Cailynoo7/CalcKey/product/gallery/8fa5844386364da2.jpg

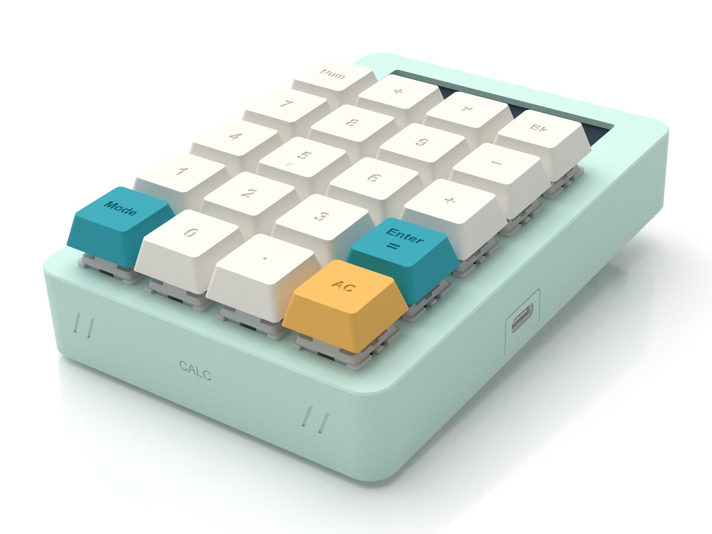
product/gallery/8fa5844386364da2.jpg
