Cailynoo7/CalcKey/product/gallery/calckey-mint-cover.png

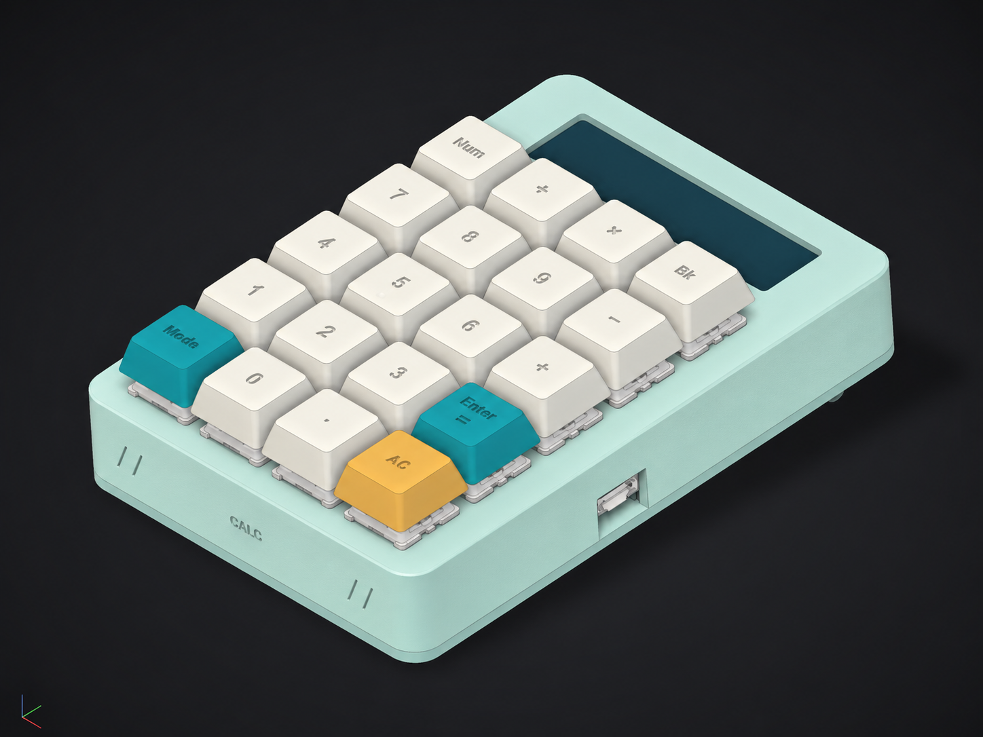
product/gallery/calckey-mint-cover.png
