Cailynoo7/CalcKey/product/README.md

# CalcKey 双模式数字键盘 / 计算器

## 产品目标

参考用户提供的EDA-Keypad，制作小型桌面设备：接电脑时作为扩展数字键盘；接USB充电器时独立计算。用户要求取消干电池并减薄机身。设备采用外接电源，不依赖电脑上的计算器程序；拔掉USB后关机。

## 平台方向

采用用户指定的Waveshare RP2350-Plus-16MB无排针版，SKU 29761，原生USB Type-C。此板不在平台索引中，用户已授权使用库外板，厂商原理图、引脚图和系列STEP为依据。保留GDM0103和73×96×1.6mm双层矩阵PCB，GPIO关系不变；不新增USB转接小板。

## 功能和交互

- 接电脑后以标准USB HID数字键盘工作，默认目标为Windows 11、macOS、Linux；实际兼容性需实机测试。
- 接5V USB充电器、未枚举USB主机时，进入本机计算器模式。Mode键允许接电脑时仍在本机计算；计算器模式不向电脑发键。
- 支持十进制加减乘除、小数、负数结果、退格、全部清除、除零和溢出提示。按桌面计算器式逐步运算，不实现表达式优先级或科学计算。
- 屏幕改用8位段码LCD显示输入和结果；负号占一位，小数点使用独立段，超出范围报溢出。模式切换短暂显示PC/CALC、错误显示Err，不能常驻完整运算符；最终显示十进制四舍五入，0.1+0.2显示0.3。
- 供电检测与USB主机连接检测分开；不能把USB有电等同于电脑连接。切换模式前释放HID按键，主机挂起时不反复切换模式。

## 已披露的默认值

20个佳达隆GATERON KS-9三脚机械红轴，订货识别型号KS-9H10B045NN-X14，官方CAD标识KS-9H10B045NN-X14-FB，4列5行，首版允许焊接，不含热插拔、RGB、旋钮、蓝牙或上位机。键帽由用户确定改为3D打印，采用自制等高1U平顶帽体与一体MX十字插座，不沿用外购DSA件。布局如下：

| NumLock | ÷ | × | Backspace |
| --- | --- | --- | --- |
| 7 | 8 | 9 | − |
| 4 | 5 | 6 | + |
| 1 | 2 | 3 | Enter / = |
| Mode | 0 | . | AC |

NumLock在本机计算时保留，AC在电脑键盘模式只本地清除，不发送意外快捷键。

屏幕选Good Display GDM0103，HT1621B驱动，8位段码TN LCD；明确订购3.3V版本及6点钟视角。整板78×26×10mm最大，可视60.5×13.5mm，图形57.15×10.70mm。初版不接背光，环境光下使用半透正显。P1 /CS、P2 /WR、P3 DATA分别接GP11、GP1、GP0；P5 VDD接3V3，P4 VSS接GND。

## 外接供电与形态

用户确定使用USB充电器，取消干电池、电池盒、电池仓、仓盖及电池开关，不配电池，不使用主控板载充电支路。机身外露口采用USB Type-C母座，同时用于USB 2.0 HID数据和5V供电，正反插可用；电脑与充电器择一接入。改用Waveshare RP2350-Plus-16MB板载Type-C接口，不使用转接小板。默认保留USB-A输出5V/1A适配器，改配USB-A至USB-C数据线；可复用已有适配器。主控通过两只独立绝缘压桥固定，不沿用原版Pico安装孔；原厂板载电池座保持不接。

用户要求收紧按键周边边框，屏幕靠近按键，并改为独立底部盖板。默认塑料主体外廓89×130×21mm；顶面与侧壁一体主壳、独立底盖为PLA/FDM件；两只翻折角柱脚、两根销轴及两只盲帽为PETG/FDM件，外壳机构与两只主控压桥共十个打印件；另有20个单独打印键帽。底盖以4颗M3圆头螺钉从下方固定。Waveshare主控横置按键下方，Type-C位于右侧；开口按原厂插座正面设置9.44×3.66mm圆角长孔，每侧留0.25mm间隙，内侧为金属壳避空，底盖通过绝缘压桥固定主控。GDM0103由底盖四处PCB边缘托架和0.15mm绝缘胶片支撑固定，不依赖未完整标注的安装孔；PCB底z7.4mm，不装直立排针。21mm为未倾斜时的塑料主体局部高度。用户要求简单科技感、后高前低，以及收起略垫高、翻起更高的两个角柱后脚。默认收起约2.41°、展开约4°，翻转行程110°；展开时后脚相对世界竖直向后约24°，受压力矩压向实体限位，两档脚底均按水平桌面切平。后脚宽10mm、主体长8.5mm、厚3.6mm，左右支点距中线各29.5mm（中心间距59mm），两只前脚采用直径12×2mm硅胶垫。打印销轴贯穿底盖轴耳和后脚，盲帽只胶接轴端；按用户希望缩短盲帽，默认端帽Ø5×2.4mm，与另一端Ø5×1.5mm挡头接近，销轴入帽1mm、帽底保留1.2mm。卸载后不是锁定铰链。主壳外缘0.4mm细倒角，前侧浅刻CALC与四条短斜线。按自制键帽的暂定安装位置计算，桌面至最高点收起约39.50mm、展开约42.10mm。用户要求显示屏加宽至接近原来的两倍并采用市售8位LCD。窗口现为64×16mm（宽度为原32mm两倍），保护片67.6×19.6×1mm，底侧槽68×20mm；屏幕中心仍为(0,49)，与首排打印键帽边缘距7.30mm。外廓89×130×21mm不变。用户跳过打印试配；实际卡扣保持、键帽插拔与LCD承托带未实测，不能把此选择记作验收通过。

默认打印键帽尺寸18.2×18.2×7mm，顶宽14.4mm、侧壁1.2mm、顶厚1.6mm；中心插座外径5.6mm，十字孔总长4.10mm、臂宽1.40mm、盲孔深3.3mm，入口内缩1.4mm，不扩口以保留端壁。采用PETG，默认0.2mm喷嘴、0.1mm层高；用户选择跳过打印试配，直接完成20只正式键帽与整机设计。5键采用直径2mm、深0.35mm的浅圆凹定位点，保持顶面朝下打印；Enter与=上下双标识。字形统一Arial Bold并按实际轮廓居中，数字/运算符默认字号4.8mm、文字键3.3mm、凹刻0.35mm，顶面边缘至少保留1mm。字号为字体参数，不等于实际字形高度。上述孔隙是自制件试配起点，不是佳达隆制造公差；插座下段削平至4.9mm宽，入口局部最薄壁约0.40mm，需精细打印并检查裂纹。按官方模型支承底面至轴顶10.2mm定位，键帽底距面板5.5mm，止挡距帽底4.7mm，名义座高由已用模型确定，打印收缩、松紧与强度未实测。

## 参考资料

- [用户提供的EDA-Keypad](https://wiki.lceda.cn/zh-hans/course-projects/mcu32/32-rp2350-eda-keypad/eda-keypad-introduce.html)：2026-11-04阅读，原项目基于ColorEasyPico2 RP2350，接主机为HID、接电源为计算器。
- [Waveshare RP2350-Plus官方资料](https://www.waveshare.net/wiki/RP2350-Plus)：原生Type-C、主控引脚、原理图及系列STEP；16MB无排针版SKU 29761。原厂参考与保形修复版本均保留来源记录。
- [GATERON KS-9官方页面](https://www.gateron.com/products/gateron-ks-9-switch-set)及[官方3D](https://www.gateron.com/pages/3d)：三脚红轴参数与STEP；用户已核对并确认所选KS-9与-FB标识模型对应一致。FB字面含义未据此推断。

## 验收目标

1. 接电脑后在文本编辑器/表格中可输入0–9、小数点、运算符、回车和退格，NumLock与主机交互正确。
2. 只接5V USB充电器，不接电脑，能完成12+34=46、7−10=−3、1.5×2=3、8÷4=2、0.1+0.2=0.3；除零报错，AC恢复。
3. 连接电脑后可切换本机计算，计算期间主机不收到本机计算按键。
4. 长按、切换模式、重复拔插后无按键卡住，切换时屏幕短暂显示当前模式；移除唯一USB电源后关机。
5. 主壳与底盖容纳实际主控、屏幕和线束，按键全行程不蹭壳、显示完整可见、USB可插拔；交付检查过的STEP。两只角柱后脚在两档位置应与前脚垫稳定落桌，翻转顺畅、压向限位，销轴和盲帽固定及按键抗倾覆以试制验收为准。

## 实现边界

部件清单、接线、约束和外壳需一致反映USB外接供电。固件负责USB HID、矩阵扫描去抖、计算、屏幕和模式状态机。验收描述是产品目标；固件实现与编译测试记录见独立固件说明，实际整机和电气性能仍须实物验收。

## 接线与制作资料

使用当前矩阵PCB四页A3焊装图、逐项操作手册和59项空白断电记录；20键测点、J1～J10及LCD正反面端子均按PCB版资料定位。矩阵10根引线（5行、4列、3V3）与LCD五线共15根，各默认150mm，共2.25m，建议采购3m。四个10kΩ/0805电阻及20个1N4148-TAP装在PCB底面，不再手工并行列总线。矩阵无GND端子，J10只接3V3 OUT。矩阵GPIO沿用既定接线，主控使用v0.3.0固件；LCD P1 /CS接GP11、P2 /WR接GP1、P3 DATA接GP0、P4 VSS接GND、P5 VDD接3V3。P6–P9无外部连接，分别绝缘。先分段焊接及断电测量，实物记录保持待测，未授权前不通电或烧录。旧SSD1315固件v0.1.0不适用于当前LCD。

选型依据：[厂家GDM0103页面](https://www.qiyun-display.cn/Products_1/55.html)、[厂家署名手册镜像](https://www.radiomag.com.de/datasheets/gdm0103_specification.pdf)第3/7/8页、[市售模组页面](https://www.logifind.com/products/gdm0103-ht1621-driver-8-bit-wide-temperature-lcd-module-segment-code-lcd-module-lcm-lcd-display-module)。厂家网页9.8mm与手册10mm上限不一致，CAD按10mm设计。官方附件403，未据此虚构内容。

## 制作交付边界

按用户要求跳过打印验证，正式包提供30个机构/压桥/键帽打印件的派生网格、含矩阵板与20轴的整机STEP、矩阵PCB发布的Gerber和钻孔文件、31项部件清单、制板及手工焊装采购资料、PCB焊装图与断电操作手册，以及适配RP2350-Plus-16MB的LCD固件v0.3.0。试配片和三种试配帽保留在项目中作为可选历史资料，不列入正式采购或交付前置条件。制作资料准备不启动打印、不连接设备、不烧录；实机功能和结构性能留待实际制作后验收。
