Cailynoo7/CalcKey/design/enclosure/README.md

# CalcKey：Type-C数字键盘与八位计算器

## 产品与造型
用户指定Waveshare RP2350-Plus-16MB无排针版，SKU 29761，替代原版Pico 2；不额外增加USB转接小板。主控不在平台索引中，使用用户授权的库外器件及原厂RP2350-Plus系列STEP。板载电池口保持悬空，不配电池，不使用其充电功能。电脑USB枚举后为HID数字键盘，只接5V USB电源时为本机计算器。
造型保持89×130×21mm紧凑顶侧一体主壳、独立底盖、两档翻折角柱脚；主壳、底盖和主控压桥为浅薄荷绿sRGB #C4E4DA，键帽配色保持。前侧CALC浅刻、上缘0.4mm倒角和各键布局均保持。屏幕为GDM0103/HT1621B，3.3V、6点钟视角，初版不接背光；64×16mm窗口、67.6×19.6×1mm保护片、底槽68×20mm，胶框厚0.15mm。

## 主控与USB-C接口
主控板框51×21mm，PCB中心局部(17.3,-10)，原厂STEP PCB顶面局部z6，USB向右。原厂模型PCB表现厚0.41148mm，未给实物板厚公差，不把此数当作收货公差；实物板厚、焊点和压桥座高要复核。原厂4MB/16MB系列共用STEP，芯片外形与接口按此源验证，不声称16MB实物元件高度已测。
主控没有原Pico的四个安装孔。底盖四处边缘座与两只独立PLA绝缘压桥固定板边，4颗ISO4762 M2×6沉孔座螺钉，螺钉不穿板、不压芯片。压桥中心局部x=12.9/24.9，y=-10；桥宽6、上板厚3、桥下表面z8.2，脚间螺钉轴距32mm。四个下座面z5.43852，四个上夹持面z6.15，每面各贴6×1.4×0.15mm绝缘胶片，共8片。夹持面避开裸铜和焊点，桥不压BOOT/RESET；现有模型名pico2仅为稳定对象ID，显示名已更换。
真正外露USB孔按原厂STEP Type_C1正面金属口轮廓建模：8.94×3.16mm、四角R1.28，竖向直线段0.6mm；不是把整个组件含焊脚的包络当成口部。portcut PortSpec圆角轮廓每侧外扩0.25mm，形成9.44×3.66mm、R1.53的圆角长孔，局部中心(44.5,-9.9900469477,7.669521495)，较上版上移约0.5mm。正面外唇轴向深0.7mm，内部另用portcut切10.18×4.76mm避空容纳后部较大的金属壳；周围立台仍为2.4mm厚。插座前缘内缩0.3881mm，未加外侧大凹口。实际USB-C公头胶壳与插到底状态仍待断电试插，默认胶壳包络不大于12.35×6.5mm、外侧直线段留25mm。
圆角长孔位于底盖一体接口立台，立台宽14.5、高11.2、厚2.4，根部与底盖融合，不是独立小盖板。主壳留下每边0.25mm维护接缝；外侧立台边界不是USB孔。内部为PCB前缘留薄槽及向下退出通道，局部余壁1.45mm，其余常规侧壁2.4mm。开口形状和通道由库轮廓与原厂STEP核定，不用大方孔替代Type-C。
电气依据：https://www.waveshare.net/w/upload/c/ca/RP2350-Plus-details-inter.jpg 及 https://files.waveshare.com/wiki/RP2350-Plus/RP2350_Plus.pdf 。原生USB数据对已内接，CC1/CC2各5.1kΩ下拉；不焊测试点，不启用PD高压请求。

## 矩阵、键帽与LCD
矩阵发布17123bc08553010640eaa377912e790923ec95a26949b1e102fa73c7f9b2c727保持，不改变Gerber、板形或GPIO。73×96×1.6mm双层FR-4，由20个焊接KS-9轴连接固定，板背20只1N4148-TAP和4只10kΩ/0805。J1～J5接GP2～GP6，J6～J9接GP7～GP10，J10接3V3/物理36；矩阵没有GND端子。
LCD P1 /CS→GP11/15、P2 /WR→GP1/2、P3 DATA→GP0/1、P4 VSS→GND/38、P5 VDD→3V3/36，P6～P9各自绝缘不接。LCD仍在底盖边缘座上以0.15mm绝缘胶片粘接，PCB底z7.4、座面z7.25，中心(0,49)，四处承托x±38.2、y41/57；背面元件和座面无铜区须实物核对，无精确LCD三维模型。
20只PETG键帽维持18.2×18.2×7mm、壁1.2、顶1.6、字槽0.35mm，Arial Bold统一布局，5键D2×0.35mm浅定位凹点，Enter/=上下双行。插座外径5.6、下段两侧削至4.9，十字孔4.10×1.40mm、深3.3、口内缩1.4，局部最薄壁0.40mm。官方KS-9为融合模型，内部独立运动并未精确建模；实际卡扣和键帽配合须实物检查。用户已确认X14与CAD-FB对应一致。

## 制作和装配
正式打印件30件：PLA主壳、底盖、两只主控压桥；PETG两只翻脚、两根销轴、两只端帽和20只键帽。Pico历史件不再装机，Waveshare主控、矩阵及轴体、LCD、螺钉和亚克力片不打印。
壳体默认0.4mm喷嘴、0.15mm层高、4壁、20%填充；压桥建议100%填充，沉孔向上，板边压脚向下，局部支撑只托桥底非接触区，清理后贴绝缘胶片。底盖外侧朝下、座面和接口立台朝上，轴耳/限位局部支撑；Type-C胶囊顶弧可桥接或用可移除局部支撑，不在狭小插口内留下难以清理的支撑。主壳键面朝下、底部开口朝上，内伸线束桥需局部支撑，避开卡扣、螺纹孔及穿带口。键帽0.2mm喷嘴、0.1mm层高、顶面朝下，帽腔向上、孔内不放支撑。整机倾斜姿态不是打印朝向。
合盖4颗ISO7380-1 M3×8；主控压桥4颗M2×6，8处接头来自printed-screw-joint-v1，沉孔头低于桥面0.2mm。打印自成形孔只轻拧，实际扭矩和寿命未测。先粘绝缘垫、低位直焊主控15线，再安装压桥，焊后线皮和焊点不得被夹。LCD/保护片沿用边缘座及薄胶方案，先做断电逐线检查再合盖。
后脚中心距59mm、宽10、长8.5、厚3.6，轴孔2.8、销轴2.4×17.8，挡头D5×1.5、盲帽D5×2.4、盲孔D2.6×1.2，轴端入帽1mm。双组份环氧仅用于轴端与帽内孔，不粘轴耳/转动面；胶材须按厂家说明固化。两档倾角约2.411°/4°，110°实体限位，展开略后倾；卸载不自锁。前垫D12×2，两档脚底仍贴世界Z=0，支脚与键帽几何未改；承载和反复翻折无实测。

## 理线与维护
每根总长150mm，10根矩阵线+5根LCD线共2.25m，采购建议3m；26AWG线皮外径≤1.3mm。矩阵跨壳每根至少65mm未粘死自由段，默认弯曲内半径≥5mm。五个原有穿带桥均保留：主壳2、底盖3，孔10.6×2、桥顶1.6，沿用10mm宽总厚≤0.1mm聚酰亚胺胶带，裁5条10×65、搭接≥15mm，只夹线皮。
新增压桥占用了旧宽扇出预算。跨板的3V3/GND三根电源引线使用桥间5×23×1.5mm预算，局部中心(18.9,-9.5,10.05)，不是让15线一起挤入该通道。信号沿板前缘分散出线，预算45×1.5×1.5mm、中心(17,-21.7,7.1)，不是全束等截面导管。右侧矩阵余线预算缩为20×16.8×3mm、中心(26,-39,4.55)；左矩阵与LCD余线保持。所有预算是刚体空区，不认证柔性线形变、胶带保持力或线束全程。
维护先拔USB、卸4颗M3，手托底盖沿局部负Z下放30mm，主控、压桥、M2螺钉、接口立台、LCD和翻脚随底盖移动。保留定位唇2mm高、0.3mm侧隙，不需要横向硬撬USB。不能靠线束吊底盖；完全分离仍需断开相应焊线。实物夹持与开盖顺畅度待验。

## 当前数字验证与边界
revision 18faaed5c6a9c41229a5fc888c20458ccf315f3c0712424836f5007b8f745c59。已发布模型除矩阵原KS-9定位筋外，无新增未声明穿插。matrix_pcb/top共有体积约3.187321mm³，网格深0.1374mm，compliant预算0.16mm，沿用既有记录；不以此宣称卡扣保持力已测。
底盖组件直接下放30mm，网格弦差0.02mm、步长0.5mm，62个姿态，无穿插；起始主壳接触为正常闭合。20键分两批沿局部负Z下压4mm，步长0.25mm、17姿态、网格0.02mm，无新增刚体干涉，距主壳最小1.5mm。主控到矩阵组件最近3.8989mm；压桥A/B到矩阵0.61/0.62mm，控制板螺钉到矩阵0.82mm。板与夹持面0.15mm间隔留给胶片。右余线区距底盖最近0.4334mm；电源跨板区距桥0.5、距主控0.8mm；前侧分散出线区距底盖与桥均0.35mm。均为0.02mm网格测量，不等于实测公差。
固件v0.3.0以waveshare_rp2350_plus_16mb编译，保留双模式及8字符计算，GPIO无改动；桌面测试和板级交叉编译结果见固件记录。未打印、未上电、未烧录；实物板厚、夹持松紧、胶片强度、USB-C公头正反插/胶壳就位、LCD承托与视角、电气性能仍待验。
当前主控参考已替换为保形修复STEP：仅对USB壳体故障实体在装配坐标中做拓扑修复并转换为等价NURBS，保留原厂层级与配色；其余121实体保持原样。原厂原始STEP仍保存，不覆盖。修复前后双向差集体积均0，整板包络坐标差0，高精度体积差约0.00000428mm³；两次参考模型重读及整机565实体的内存重读均有效。常规体积积分因曲面参数化改变而可能有微小读数差，不以此当作材料增减。除主控参考表面表示外，各打印件、Type-C开口9.44×3.66mm及全部装配位置保持不变。最终STEP交付以本轮完整校验结果为准。当前Type-C制作包采用30个打印件；主壳、底盖及两只压桥由本版已校验STEP转换，另26件经几何和安装位置核对后复用，具体版本和文件哈希以当前模型清单及完整制作包清单为准。原矩阵PCB制造发布不变，原打印键帽及翻脚网格形状保持，但版本绑定须在后续制作包同步时重做。

## 来源与接口
接口controller_fit、display_fit、key_fit、power_fit、keycap_stem_fit保持。历史参考标识pico2_vendor现在指向Waveshare系列STEP，避免改变接口引用；主控选型为用户明确指定的库外模块。
- 原厂产品：https://www.waveshare.net/shop/RP2350-Plus-16MB.htm ，16MB无排针、SKU29761；不承诺库存和成交价。
- 原厂资料：https://www.waveshare.net/wiki/RP2350-Plus ，原理图及原厂共享系列STEP https://files.waveshare.com/wiki/RP2350-Plus/RP2350_Plus_STEP.zip ，STEP SHA256 650977cc5a1bbeaab4eabdefd3f547642a1c34a5a8e5cbf49ac6f8b575c979f4。
- LCD：https://www.radiomag.com.de/datasheets/gdm0103_specification.pdf ，第3/7页机械、第8页接线，真实整板STEP仍未取得。
- KS-9：https://www.gateron.com/pages/3d ，厂家融合STEP及既有用户型号确认。
- 原矩阵PCB发布和丝印、采购数据沿用设计matrix及其当前制造记录。

## 可插拔连接器评估边界
矩阵10线可考虑线中对插接头，候选JST SM 10P与低矮板端插座的比较见产品评估。仅做临时包络探测，未加入模型、未改PCB、正式BOM和接线保持直焊。左侧24×35×9mm临时预算通过刚体净空检查，但不等于连接器、线弯和解锁操作已验证。

## 主控参考修复的来源
原厂STEP SHA256 650977cc5a1bbeaab4eabdefd3f547642a1c34a5a8e5cbf49ac6f8b575c979f4保留为上游证据；当前派生STEP SHA256 a6dc199a3a4e298685d6ed8e8ca74fd55980cce419e5dcee973fb04c4cd22006。派生过程只处理输入参考文件，没有在外部重放外壳CAD；实际导入、装配与交付仍由当前CAD构建记录。修复不代表实物板厚或夹持已验收。此前无效面和超时诊断作为历史记录保留。
