Cailynoo7/CalcKey/design/matrix/README.md

# CalcKey 20键矩阵PCB

主控采用Pico引脚兼容的RP2350-Plus-16MB，保留GDM0103，增加4列5行的被动矩阵PCB。本板不承载主控或LCD，不另设USB、稳压器或电池。沿用GP2～GP6行、GP7～GP10列，3V3为四个10k上拉供电；LCD五线仍直接焊至主控。PCB已完成布线与发布，Gerber、钻孔及三维机械交付均已生成。全部器件手工焊装；JLC贴片CSV为空。

默认73×96×1.6mm、双层FR4、1oz铜，顶面朝按键，底面为维修侧。板中心对应外壳局部(0,-14)，顶面z16、底面z14.4；20轴由原打印面板夹持，PCB通过20轴的焊脚连接固定，不新增壳体螺柱。轴体为已确认KS-9H10B045NN-X14，焊接式，不使用热插拔座。

器件默认：20个原型号1N4148-TAP轴向二极管在板背卧装；四个10k±1%、1/8W上拉改用0805W8F1002T5E（0805，可手焊）。J1～J10为PCB背面直接焊线的焊盘，分别为ROW0～ROW4、COL0～COL3、3V3，共10根26AWG柔性引线，沿底面平铺。LCD另用5根引线。无需GND连接到本被动矩阵板，也不铺无电气用途的地铜。

每键电路为COL→SW→二极管A→K→ROW；二极管黑环朝K，库封装pad1为K、pad2为A。矩阵PCB上的丝印与断电极性检查须以最终发布资料为准。旧版手焊行列指南及完整包保存的是此前手焊整机，不用于代替本板Gerber。

机械依据：沿用19.05mm键距和原20轴中心。KS-9原厂STEP测得安装面到板上方定位根部5mm，PCB上表面与该高度对应。原厂STEP中两电触点相对中心柱约(-5.06,+2.54)、(-2.5376,-3.8)mm，KiCad三脚Plate型封装转90°后为(-5.08,+2.54)、(-2.54,-3.81)mm，孔径1.5；中心柱孔径4mm。已对原厂CAD进行截面测量，最终仍需检查实际发布模型、钻孔及与外壳的间隙，不能仅据通用MX名称判定兼容。

## 来源

- GATERON官方KS-9 STEP：KS-9H10B045NN-X14-FB；https://gateron.com/u_file/2306/26/file/KS-9SwitchKS-9H10B045NN-X14-FB.rar ，SHA256 29f4d60beb57a869d233939c629de23319458d225f0be6644fd86258533e3c9d。供应商目录无精确KS-9行，轴体按已确认型号外购，不接受检索的模糊近似件。
- KiCad官方标准库：Button_Switch_Keyboard/SW_Cherry_MX_1.00u_Plate，Diode_THT/D_DO-35_SOD27_P7.62mm_Horizontal，Resistor_SMD/R_0805_2012Metric，Connector_Wire/SolderWirePad_1x01_SMD_2x4mm。直接引用标准封装，不另画替代焊盘。
- Vishay 1N4148-TAP，LCSC C917479：https://item.szlcsc.com/992944.html ，厂家手册第1页订货号/黑环、第3页DO-35引脚0.55mm最大、体长3.4mm最大、直径1.75mm最大。板上弯脚间距7.62mm，为项目装配默认。
- UNI-ROYAL 0805W8F1002T5E，LCSC C17414：https://item.szlcsc.com/18102.html ，10kΩ±1%、125mW，0805封装；手工焊接，不宣称已提交贴片厂。

打印试配仍按用户选择跳过；本任务不烧录、不下单、不供电。电路检查与数字装配验证不等同实物验收。

## 交付与装配结果

当前PCB发布：17123bc08553010640eaa377912e790923ec95a26949b1e102fa73c7f9b2c727。检查报告为0个DRC错误、0个逻辑未连接，保留非阻断的库/元数据告警；已检查正反面、Gerber和钻孔。20个4mm非金属中心柱孔、40个1.5mm轴触点孔、40个0.8mm二极管孔、8个0.3mm过孔均在发布钻孔报告中。

发布装配已导入整机，20轴与PCB是一个导入装配分组，各轴仍为独立实体。Type-C版主控到矩阵组件最近约3.8989mm，两压桥到矩阵约0.61/0.62mm（网格0.02mm）；底盖下放30mm检查无新增穿插，步长0.5mm、62姿态。PCB发布及GPIO不变，整机主壳/底盖已更新并新增两只压桥，正式打印件30件；不把原Pico版整机装配结论直接套用。

供应商目录无精确KS-9匹配，仍按用户已确认的原型号外购；官方模型、孔位、引脚及安装方式已核对。发布中的外购证据提示属于提醒，不要求用户再次确认相同型号。实物强度、焊接、卡扣与通电未测；先不烧录。装配与10根主控引线的逐项表见本设计的assembly说明。
