Cailynoo7/CalcKey/manufacturing/matrix/releases/17123bc08553010640eaa377912e790923ec95a26949b1e102fa73c7f9b2c727/package/drill/matrix-drill-report.txt

Drill report for board.kicad_pcb
Created on 2026-11-06T01:17:43

Copper Layer Stackup:
    =============================================================
    L1 :  F.Cu                      front
    L2 :  B.Cu                      back

Drill file 'board-PTH.drl' contains
    plated through holes:
    =============================================================
    T1  0.300mm  0.0118"  (8 holes))
    T2  0.800mm  0.0315"  (40 holes))
    T3  1.500mm  0.0591"  (40 holes))

    Total plated holes count 88

Drill file 'board-NPTH.drl' contains
    unplated through holes:
    =============================================================
    T1  4.000mm  0.1575"  (20 holes))

    Total unplated holes count 20
