Cailynoo7/CalcKey/product/matrix-connector-assessment.md

# 矩阵PCB可插拔线束评估（尚未实施）

结论：优先考虑在线束中加入一组10芯、带锁扣防反插的对插接头。它能保留现有矩阵PCB和主控焊盘，维修时只拔接头，不必重新焊10根线。此次仅作评估，连接器没有加入CAD、PCB或正式部件清单；GPIO和直焊接线均未改变。

## 候选与取舍

- 首选结构：JST SM 2.5mm，SMR-10V-B（C566663）＋SMP-10V-BC（C595196），各1只；SYM-001T-P0.6与SHF-001T-0.8BS端子各10只。厂家图第1、2、4页：插合长度22.9mm、宽28mm、含锁扣高8.7mm。支持22～28AWG，但绝缘外径要1.2～1.8mm；结合当前线束≤1.3mm限制，所用26AWG必须同时满足外径1.2～1.3mm。建议采购成套压接线，不在微小压接端子上随意堆锡。查询时SMR-10V-B缺货，暂不作为采购定案。
- 备选：两组5芯SM。外壳两侧均查到货源，但同形5芯接头可能误插；采用前必须用相反公母组合或不同机械键位防混，不能只贴不同颜色。两组位置和插拔路径尚未验证。
- 板端方案：CJT A1257H-10P（C339046）配A1257WR-S-10P。可减少悬在线中的接头，但需要新增PCB封装、布线、发布和装配验证；现有J1～J10分散焊点不能直接焊成这个插座。其端子A1257-TP用于28～32AWG、线皮≤1mm，不能直接沿用26AWG。A1256H-10P同样是线对板家族，不应把两只胶壳当成一组线对线接头。

## 当前壳内空间

只用临时探针评估，没有添加模型。以底盖局部坐标(-24,-29,7)为中心，24×35×9mm预算距底盖0.10、矩阵组件0.31、主壳1.06、主控3.80mm，网格精度0.02mm。预算刚体不相交，但高度余量偏紧；它不是实际连接器模型，不能认定已经装得下。

该位置还会占用现有左侧矩阵余线区，需要重排线环，不能把余线叠在接头下方。实际外壳公差、锁扣解锁空间、手指操作、线口弯曲和接头固定均未验证。应在底盖下放后解锁、握两端胶壳拔开，不靠线束吊底盖。65mm维护自由段不得把接头本身算进去。

## 拟议针序与验收

接头腔号1～10依次对应矩阵J1～J10，主控对应仍为原接线。J10是3V3 OUT，不是GND；矩阵没有GND端子。腔号按厂家图和实物标识确认，两边对视会产生镜像，不能凭线色判断。

采用前需完成：精确胶壳/锁扣包络及公差核对、余线和固定方案、30mm开盖后解锁路径、逐线断电导通与相邻短路检查。此接头不是热插拔接口，维护必须拔USB。LCD五线都在底盖侧，无须为了分离上下壳一起改接头。

此次没有下单、打印、上电、烧录或填写实测值。详细型号、临时预算与待核项见配套评估记录。
