Cailynoo7/CalcKey/product/mx2a-fit-review.md

> 历史CHERRY选型核对；当前已选GATERON KS-9，当前装配结果见KS-9装配核对。

# MX2A-L1NN模型查找与按键安装核对

说明：本文件记录e91ebb7阶段的查找与参考帽核对；后续用户已选择打印键帽，20个实际帽体和十字插座已另行建模，见自制键帽试配指南。轴体精确STEP未找到的结论保留。

核对日期：2026-11-05。对象：已选CHERRY MX2A-L1NN，20只，EAN 4025112104640，3针面板安装、非RGB红轴。

本轮未获得能够核对到该型号的STEP/STP文件，未向装配中添加其他型号或自绘近似轴体。现有整机CAD和导出保持不变。20个轴体补齐、轴芯与键帽插座配合、弹性卡扣保持力均未完成验证。

## 已查资源与结果

| 资源 | 本轮观察 | 能支持的结论 |
| --- | --- | --- |
| 内置机械组件目录，查询CHERRY MX2A-L1NN keyswitch | 0候选 | 没有可获取的精确组件；未获取替代件 |
| step.parts，分别查询CHERRY MX2A-L1NN、MX2A、Cherry MX | 三次均0匹配 | 该渠道此次没有可下载的候选 |
| CHERRY MX RED产品页 | 列出MX2A-L1NN、EAN 4025112104640 | 与已选身份一致；不是STEP证据 |
| CHERRY产品下载中心 | 可见的文件条目为多语种数据表 | 本次页面未找到精确轴体STEP链接；不表示厂家没有内部模型 |
| 产品页精确型号数据表链接 | pim.cherry-world.net/datasheet/23119?locale=en_US 返回403 | 该URL本轮未读；不凭失败补尺寸 |
| 旧官方Data_sheet_MX2A_Red.pdf路径 | 返回404 | 不把搜索摘要当作已下载机械图 |
| CHERRY署名MX2A资料，JW-shop镜像spec-MX2A.pdf | 已下载8页组合资料；第7–8页为MX2A RED | 确认4mm总行程、L1NN为3针框架卡扣安装，L1NW为5针PCB安装；没有精确卡扣尺寸图 |
| 现有CHERRY署名14页新版资料 | 第10–11页为MX2A_L1NN，EAN 4025112120954，15.63×15.63×18.5mm | 身份标识与主选不同，仅保留为系列参考，未替换主选 |
| 通用MX社区模型 | 检索到的一个2018年模型作者声明约85%准确，且不是MX2A专属 | 拒绝用于精确卡扣、肩位和十字轴配合验收；未下载/导入 |
| CHERRY历史Keymodule MX目录，Deskthority镜像 | 已下载并查看第3页装配图 | 通用MX框架孔14±0.05mm、角R0.3max、夹持厚度1.5±0.1mm；属于历史系列接口参考，不能等同于本型号带公差图 |

资源URL、文件指纹及检索观察另见配套研究记录。未向厂家或经销商发送询问。

## 对当前模型的实际测量

设计版本：e91ebb786b2947414eb4ac10786b0ea728dacdf24428674faa5e2d591ebd7d0e。以下为未倾斜的壳体局部坐标；整机共同绕X倾斜4°不改变安装法向间隙。

通过只读几何切片，在20个键中心各取17×17×0.02mm探测片，减去实际主壳，量取孔的空域边界；并读取当前参考键帽的源尺寸：

| 检查项 | 本轮测得/读得 | 判读 |
| --- | --- | --- |
| 20个上层轴孔，z=20.5mm切片 | 全部14.2×14.2mm | 不存在某一孔漏切或大小不同；此值仍为打印试配默认值 |
| 20个下侧避空，z=18.75mm切片 | 全部16.4×16.4mm | 不等于完整卡扣压缩、回弹路径已验证 |
| 主壳键面总厚度 | 3.0mm | 下侧退让保留薄夹持台阶 |
| 卡扣夹持台阶厚度 | 1.5mm | 与历史MX名义值相符；不代表打印误差和实物卡扣保持力已合格 |
| 夹持下缘局部z | 19.5mm | 面板顶21mm，差1.5mm |
| 参考键帽底/顶局部z | 26/33mm | 帽高7mm，底部距键面5mm；均为参考模型尺寸 |
| 参考键帽内顶局部z | 31.6mm | 只有帽壳，没有十字插座和插入深度，不能确定实际键帽就位高度 |
| 20个参考键帽沿面板法向下压4mm | 两批全部无首次接触/穿插，最近面板间隙1mm | 仅参考帽壳与当前外壳/底盖/Pico/螺钉的行程检查，不含轴体和真实键帽 |

路径检查精度：三角网格弦差0.02mm，每次最大移动0.5mm，每批9姿态。4mm局部负Z对应世界位移(0,+0.279025895,-3.990256201)mm。1mm是采样姿态中测得的最小间隙，不能当作真实键帽全公差下的保证值。

14.2mm比历史MX图14mm名义孔大0.2mm、比其14.05mm上限大0.15mm。当前值是给打印试配预留的设计尺寸，不是制造商公差；打印后的孔可能因工艺变小，也可能过松。缺少已选轴体尺寸与实际打印标定时，既不能把14.2mm说成原厂孔，也不应直接改成14mm后宣称装配通过。

## 完成20轴准确装配还需要的证据

1. 对应MX2A-L1NN、3针、非RGB、上述EAN或可证明同一机械版本的STEP/STP，以及可确认的来源和修订。应包含安装肩、卡扣外形、底座、定位柱、电触点和释放状态十字轴芯；若只有合并外形，至少须给出肩面基准与最大行程。
2. 对应型号的安装尺寸图：推荐孔形/孔公差、卡扣允许夹持厚度、肩面到十字轴顶的高度与公差、面板以下最大外廓和焊脚高度。弹性卡扣的压缩安装与保持力仍需实物试验，刚体无碰撞不能代替。
3. 已购DSA 1U键帽的具体型号或实物尺寸/真实模型：十字插座入口、深度和止挡位置。现有通用空白键帽选型没有这些细节，不能从参考壳体反推。

取得证据后的安装方法：以机械轴肩面贴合局部z=21mm的键面为基准，逐键放到现有19.05mm网格；按真实键帽插座与轴芯止挡确定高度，再做20处静态与4mm运动检查、卡扣压缩/回弹空间和下方绝缘接线空间检查。发现实体干涉则修正主壳对应结构并重新导出；没有明确依据时不改变已选器件。

## 可交给厂家/供货商的索取文字

请提供CHERRY MX2A-L1NN（红轴、非RGB、3针面板安装，EAN 4025112104640）当前供货版本的STEP/STP模型及带公差安装图，用于20键手焊数字键盘的面板设计。需要确认推荐开孔尺寸与圆角、卡扣夹持板厚、安装肩面至十字轴顶高度、4mm行程、面板以下壳体/定位柱/电触点外廓；请标明模型修订和坐标基准，并说明与MX2A_L1NN/EAN 4025112120954是否机械等同。暂不接受仅外观渲染图、MX1A通用模型或其他RGB/5针型号替代。

Please provide the STEP/STP model and toleranced mounting drawing for the supplied CHERRY MX2A-L1NN revision (Red, non-RGB, 3-pin plate mount, EAN 4025112104640). We need the mounting shoulder datum, recommended plate cutout and corner radius, allowable plate thickness, clip geometry, shoulder-to-stem height, 4 mm stroke, and maximum underside/post/contact envelope. Please identify the revision and clarify mechanical equivalence, if any, to MX2A_L1NN / EAN 4025112120954.

本轮结论是“来源查找及现有孔位核对已记录，准确装配仍缺模型与配合证据”。原外壳可继续作外形审阅；不能据此把20键机械固定结构作为最终制造验收通过。
