Cailynoo7/CalcKey/product/switch-alternatives.md

> 调研时点记录。KS-9现已获用户选用并导入20轴；当前结论见KS-9装配核对，本文“未导入”仅描述调研时点。

# CalcKey 轴体替代与三维资料调查

调查日期：2026-11-05。本次是候选调研，未替换现有 CHERRY MX2A-L1NN，未改变 BOM、接线、键帽或外壳，未打印或烧录。

## 结论

优先候选为 **GATERON KS-9 红轴、三脚版**：普通触点、线性手感，与现有手焊矩阵方向一致；官方已提供 STEP，不必先自行猜测外形。实际采购必须对应完整型号，当前取得的厂家文件标为 **KS-9H10B045NN-X14-FB**。当前商品页以 KS-9 系列销售，未把完整后缀列成可选 SKU，因此这仍是候选，不能声称某个商家出售的所有“KS-9 红轴”都与文件一致。

## 候选比较

| 候选 | 厂家公开参数 | 三维资料 | 对当前方案的影响 |
| --- | --- | --- | --- |
| GATERON KS-9 Red，三脚 | 线性，45±15 gf，预行程 2.0±0.6 mm，总行程最大 4.0 mm；未预润 | 官方 STEP 已下载，文件型号 KS-9H10B045NN-X14-FB | 优先候选；仍须核对完整后缀、面板卡扣、轴芯高度、打印十字插座及底部接线净空 |
| GATERON KS-8 Red，五脚 | 线性，45±15 gf，预行程 2.0±0.6 mm，总行程最大 4.0 mm；未预润 | 官方 STEP 已下载，文件型号 KS-8-X5，是系列参考，未标出红轴完整料号 | 次选；五脚中的两个附加塑料定位柱需要避让；手焊时仍只有两个电触点，不增加矩阵信号线 |
| GATERON G Pro 3.0 Red，三脚选项 | 线性，45±15 gf，预行程 2.0±0.6 mm，总行程最大 4.0 mm；已预润 | 官方提供系列 STEP，但取得的文件为 KS-9E10B055NN-Y51，不能当成红轴的精确文件 | 适合希望预润手感的方向；厂家同时销售三脚/五脚，不可混购；红轴具体模型对应关系尚未解决 |
| Kailh BOX Red | 官网列有 CPG1511 BOX 系列和二维机械图 | 本次未取得可核实的对应 STEP；图片下载超时，未把图内尺寸作为已核验参数 | 保留为后备，型号代次与卡扣尺寸未闭合，暂不据此改壳 |

这些候选均应按普通机械触点版本采购。磁轴、光轴需要不同检测电路，不适合直接替换现有矩阵。全高 MX 类仍须试配打印键帽，系列兼容名称不等于插座公差已经通过。

## 已取得文件及验证范围

官方来源为 https://www.gateron.com/pages/3d 。已保存三个原始 RAR 和各自解出的一个 STP，原始文件名保留，下载地址、大小与 SHA-256 见配套 JSON。

已完成归档清单检查、解压、非空检查，以及 STEP 文件起止标记检查。**这不是 B-rep 几何或装配验证**：本次没有将候选导入整机，未测得卡扣、支承肩或十字轴芯的实际尺寸。只读评估环境两次未能访问未绑定的参考文件，故没有得到有效几何测量；不能把这些文件称作“已通过装配验证”。后续应通过正式导入绑定资产后进行渲染、尺寸及干涉检查。

KS-9 的官方商品页描述透明 PC 上壳、乳白尼龙底壳；零售检索中同根料号还出现乳白壳描述。因此商品页参数只用于系列筛选，不能据此确认现货壳体、颜色和完整后缀与 2023 年模型相同。原始 CAD 下载不包含可据以承诺注塑公差的尺寸图。

## 如果没有三维模型，能否按参数复刻？

可以制作**用于外壳设计的参数化装配参考模型**，但精度取决于输入。只有“长宽高、压力、行程”不足以还原卡扣或键帽装配，不能把这种外形当作厂家精确模型。

完整装配参考至少需要：

1. 明确料号、代次、三脚/五脚、厂家图版本及单位。
2. 支承肩作为统一基准：肩面至壳顶、底面、自由轴芯顶、压到底轴芯顶的高度。
3. 面板开孔、圆角、允许板厚，以及卡扣钩高、侧向突出量、压缩空间、拆轴工具空间和相关公差。
4. 十字轴芯臂厚、跨度、锥度、有效插入长度、键帽止挡面及其公差。
5. 中心柱、定位柱和两个电触点的位置、尺寸与长度；焊点和导线的额外空间。
6. 未标注细节以实物测量补足；明确标记推测值，不从图片比例得出精密尺寸。

资料不足时只做包络和运动范围参考，卡扣/插座区域保持“待实测”。资料充分后，可建壳体、活动轴芯和引脚等必要实体，不必为整机装配复刻内部弹簧、触点材料与润滑结构。普通 3D 打印也不能凭这个模型制造具有相同性能的机械轴。

## 后续验证顺序

先锁定一个完整轴体型号，再正式导入它的厂家 STEP；检查轴芯十字、面板支承肩、卡扣和引脚，确认静止及压到底的位置。利用现有六孔试配片和 P0/P5/P10 三种键帽，先试一到两颗轴，记录扣合、拔出保持力、插拔松紧和全行程干涉。试配完成后才调整二十孔面板、键帽安装高度或整机模型。

现有试配片的孔宽 14.0/14.1/14.2/14.3 mm 与板厚 1.35/1.50/1.65 mm 是打印试验值，不是已确认适用于所有候选的厂家公差。

## 一手来源

- GATERON 官方 3D：https://www.gateron.com/pages/3d
- KS-9 官方商品页：https://www.gateron.com/products/gateron-ks-9-switch-set
- KS-9 参数图片：https://ueeshop.ly200-cdn.com/u_file/UPAW/UPAW819/2603/03/photo/gateron-KS-9-Switch-3pin-SMD16.webp
- KS-8 官方商品页：https://www.gateron.com/products/gateron-ks-8-mechanical-switch-set-1
- G Pro 3.0 官方商品页：https://www.gateron.com/products/gateron-g-pro-30-switch-set
- Kailh BOX 系列机械图发布页：https://www.kailhswitch.com/info/box-switch-product-detail-drawing-26296554.html

辅助采购识别来源（不作为精密机械图）：https://mechanicalkeyboards.com/products/gateron-milky-red-45g-linear ，列出 KS-9H10B045NN-X14，但未包含官方 CAD 文件的 -FB 后缀。
