Cailynoo7/CalcKey/product/production-review/2026-11-07.md

# CalcKey 实际制作备料与PCB参数核对

核对日期：2026-11-07。按一台整机核对现有28项部件与27行合并采购表、当前矩阵PCB制造包、28件打印材料。未下单、未上传订单、未支付、未打印、未上电、未烧录；未改设计、BOM、制造文件、Git规则或历史资料。此报告单独保存，未重新打包完整制作ZIP。

## 结论与必须落实的采购条件

现有清单覆盖本机需要的器件及辅料，没有发现必须新增的电子器件。装机数量、备品数量、PCB发布和打印件材料相互一致；这不代表商家库存、收到实物或实机装配已经验收。

1. **线材不能只按26AWG购买。** 现有空间约束要求绝缘外径≤1.3mm；缩略采购行未突出这个数值，询价时需一并写明。矩阵10根、LCD5根，均按150mm总长裁取，合计2.25m，建议共买3m，不重复采购两份3m。矩阵跨壳自由段≥65mm，LCD不跨主壳。
2. **LCD锁定GDM0103/HT1621B的3.3V、6点钟视角版本。** 使用78×26×最大10mm包络和低位直焊，P6～P9分别绝缘，首版不接背光；不按同名商品直接混买5V/不同视角或不同转接板。厂家页面为9.8mm，现有厂家署名PDF第3页以10mm最大值设计，保留较保守包络。[模组产品页](https://www.qiyun-display.cn/Products_1/55.html)
3. **线头和胶层厚度不能随意放大。** Micro-B设备端线头外形≤12×8mm，必须是可传输数据的线；保护片胶框及LCD承托胶片均为0.15mm厚，不用厚泡棉替代。Pico沿用Pico 2无无线版、裸板直焊，不增排针。
4. **区分装机数与卖家包装。** KS-9装20枚、建议备22枚；当前官方页面提供35枚包装，若从该渠道买，需按整包购买。其他卖家能提供22枚同型号拆零时可沿用22枚建议。此前用户确认的X14与-FB模型对应关系保留，不重新换型。[KS-9官方页面](https://www.gateron.com/products/gateron-ks-9-switch-set)

可直接用于线材询价的规格：

> 26AWG柔性绝缘多股线，绝缘后外径不大于1.3mm，共3m，供15根150mm短线裁切；用于PCB低位直接焊线。线规与绝缘外径都需满足，不只按“26AWG硅胶线”名称替代。

## 主器件与PCB焊装备料

| 项目 | 必须保持的型号/规格 | 每台装机 | 当前备料建议 |
| --- | --- | ---: | ---: |
| 主控 | Raspberry Pi Pico 2，无无线版，Micro-B | 1块 | 1块，可复用已有件 |
| LCD | GDM0103/HT1621B，3.3V、6点钟视角，78×26×≤10mm | 1块 | 1块 |
| 机械轴 | GATERON KS-9三脚红轴，KS-9H10B045NN-X14 | 20枚 | 22枚，按卖家同型号包装向上取整 |
| 二极管 | Vishay 1N4148-TAP，DO-35轴向，C917479 | 20只 | 30只 |
| 上拉电阻 | UNI-ROYAL 0805W8F1002T5E，10kΩ±1%、1/8W，C17414 | 4只 | 20只 |
| 矩阵裸板 | CalcKey MATRIX A，当前发布原制造文件 | 1片 | 5片，其中1片装机 |
| 矩阵/LCD软线 | 26AWG，绝缘外径≤1.3mm | 15根×150mm | 两组共3m |
| USB线 | USB-A至Micro-B数据线，1m，设备端线头≤12×8mm | 1条 | 1条 |
| 独立供电 | USB-A输出5V/1A稳压充电器 | 1个 | 1个，可复用已有件 |

发布电路中的54个实例已核对：20轴、20二极管、4电阻、10个直接焊线铜垫。J1～J10是板上的焊盘，不是需要购买的10个插座；矩阵没有GND端子，J10接3V3。当前不采购排针、热插拔座、SMT服务、钢网或背光驱动支路。

Vishay缓存厂家数据表第1页确认1N4148-TAP为DO-35轴向封装，黑环是阴极；PCB采用7.62mm卧装弯脚间距。UNI-ROYAL缓存厂家数据表第2页的编码规则与0805/W8/F/1002相符，分别对应封装、1/8W、±1%和10kΩ。两者的采购代码也与当前发布电路绑定一致。

本次精确供应商查询均遇到验证拦截（supplier_search_failed），所以只沿用已核对型号及缓存厂家资料，**不宣称实时库存、起售量或价格已确认**；不因查询失败换型号。

## 容易漏买的结构与辅料

| 项目 | 每台装机/加工量 | 采购核对点 |
| --- | --- | --- |
| 合盖螺钉 | ISO 7380-1 M3×8，4颗 | 建议备6颗；保持圆头及长度 |
| Pico螺钉 | ISO 4762 M2×4，2颗 | 建议备4颗；LCD不再使用旧OLED螺钉 |
| 前端脚垫 | D12×2mm自粘硅胶垫，2个 | 建议备4个，厚度参与两档倾角 |
| 透明保护片 | 67.6×19.6×1mm亚克力，四角R1，1件 | 单独切割，不计入28个打印件 |
| 保护片胶框 | 厚0.15mm，外67.6×19.6、内64×16mm，1件 | 不遮窗，不替换为厚泡棉 |
| LCD承托胶片 | 2×4×0.15mm，4片 | 建议裁8片；仅贴PCB允许的边缘承托带 |
| 热缩管 | 内径2/3mm混合，共1m | 保护裸露接头，避免在板背堆高 |
| 聚酰亚胺胶带 | 宽10mm、总厚≤0.1mm，1卷 | 五个固定桥默认裁5条10×65mm，搭接≥15mm |
| 环氧胶 | 适合实际PETG的双组份胶，少量 | 只胶轴端帽；1mm胶合插入保持力尚未实测 |

工具可沿用已有温控烙铁、适合0805的细头/小凿头、0.5mm电子焊锡丝、配套助焊剂、镊子、斜口钳、26AWG剥线工具、万用表、PCB夹具和返修吸锡带；工具不计入成品BOM。

## PCB打样参数核对

对应发布：`17123bc08553010640eaa377912e790923ec95a26949b1e102fa73c7f9b2c727`，制造ZIP SHA-256：`e6ae9edbe31d184a3f1e57cffe2535466c04d0af143dc57ccf06d5e4a0b65dc8`。13个制造文件及1个审计记录已校验，Gerber和钻孔逐文件与发布一致，CRC通过；没有重新布线或新建发布。

| 参数 | 本机选用值 |
| --- | --- |
| 设计/材料 | 1种设计，普通FR-4刚性裸板 |
| 层数/板厚 | 2层，成品标称1.6mm |
| 轮廓 | 73×96mm，R1，按原始轮廓，不缩放 |
| 铜厚 | 双面1oz；发布任务中两铜层均为0.035mm |
| 数量/交付 | 建议5片，单片出货，不拼板、不加工艺边 |
| 阻焊/字符 | 双面绿油/白字 |
| 表面处理 | 无铅HASL；需在供应商工艺选项中明确指定 |
| 额外服务 | 常规开短路测试；不选SMT和钢网，不加特殊塞孔/阻抗工艺 |

已从原钻孔文件核对：NPTH Ø4.0mm共20孔；PTH Ø1.5mm共40孔、Ø0.8mm共40孔；过孔Ø0.3mm共8孔。普通打样参数在厂家公开工艺范围内，仍以实际订单审核为准；供应商公开1.6mm板厚允许±10%，不把标称值当作实物零公差。[厂家能力表](https://jlcpcb.com/capabilities/pcb-capabilities/)

**尺寸摘要注意：** Gerber轮廓中心线包围尺寸确为73×96mm，轮廓笔画宽0.1mm，因此任务摘要记录73.1×96.1mm的笔画包络。不要为“纠正”这0.1mm而缩放Gerber或钻孔。若供应商预览出现这个差值，先核对轮廓中心线识别。任务文件表面处理写作None，并没有替你选择HASL，所以上表工艺选项仍需在日后下单时明确指定。

## 打印材料核对

| 用途 | 件数 | 材料 | 已交付默认喷嘴/层高 |
| --- | ---: | --- | --- |
| 主壳、底盖 | 2 | 普通PLA | 0.4/0.15mm |
| 两脚、两销轴、两端帽 | 6 | 普通PETG | 0.4/0.15mm |
| 正式键帽 | 20 | 普通PETG | 0.2/0.10mm |

共2件PLA、26件PETG，28个STL字节与当前清单全部一致。沿用普通未填充耗材，不自动改为碳纤、发泡或高颗粒材料；键帽约0.40mm薄插座壁及凹字依赖细喷嘴路线。主壳桥底与底盖大面仍需按现有说明设置局部支撑，不因材料核对通过就视为免支撑或已切片。PETG与平台的匹配及隔离层遵循实际机器和耗材要求。[PETG材料依据](https://help.prusa3d.com/article/petg_2059) · [PLA材料依据](https://help.prusa3d.com/article/pla_2062)

没有指定打印机、耗材品牌或线径，不能核对具体线径和温度配置；本次没有运行切片，故不提供耗材克重、打印时长或必须购买多少卷的估算。已有足量且符合设备线径的PLA/PETG可直接纳入后续打印准备。

## 核对边界

本报告确认现有数字设计与备料/打样参数的一致性；商品实发版本、库存、胶接保持力、打印配合和实物功能仍待实际采购与制作核对。原BOM、采购表、CAD、PCB、固件及完整制作ZIP保持不变；本报告中的线材外径等条件用于补足询价核对，不新增硬件、不换型、不下单。
