Cailynoo7/CalcKey/product/cad-compatibility/README.md

# CAD螺钉接口兼容修复

本次只修复现有源码的运行库兼容性，并核对重建几何。修复前基线为`before-seat-fix.step`及其原始导出记录；原制作包、28件STL和已填写/待测装配记录在修复期间保留。

底部四颗M3圆头螺钉、内部两颗M2圆柱头螺钉沿用原先表面安装方式；当前运行库要求显式指定`seat`，因此两个调用均补入`seat="surface"`，不引入沉孔或沉头。

验证结果见同目录verification.json、step-geometry-comparison.json和domain-compare.json。本次不打印、不上电、不烧录，未进行实物验证。

## 已完成的核对

- 新revision：`2eb56aacf9c6b0addd5214ae11923067f8b2d31bba71151d294eb014e255a7a9`；新STEP导出：`export-e9d67ce8536f1f9b0574ccf294968294`，预览已更新。
- 源码与基线逐字比较：仅新增两处seat="surface"及说明注释；原参数、放置、进口资产和其他单元源码保持。
- 32个发布对象的有效性、实体数、面数、边数、体积、表面积及包围盒全部一致。
- 主壳、底盖、20帽、两销轴、保护片及Pico共26个对象的STEP几何实体块经编号命名空间、空白和装配实例标识规范化后一致（忽略颜色呈现引用）。
- 两翻脚、两短端帽和六颗螺钉采用修复前后已发布STEP做双向实体差集，残差均为0mm³，允许数值容差1e-6mm³。差集不重放源码、不改变CAD。
- 矩阵PCB保留同一不可变资产和安装位姿；域内对比的几何变化及包围盒变化均为false。整机没有新增未声明干涉，原卡扣干涉仍为0.1374mm、预算0.16mm。

比较工具对部分对象报告了几何/拓扑标识变化；这些对象另经STEP差集核对，不以“标识变化”或“尺寸相同”代替实体一致性结论。修复前导出、参数与数值事实已保留，后续可用verify_geometry.py在带build123d的CAD Python中复核；它只读取导出文件，不运行设计单元，也不接触设备。

## 修复当时的交付边界

新源码和新STEP已交付；现有28个STL仍保留原始转换来源，逐文件哈希未变，并经本次几何对照证明兼容。原完整制作ZIP没有重新打包，里面的CAD源码仍是修复前版本；旧采购、固件及实物待测表保持原样。需要整包内也含修复后源码时，再同步封装与来源清单。

## 后续制作包同步

本次完整制作ZIP已纳入修复后源码和STEP，以及28件打印准备说明/逐件表。上一节和原verification.json保留修复当时的记录，当前封装状态以product/production/seat-repair-delivery-addendum.json和package-manifest.json为准；原始几何证据与28件STL不变。
