Cailynoo7/CalcKey/design/firmware/release/README.md

# 固件发布

当前Type-C主控：v0.3.0，Waveshare RP2350-Plus-16MB无排针版，目标waveshare_rp2350_plus_16mb，16MB Flash、GDM0103 LCD。

v0.2.0为Pico 2与GDM0103的历史版本；根目录v0.1.0文件为更早的OLED版本，均不作为本次Type-C板已验证固件。所有发布均无实机烧录记录。
