Cailynoo7/CalcKey/product/purchasing/matrix/README.md

# CalcKey矩阵板：打样参数与手工焊装采购

本清单按一台整机编制，先准备资料，不下单、不上传供应商订单、不支付、不烧录。主控为Waveshare RP2350-Plus-16MB无排针SKU 29761，GDM0103沿用原选型；已有合适器件可以直接复用。装机数量来自当前部件清单，采购备品数量为本次默认建议，不把5块裸板当作5台整机。

## 对应发布与文件

- PCB：matrix，发布17123bc08553010640eaa377912e790923ec95a26949b1e102fa73c7f9b2c727，Build 6a333818c3a79007ec3a24727eed3008848215ed1c5c0238051beffaecfde0e3。
- 已单独导出裸板制造ZIP：13个制造文件（Gerber、PTH/NPTH钻孔及钻孔报告）和1个发布审计记录。ZIP SHA256为e6ae9edbe31d184a3f1e57cffe2535466c04d0af143dc57ccf06d5e4a0b65dc8。
- 取制板文件：matrix设计标签 → Fabrication files → PCB manufacturing package。资料表：右键Product标签 → Show in Finder。
- 完整设计ZIP采用Type-C主控、30件打印模型与v0.3.0固件，按配套清单核对版本和哈希；单独制板仍使用上述裸板制造ZIP。旧手焊行列图与九页指南只作历史资料，不混入正式包。JLC贴片BOM/CPL仅有表头，本板采用手工焊装，不提交贴片订单。

## 打样参数

| 项目 | 填写值 | 依据 |
| --- | --- | --- |
| 种类 | 普通刚性裸PCB，1种设计 | 当前发布 |
| 材料 | FR-4 | 当前发布 |
| 层数 | 2层 | 当前发布；不更改 |
| 成品板厚 | 1.6mm | 当前发布及整机装配；不以薄板替代 |
| 外形 | 73×96mm、圆角R1，按原Gerber | 当前发布；不缩放、不改孔 |
| 外层铜厚 | 1oz | 当前发布；两面均保持1oz |
| 数量 | 建议5片，仅组装其中1片 | 采购默认；其余作为裸板备品 |
| 交付形式 | 单片板，不拼板、不加工艺边 | 采购默认 |
| 阻焊 / 字符 | 双面绿油 / 双面白字 | 采购默认 |
| 表面处理 | 无铅喷锡 / Lead-free HASL | 采购默认 |
| 过孔 | 普通过孔，按制造文件阻焊开窗；不加树脂塞孔、盘中孔等工艺 | 当前板不需要特殊过孔工艺 |
| 阻抗 / 金手指 / 盲埋孔 | 不需要 | 被动低速矩阵，无这些设计 |
| 测试 | 保留工厂常规开短路测试 | 采购默认；不等于整机功能验收 |
| SMT / 钢网 | 不选贴片，不采购钢网 | 4只0805电阻由操作者手焊 |
| 编号与额外标记 | 保留原丝印；厂商额外编号避开焊盘、孔及器件标记 | 采购备注 |

绿油、1.6mm、1oz和无铅HASL均在厂家公开能力范围内；这里没有生成报价或选择付费服务。厂家能力依据：[JLCPCB公开能力表](https://jlcpcb.com/capabilities/pcb-capabilities/)，查询日期2026-11-06。该来源说明可用工艺，不是本项目订单或价格证明。

制造文件已定义孔和铜，不要根据下列核对值自行重画：

| 项目 | 数量 / 尺寸 |
| --- | --- |
| 中心塑料柱NPTH | 20个，直径4.0mm |
| 轴触点PTH | 40个，直径1.5mm |
| 二极管PTH | 40个，直径0.8mm |
| 过孔 | 8个，孔径0.3mm、外径0.6mm |
| 铜到板边设计规则 | 0.3mm |
| 布线规则 | 行列0.25mm、键内信号0.3mm、3V3为0.4mm；首选铜间距0.25mm，绝对下限0.15mm |

可以交给工厂的备注：

> CalcKey MATRIX A，普通双层FR-4裸板，成品73×96mm，板厚1.6mm，两面1oz铜，双面绿油白字，无铅喷锡，单片出货，建议5片。外形、铜与PTH/NPTH钻孔按随附当前Gerber和钻孔文件制作，不缩放，不合并NPTH/PTH，不加工艺边；常规开短路测试。不需要SMT、钢网、金手指、阻抗控制或树脂塞孔。额外编号避开器件标记、孔和焊盘。

## 矩阵板焊装器件

| 器件 | 完整型号 / 规格 | 每台装机 | 建议备料 | 核对点 |
| --- | --- | ---: | ---: | --- |
| 裸PCB | CalcKey MATRIX A，上述当前发布 | 1片 | 5片 | 仅1片装机，其余留存 |
| SW1～SW20 | GATERON KS-9红轴、三脚，KS-9H10B045NN-X14 | 20枚 | 22枚 | 原厂CAD标识为KS-9H10B045NN-X14-FB，用户已确认对应一致；保持同一型号，不改五脚、光轴或热插拔座 |
| D1～D20 | Vishay 1N4148-TAP，DO-35轴向，[LCSC C917479](https://item.szlcsc.com/992944.html) | 20只 | 30只 | 保留-TAP完整型号和轴向玻璃封装，背面卧装，黑环为K；不是贴片1N4148W/WS |
| R1～R4 | UNI-ROYAL 0805W8F1002T5E，10kΩ±1%、125mW，[LCSC C17414](https://item.szlcsc.com/18102.html) | 4只 | 20只 | 0805贴片；不购买旧方案的轴向电阻，也不改0603封装 |
| 矩阵与LCD引线 | 26AWG柔性绝缘多股线 | 矩阵10根、LCD5根 | 合计3m | 默认每根150mm，共2.25m，余0.75m作裁线损耗；两组从同一3m线材裁取，不重复买两卷 |

器件链接和代码沿用本项目已核对的精确选型；不在此承诺实时库存、起售包装或成交价格。若商家只能整包购买，按相同型号向上取整，不减少装机数量。推荐备品用于装配损耗更换，不改变每台BOM数量。

## 保留的模块与整机辅件

- Waveshare RP2350-Plus-16MB无排针版（SKU 29761）×1，GDM0103/HT1621B八位LCD×1；已有可复用。LCD保持3.3V、6点钟视角，最大78×26×10mm，P1～P5直焊，P6～P9各自绝缘。
- USB-A至USB-C数据线×1，长度1m、支持数据传输；不能用只有充电功能的数据线替代。独立使用时另备现有规格5V/1A USB-A充电器×1。
- ISO7380-1 M3×8圆头螺钉装4颗，建议备6颗；ISO4762 M2×6圆柱头螺钉装4颗，建议备6颗。用于两只主控绝缘压桥，不为矩阵板另买螺柱、排针或螺钉。
- 前端D12×2mm自粘硅胶垫装2个，建议备4个。
- 透明亚克力片67.6×19.6×1mm、四角R1×1；配0.15mm厚胶框，外67.6×19.6、内64×16mm×1。保护片切割，不打印。
- LCD绝缘丙烯酸胶片2×4×0.15mm装4片，建议裁8片备用；板背器件与铜箔按已有装配说明避让。
- 内径2mm/3mm热缩管混合、合计1m；10mm宽、总厚≤0.1mm聚酰亚胺胶带1卷；双组份环氧胶1小套，仅用于两只PETG轴端帽。
- 打印件沿用：主壳1、底盖1、左右翻脚2、销轴2、端帽2、键帽20，另加两只PLA主控压桥，共30件。主壳与底盖因Type-C接口立台更新；键帽与原翻脚件几何保持，不要求打印试片。

## 手焊工具与耗材

已有工具可以复用；工具不计入成品BOM。

| 项目 | 采购默认规格 | 建议数量 |
| --- | --- | --- |
| 温控电烙铁 | 小型凿形/刀形烙铁头，适合0805与通孔焊点 | 1套 |
| 电子焊锡丝 | SAC305无铅松香芯、直径0.5mm | 1卷，50g |
| 电子助焊剂 | 适合手焊、与焊料配套的免清洗电子助焊剂 | 1小支 |
| 细尖镊子 | 夹持0805电阻 | 1把 |
| 斜口钳 | 剪二极管引脚 | 1把 |
| 剥线工具 | 支持26AWG | 1把 |
| 万用表 | 电阻、通断及二极管档 | 1台 |
| PCB夹具 | 固定裸板进行手焊 | 1套 |
| 吸锡带 | 约2mm宽，用于返修 | 1小卷 |
| 清洁用品 | 按所用助焊剂说明准备合适清洁剂与无绒擦拭材料 | 1套 |

## 焊装与断电检查入口

按矩阵设计的assembly说明操作：先焊背面R/D，再将20轴扣入面板并对齐PCB、焊40个轴触点，然后接J1～J10和LCD引线。J1～J5→GP2～GP6，J6～J9→GP7～GP10，J10→3V3；矩阵板无GND端子，J10不接5V。先完成逐键二极管档、上拉电阻和线束通断检查，再合盖；本清单不执行上电或烧录。

同目录附打样参数JSON/CSV、采购CSV及工具耗材CSV，所有数量均有装机/采购区分。整机BOM、当前PCB源文件与发布制造文件不因本次采购准备而改变。

## 线束固定桥补充

新增结构与主壳/底盖一体打印，不新增采购行。沿用10mm聚酰亚胺胶带，裁5条10×65mm、搭接至少15mm；每根矩阵线150mm总长中保留至少65mm跨壳自由段，LCD线只固定到底盖。主壳/底盖STL已按固定桥STEP更新，其余26件经核对复用；完整包纳入新版整机手册与154项空白记录，电子件、PCB发布与采购数量不变。详见线束固定与维护说明。

## Type-C版采购与制作

主控为RP2350-Plus-16MB，无排针，SKU 29761；16MB与4MB不同，不按旧29370采购。电池座不接，不另买转接板或电池。新增两只PLA绝缘压桥及8片6×1.4×0.15mm绝缘胶片；4颗M2×6替代原2颗M2×4。压桥沉孔头低于顶面0.2mm，勿擅换更长螺钉。PCB打样参数和电子元件不变。主壳、底盖及新增压桥当前按CAD交付；当前STL与完整ZIP已同步，按模型及整包清单取用。
