Cailynoo7/CalcKey/product/ks9-sample-purchase-guide.md

> 用户已选择跳过打印试配；本文保留为可选历史资料。正式制作以production说明与正式整机模型为准。

# 佳达隆 KS-9 三脚红轴：小样采购与到货核对

日期：2026-11-05。用途：CalcKey 的20键手焊矩阵、14.2mm试配孔、打印MX十字键帽。本文是询价与小样验收说明，未向商家发消息、下单、付款或进行实物测试。

## 买什么、先买多少

- 采购识别型号：**GATERON / 佳达隆 KS-9 Red，KS-9H10B045NN-X14**，普通机械触点、全高MX十字轴芯、三脚版。三脚指两个金属电触点和一个中心塑料定位柱，不是三个电触点。
- 当前官方CAD文件身份：**KS-9H10B045NN-X14-FB**。整机依据该模型设计。用户已核对并确认所选轴体与该模型一致，型号对应项已闭合；此确认不等于厂家解释了FB的字面含义。
- 默认建议先买 **3颗、同批次、同完整料号**，编号S01/S02/S03。S01保留原样作基准，S02比较六孔及三种键帽，S03复核一致性并作备用；高温焊接或损伤后的件不再作原样基准。小样数量是本说明的建议，不把正式BOM中的20颗改成3颗，也不默认额外订购23颗。通过后凑足20颗合格可装机轴。
- 不接受未经核对的G Pro/Pro 2.0/Pro 3.0、Y35/Y51/D20后缀、静音版、五脚版、矮轴、磁轴或光轴代替。不能靠剪掉五脚版的塑料脚认定为同料号。只需要轴体，不需要键帽、轴座或LED。

## 可直接复制给卖家

> 你好，我需要佳达隆GATERON KS-9普通三脚线性红轴，采购识别料号KS-9H10B045NN-X14，先买3颗同批次小样，用于手焊数字键盘。请确认不是G Pro、静音、五脚、磁轴、光轴或矮轴，不自行换货。
>
> 我的外壳依据佳达隆官方3D页面提供的“KS-9 Switch KS-9H10B045NN-X14-FB.stp”设计。请确认实发完整料号，并说明FB是否属于该物料后缀、图档版本或其他标记；如认为与不带FB的型号相同，请提供厂家规格/机械图/书面型号对应依据。若不清楚，请直接注明不清楚。
>
> 请提供对应批次的原包装标签，以及同一颗轴的顶部、底部、侧面实拍，能看清十字轴芯、卡扣、两个金属脚和中心塑料柱；并提供该完整料号的机械尺寸图及版本。如果无图，请注明无法提供，并尽可能量一下法兰支承底面到自由轴芯顶端的高度、最大外廓和总高度。
>
> 请同时说明上壳/底壳材质与颜色、是否原厂润滑或后加润滑、是否拆机/翻新/混批，以及3颗小样的最小起订数量、单价、运费和不符型号时的处理方式。请在订单备注中写明实发完整料号和三脚红轴。

向卖家附上官方入口：https://www.gateron.com/pages/3d ，选择KS-9条目。不要附G PRO 3.0条目替代。

## FB与型号对应结论

用户确认：“我核对过了，一样的”。本项目据此记录KS-9H10B045NN-X14与所用KS-9H10B045NN-X14-FB模型对应一致，不再要求重复确认。FB本身含义仍不作推断。复购保持相同型号；更换型号、供应商所售版本或机械结构后再复核。前面的卖家模板可用于后续采购留档，不代表当前对应关系仍未解决。

## 到货要量哪些尺寸

统一基准A：轴体法兰真正压在面板上的**支承底面**，不是法兰上表面。自由位置指没有按键帽、没有手压轴芯；X/Y方向拍照标记，同一侧的卡扣、引脚朝向保持一致。配套记录表按S01–S03分别填写。

以下数字是当前官方STEP的测量参考，**不是厂家公差，也不是收货上下限**。厂家尺寸图的公差优先；没有公差时记录差值与量具误差，交回复核，不自行给出“±0.1mm合格”。卡尺显示0.01mm不代表准确度为0.01mm。

| 项目 | 当前模型参考 / mm | 量法和用途 |
| --- | --- | --- |
| A面→自由轴芯顶 | 10.200 | 最重要座高；用不压轴芯的方法量差高，勿误取法兰上面 |
| 最大外廓X / Y | 16.221 / 15.720 | 包括凸筋、卡扣和法兰的最大包络，不是14.2安装孔或单纯下壳宽；先标方向，避免卡尺压缩弹性卡扣 |
| 最低点→自由轴芯顶 | 18.600 | 含完整引脚的总高；弯脚会使测值失真，应同时拍照 |
| A面→最低点 | 8.400 | 含引脚，用于底部接线避让；不是下壳本体高度 |
| 十字总跨X / Y | 约4.000 / 4.000 | 模型在A面上方8mm截面的参考；不要只量顶端倒角，臂端和圆角外形也需近照 |
| 活动轴芯根部外廓X / Y | 5.000 / 6.550 | 能接近时轻量并拍照；模型参考，勿把它当十字孔尺寸 |
| A面→活动轴芯根部顶 | 6.600 | 影响键帽插座避让；难测时填写“未测”，不拆轴猜值 |
| 金属脚位置、中心柱、卡扣钩和允许板厚 | 待对应料号的厂家机械图/实测 | 表中不填未经测量的标准MX数值；底视与两向侧视需拍清 |

按压力、触发行程和总行程属于另外的功能参数：现有选型为线性45±15gf、预行程2.0±0.6mm、总行程4.0mm Max。总行程“Max”不是“4.0±某公差”；没有测力计时不能凭手感确认45gf合格。到货先观察是否线性顺畅、能完整回弹，再按厂家图与试配记录复核。

## 先试配，再决定是否补足20颗

1. 保留商品截图、订单备注、包装标签和卖家答复，给三颗贴S01/S02/S03编号。检查是否同版、有无弯脚、裂纹、拆卸痕迹和卡扣损伤。
2. 先记录未安装、未加热状态的尺寸。不夹压轴芯或卡扣来“量出”目标数值；难测项留空并说明。
3. 在六孔试片中先试当前主壳基准C（14.2mm孔、1.50mm台阶、16.4mm背面避空）。明显过紧即停，换较大孔作比较；不要为迁就模型硬压或打磨轴体。再按试片指南比较孔宽和1.35/1.65mm台阶，记录支承面是否坐平、卡扣是否回弹、晃动与拔取保持情况。
4. 在适合的孔内试**新版**P0/P5/P10键帽：十字孔长/臂宽4.10/1.40、4.15/1.45、4.20/1.50mm，深3.3mm。托住轴体沿轴线轻推，量松开/压到底的帽底间距，检查回弹、上盖摩擦和拔取裂纹。模型名义参考为5.5/1.5mm；不能据此强压到该高度。局部最薄壁0.20–0.25mm，漏线或开裂即停。
5. 可在未连接Pico、未供电时，以万用表检查两个金属电触点：松开开路、按下导通、释放恢复。勿把中心塑料柱当电触点；不需要烧录来做此检查。
6. 保存S01原样；S02/S03结果应分别记录。若样品间几何、卡扣或手感明显不一致，或任一关键项未闭合，不把一颗能插入当成整批通过。尺寸差异先复核量法、图纸版本与CAD，再决定补购或改设计。

进入正式装机的条件：完整料号/版本有足够可追溯依据，实际孔扣配合、键帽松紧、全行程回弹和断电触点检查可用，且采购批次与通过小样对应。仅靠型号文字、照片相似或CAD没有穿插均不够。

## 资料依据与状态

- 官方系列页：https://www.gateron.com/products/gateron-ks-9-switch-set （三脚、Red选项、材质和润滑描述）。
- 官方3D入口：https://www.gateron.com/pages/3d ，下载链接：https://gateron.com/u_file/2306/26/file/KS-9SwitchKS-9H10B045NN-X14-FB.rar 。STEP SHA-256：29f4d60beb57a869d233939c629de23319458d225f0be6644fd86258533e3c9d。
- 根料号的零售识别记录：https://mechanicalkeyboards.com/products/gateron-milky-red-45g-linear ，用于识别采购SKU，不用于解释FB或提供精密机械公差。
- 模型尺寸取自当前20轴整机的官方资产只读测量。最大包络/轴芯截面已于本次复核；模型把壳体、轴芯和引脚融合，内部运动不能独立验证。
- 配套《KS-9小样尺寸记录》为待测空表；沿用《六孔轴体试配记录》《三种键帽试配记录》《孔×键帽联合试配记录》。型号对应已获用户确认；本次未提供逐项实测数值，因此空白尺寸和试配表保持待测，不代填数值或打印强度结果。
