Cailynoo7/CalcKey/product/bom.csv

id | role | name | quantity | manufacturer | mpn | source | platform_ref | datasheet_url | description | selection_reason | cad_relevance | part_identity | source_url | product_url | procurement_status | supply_risk | footprint | designators | assembly | required_user_evidence | part_number | lcsc_code | supplier | stock | image_url | package | platform_index_status
controller | controller | Waveshare RP2350-Plus-16MB，无排针版 | 1 | Waveshare | RP2350-Plus-16MB | manufacturer |  | https://files.waveshare.com/wiki/RP2350-Plus/RP2350_Plus.pdf | RP2350A、16MB外部Flash、原生USB Type-C、无排针；SKU 29761；电池座悬空不使用。 | 用户指定Type-C主控替换Pico 2；现有GP0至GP11及3V3/GND映射沿用，原厂提供共享系列STEP，SDK有16MB板级配置。 | {"notes": "原厂系列STEP共用外形，板中心(17.3,-10)，模型PCB顶z6；四处边缘座及两只PLA压桥，以4颗M2×6固定；无排针，Type-C母座前缘距壳外面0.3881mm。原厂STEP的PCB厚0.41148mm，未将其当作实物板厚公差，须装配核对。"} |  | https://www.waveshare.net/shop/RP2350-Plus-16MB.htm |  | external_procurement_required |  |  |  |  |  |  |  |  |  |  |  | not_indexed_user_selected
display | display | Good Display / 大连佳显 GDM0103 8位段码LCD模组，HT1621B，3.3V，6点钟视角 | 1 | Dalian Good Display | GDM0103 | manufacturer |  | https://www.radiomag.com.de/datasheets/gdm0103_specification.pdf | 78×26×10mm最大；可视60.5×13.5mm，图形57.15×10.70mm；半透正显，初版不接背光，3线写入。 | 现成8位LCD，可视宽接近原32mm窗口的两倍，26mm纵深容纳于既有机身；相比84×44mm的NHD-0108FZ更紧凑，避免裸玻璃外加驱动板。 | {"notes": "中心(0,49)，PCB底z7.4；边缘托架+0.15mm绝缘胶片，单独64×16窗口、67.6×19.6×1保护片。"} | 51c8911e50b983e2 | https://www.qiyun-display.cn/Products_1/55.html | https://www.logifind.com/products/gdm0103-ht1621-driver-8-bit-wide-temperature-lcd-module-segment-code-lcd-module-lcm-lcd-display-module | external_procurement_required | 市售页面可下单，但库存及3.3V变体需按订单确认；官方附件403，采用厂商署名镜像PDF第3/7/8页。无精确STEP，不以假模型替代；装配与视角需实物试配。
switches | keys | GATERON KS-9 Red 三脚红轴 KS-9H10B045NN-X14 | 20 | GATERON | KS-9H10B045NN-X14 | manufacturer |  |  | 2个电触点+中心塑料柱；线性45±15gf、预行程2.0±0.6mm、总行程最大4mm；不接LED。 | 保留用户已确认的KS-9型号；三脚Plate封装旋转90度，对原厂STEP触点和中心柱核对后焊装。 | {"notes": "官方STEP支承底面z16.2、轴顶z26.4；20轴实例，14.2孔/1.5台阶仍需实配。"} | 9c532cdfd4c9e272 | https://www.gateron.com/products/gateron-ks-9-switch-set | https://www.gateron.com/products/gateron-ks-9-switch-set | external_procurement_required | 用户已确认本轴体与所用官方CAD对应一致；按用户要求跳过打印试配。卡扣弹性、保持力和实际插拔配合未实测。 | kicad:Button_Switch_Keyboard/SW_Cherry_MX_1.00u_Plate | ["SW1", "SW2", "SW3", "SW4", "SW5", "SW6", "SW7", "SW8", "SW9", "SW10", "SW11", "SW12", "SW13", "SW14", "SW15", "SW16", "SW17", "SW18", "SW19", "SW20"] | {"population": "mounted", "method": "through_hole", "side": "top"} | []
keycaps | printed_part | CalcKey 自制1U等高键帽，PETG，含MX十字盲孔和刻字 | 20 | CalcKey |  | project |  |  | 20只18.2×18.2×7mm PETG键帽，统一Arial Bold凹刻；数字/运算符4.8mm、文字3.3mm，深0.35mm；5键直径2mm、深0.35mm浅圆凹定位点；Enter与=上下双标识。MX十字孔4.10/1.40、深3.3及插座保持。 | 用户要求5键定位触点、Enter/=双标识及统一文字排版；定位点采用浅凹以保持顶面朝下的既有精细打印方式。字高为字体参数，实际轮廓另核对；没有新购器件。 | {"notes": "沿官方轴芯偏心+0.05/-0.000674mm对齐；松开帽底距面板5.5mm、全压名义余1.5mm。"} | 2bd031b7327897be |  |  |  | 细喷嘴FDM默认0.2mm/0.1mm；跳过试配为用户选择。几何最薄壁0.40mm不是强度保证，打印收缩和实际轴芯插拔力未实测。 |  |  |  |  | enclosure:key_01..key_20
matrix_diodes | matrix_diodes | Vishay 1N4148-TAP | 20 | VISHAY(威世) | 1N4148-TAP | manufacturer |  | https://atta.szlcsc.com//upload/public/pdf/source/20201110/C917479_CDCB5552612410FD982D48AB0AE9F706.pdf | DO-35轴向1N4148-TAP，每键1个，PCB底面卧装、7.62mm弯脚间距；黑环K接方形pad1/行，A接pad2。 | 保留1N4148-TAP，黑环K接行，7.62mm弯脚间距，矩阵板背面卧装。 |  | 5efc7bf72afaab5c | https://item.szlcsc.com/992944.html | https://item.szlcsc.com/992944.html | resolved | 目录未返回精确轴向型号；保留厂商确切型号，不用1N4148W/WS贴片封装替代 | kicad:Diode_THT/D_DO-35_SOD27_P7.62mm_Horizontal | ["D1", "D2", "D3", "D4", "D5", "D6", "D7", "D8", "D9", "D10", "D11", "D12", "D13", "D14", "D15", "D16", "D17", "D18", "D19", "D20"] | {"population": "mounted", "method": "through_hole", "side": "bottom"} |  | C917479 | C917479 | LCSC | 17869 | https://alimg.szlcsc.com/upload/public/product/source/20260721/85700D8CF2B10FA977E4864FD5ED244A.jpg | DO-35
column_pullups | pullups | UNI-ROYAL 0805W8F1002T5E 10kΩ ±1% 1/8W 0805电阻 | 4 | UNI-ROYAL(厚声) | 0805W8F1002T5E | default |  | https://atta.szlcsc.com//upload/public/pdf/source/20200306/C422600_1E6D84923E4A46A82E41ADD87F860B5C.pdf | 4只列上拉，0805贴片、手工焊接；阻值和功率保持，替代原轴向通用电阻。 | 保留10k±1%和125mW；0805便于板背紧凑排布与手焊。 |  | 2e435d23336b7278 | https://item.szlcsc.com/18102.html | https://item.szlcsc.com/18102.html | resolved |  | kicad:Resistor_SMD/R_0805_2012Metric | ["R1", "R2", "R3", "R4"] | {"population": "mounted", "method": "manual", "side": "bottom"} |  | C17414 | C17414 | LCSC | 50508412 | https://alimg.szlcsc.com/upload/public/product/source/20221228/9FAC57B04CBA608011C05FA2B3C494C9.jpg | 0805
usb_cable | cable | USB-A至USB-C USB 2.0数据线，1m | 1 |  |  | default |  |  | USB-A至USB-C、1m、支持USB数据与5V供电；默认设备侧胶壳不超过12.35×6.5mm，USB-C金属头应能在插座前缘内缩0.3881mm时完全就位；实物插头仍待测。 | 用户要求机身Type-C口；保留已有USB-A 5V适配器，改配Type-C设备端数据线。 | {"notes": "外壳胶囊孔10.0×4.3mm；无大方孔，主控与孔位已按原厂STEP对齐；首段线缆留25mm。"} |  |  |  | external_procurement_required
signal_wire | wire | 矩阵引线：26AWG柔性绝缘线，每根150mm | 10 |  | 26AWG-150mm-direct-solder-lead | default |  |  | 10根：5行、4列及3V3，J1-J10底面直焊；每根总长150mm，其中跨上下壳固定点间保留≥65mm自由段；不安装直立排针。 | 矩阵PCB替代逐键飞线，仅保留主控维护线束；焊点绝缘并固定线皮。 |  | fa8a8bb32efce22c |  |  | external_procurement_required |  | kicad:Connector_Wire/SolderWirePad_1x01_SMD_2x4mm | ["J1", "J2", "J3", "J4", "J5", "J6", "J7", "J8", "J9", "J10"] | {"population": "mounted", "method": "manual", "side": "bottom"} | []
heatshrink | insulation | 内径2mm、3mm热缩管混合包，合计1m | 1 |  |  | default |  |  | 绝缘电源接头和需要保护的裸露引线；PCB焊盘不因套管而堆高，余线另用聚酰亚胺胶带固定线皮。 | 裸露接线需要绝缘和应力释放 |  | df3f619804a92fdb |  |  | external_procurement_required
enclosure_base | printed_part | CalcKey 独立底部盖板，PLA，FDM打印 | 1 | CalcKey |  | project |  |  | 89×130×2.4mm底盖，集成两组3mm厚轴耳与收起/展开限位；销轴孔直径2.8mm，保留器件安装柱与定位唇，外侧新增结构打印需支撑。 两轴耳组中心x=±29.5mm，与后脚同轴。 LCD区域为四处边缘托架与左右/前侧限位，PCB底面z7.4mm。 | 底部维护，Pico、LCD和翻脚随底盖取下；LCD改为边缘托架，不沿用OLED螺钉柱。 |  | dd3011b295d5d632 |  |  |  |  |  |  |  |  | enclosure:base
enclosure_top | printed_part | CalcKey 顶侧一体主壳，PLA，FDM打印 | 1 | CalcKey |  | project |  |  | 89×130mm顶侧一体主壳，局部塑料主体总高21mm，20键4×5、USB右侧；上缘0.4mm倒角，前侧0.35mm浅刻CALC及四条短斜线。 | 用户要求紧凑、简单科技感、屏幕靠近按键和底部开盖，顶面不露合盖螺钉。 |  | 83022bb1821c7337 |  |  |  |  |  |  |  |  | enclosure:top
screen_lens | window | 透明亚克力保护片，67.6×19.6×1mm，四角R1 | 1 |  |  | default |  |  | 配68×20mm槽及64×16mm视窗，单独切割，不打印。 | 窗口宽度为原32mm的两倍，覆盖GDM0103可视区并保留边缘余量。 |  | fc6ea6fbd08e618b |  |  |  |  |  |  |  |  | acrylic-67.6x19.6x1-R1
case_screws | fastener | ISO 7380-1 M3-0.5x8mm 内六角圆头机螺钉 | 4 |  |  | default |  |  | 底部4颗，突出局部底面1.65mm；展开/收起姿态最低金属离桌面约1.788/1.217mm，PLA自成形孔。 | 底盖维护连接，顶面不露螺钉。 |  | c51231447a5e7a70 |  |  |  |  |  |  |  |  | ISO7380-1-M3x8
board_screws | fastener | ISO 4762 M2-0.4×6mm 内六角圆柱头螺钉 | 4 |  |  | default |  |  | 两只主控绝缘压桥各2颗，沉孔安装；kit实际选定M2×6，不穿过PCB。 | 压桥厚3mm、沉孔座、接合5mm，经printed-screw-joint-v1选长为6mm。 |  |  |  |  |  |  |  |  |  |  | ISO4762-M2x6
rubber_feet | feet | 前端自粘硅胶防滑垫，直径12mm，厚2mm | 2 |  |  | default |  |  | 两个前脚，局部中心(±38,-58)mm；与翻折后脚配合，收起约2.41°、展开约4°。 | 前端防滑并配合可翻折角柱脚，形成用户要求的两档后高前低。 |  | 5bf852947662d421 |  |  |  |  |  |  |  |  | silicone-pad-D12-T2
lens_adhesive | adhesive | 0.15mm压敏胶框，外67.6×19.6mm、内64×16mm | 1 |  |  | default |  |  | 透明保护片周边粘接，不遮挡64×16mm窗口。 | 保护片到槽顶留0.15mm胶层。 |  | f1f04474fbefebbd |  |  |  |  |  |  |  |  | PSA-67.6x19.6-0.15
usb_power_adapter | power_supply | USB-A输出5V/1A稳压USB充电器 | 1 |  |  | default |  |  | 保留USB-A输出5V/1A适配器，配USB-A至USB-C数据线；可复用已有合适的5V适配器。 | 用户选择接充电器的独立计算器模式，无主机枚举时运行本机计算 |  | 87323ac15274f7ae |  |  | external_procurement_required |  |  |  |  |  | USB-A-5V-1A
rear_foot_left | printed_part | CalcKey 左侧可翻折角柱后脚，PETG，FDM打印 | 1 | CalcKey |  | project |  |  | 宽10mm、主体长8.5mm、厚3.6mm、根部R2.6；转孔直径2.8mm，行程0～110°，收起约2.41°/展开约4°键面倾角，双档切平脚底。 局部转轴支点x=±29.5mm，中心间距59mm。 | 用户要求有厚度、可向后斜翻起的角柱后脚；承重压向实体限位。 |  | 0fb3d375d72dc2ed |  |  |  |  |  |  |  |  | enclosure:rear_foot_left
rear_foot_right | printed_part | CalcKey 右侧可翻折角柱后脚，PETG，FDM打印 | 1 | CalcKey |  | project |  |  | 宽10mm、主体长8.5mm、厚3.6mm、根部R2.6；转孔直径2.8mm，行程0～110°，收起约2.41°/展开约4°键面倾角，双档切平脚底。 局部转轴支点x=±29.5mm，中心间距59mm。 | 用户要求有厚度、可向后斜翻起的角柱后脚；承重压向实体限位。 |  | ba973368a00ac29e |  |  |  |  |  |  |  |  | enclosure:rear_foot_right
hinge_axle_left | printed_part | CalcKey 左后脚销轴，PETG，FDM打印 | 1 | CalcKey |  | project |  |  | 轴径2.4mm、杆长17.8mm，一体5×1.5mm挡头；配2.8mm通孔，轴线竖直打印、100%填充，实物校验圆度与承载。 端部入帽1mm，与帽底留0.2mm。 | 贯穿底盖两轴耳和翻脚，头在内侧，外端胶接盲帽防止轴向脱出。 |  | 93c7823b9c35bcad |  |  |  |  |  |  |  |  | enclosure:hinge_axle_left
hinge_cap_left | printed_part | CalcKey 左销轴盲帽，PETG，FDM打印 | 1 | CalcKey |  | project |  |  | 外径5mm、长2.4mm，盲孔直径2.6mm深1.2mm；与轴端径向留0.1mm胶隙，闭口底1.2mm。 | 用户要求端帽缩短并接近另一端挡头；仅胶接轴端，轴耳外保留0.15mm端隙，实际胶合插入1mm需试配。 |  | 9c19e698548e79df |  |  |  |  |  |  |  |  | enclosure:hinge_cap_left
hinge_axle_right | printed_part | CalcKey 右后脚销轴，PETG，FDM打印 | 1 | CalcKey |  | project |  |  | 轴径2.4mm、杆长17.8mm，一体5×1.5mm挡头；配2.8mm通孔，轴线竖直打印、100%填充，实物校验圆度与承载。 端部入帽1mm，与帽底留0.2mm。 | 贯穿底盖两轴耳和翻脚，头在内侧，外端胶接盲帽防止轴向脱出。 |  | 6bd512ea7f7391fa |  |  |  |  |  |  |  |  | enclosure:hinge_axle_right
hinge_cap_right | printed_part | CalcKey 右销轴盲帽，PETG，FDM打印 | 1 | CalcKey |  | project |  |  | 外径5mm、长2.4mm，盲孔直径2.6mm深1.2mm；与轴端径向留0.1mm胶隙，闭口底1.2mm。 | 用户要求端帽缩短并接近另一端挡头；仅胶接轴端，轴耳外保留0.15mm端隙，实际胶合插入1mm需试配。 |  | c4bc723de5f0c6b2 |  |  |  |  |  |  |  |  | enclosure:hinge_cap_right
hinge_retaining_adhesive | adhesive | 双组份环氧胶，少量，用于PETG销轴盲帽 | 1 |  |  | default |  |  | 两只盲帽仅内孔与轴端点胶；先做所购胶材与实际PETG的粘接小样，固化后确认盲帽不能脱出且铰链能转动。 缩短盲帽后轴端有效胶合插入1mm，先验证帽的轴向保持力。 | 打印销轴的端部保留；承重限位由底盖实体承担，胶不用于粘死脚或轴耳。 |  | 9a00437431e5086e |  |  |  |  |  |  |  |  | epoxy-PETG-axle-cap
lcd_mount_tape | adhesive | 绝缘丙烯酸双面压敏胶片，0.15mm厚，2×4mm小片 | 4 |  |  | default |  |  | 四个边缘座面各一片；只贴PCB外侧无铜/焊点区域，先确认黏附，必要时裁窄避让铜箔。 | 限定PCB装配高度并保持LCD可随底盖拆出；拆胶时支撑PCB，不撬玻璃。 |  | b5015e44d7aa9a0e |  |  | external_procurement_required |  |  |  |  |  | LCD-PCB-PSA-2x4-T0.15
wire_retaining_tape | assembly_material | 聚酰亚胺胶带，宽10mm、总厚不大于0.1mm，1卷 | 1 |  |  | default |  |  | 五座一体穿带桥包夹已绝缘线皮；默认5条10×65mm、搭接≥15mm；矩阵两组各5线松放于前左右区，LCD余线另放左侧；桥顶含胶带束高≤1.5mm。 | 沿用原10mm绝缘胶带，通过圆角穿带孔固定线皮；跨上下壳保留≥65mm自由段，LCD只固定到底盖。 |  | df3f619804a92fdb |  |  |  | 胶带仅固定线束；裸铜及二极管脚继续使用热缩绝缘，黏附力未实测。
matrix_pcb_board | custom_pcb | CalcKey矩阵PCB，73×96mm、1.6mm、双层FR4、1oz | 1 | Project CalcKey | CALCKEY-MATRIX-A | project |  |  | 20键被动矩阵板，裸板按最终发布Gerber制造；不含Pico和LCD。 | 用户明确要求20键矩阵PCB；采购与制板采用matrix当前已发布Gerber，不以手焊行列图代替制造文件。 | {"size_mm": [73, 96, 1.6], "center_local_xy_mm": [0, -14], "top_local_z_mm": 16} | 9c20abb40da344c4
lcd_signal_wire | wiring | LCD引线：26AWG柔性绝缘线，5根低位直焊 | 5 |  |  | default |  |  | 5根26AWG软线，每根总长150mm；GDM0103 P1-P5低位直焊至Pico并固定于底盖穿带桥，P6-P9分别绝缘；不跨主壳，不经过矩阵PCB。 | 屏幕保留既有GPIO和独立安装，不经过矩阵PCB。 |  | df3f619804a92fdb
controller_clamp_a | printed_part | CalcKey主控绝缘压桥A，PLA，FDM打印 | 1 | CalcKey |  | project |  |  | 主控板边压桥，顶端沉孔隐藏M2头；不压芯片或按键，夹持面贴0.15mm绝缘胶片。 | 适配无安装孔的Waveshare RP2350-Plus-16MB，同时保留底盖维护。 |  |  |  |  |  |  |  |  |  |  | enclosure:controller_clamp_a
controller_clamp_b | printed_part | CalcKey主控绝缘压桥B，PLA，FDM打印 | 1 | CalcKey |  | project |  |  | 主控板边压桥，顶端沉孔隐藏M2头；不压芯片或按键，夹持面贴0.15mm绝缘胶片。 | 适配无安装孔的Waveshare RP2350-Plus-16MB，同时保留底盖维护。 |  |  |  |  |  |  |  |  |  |  | enclosure:controller_clamp_b
controller_insulation_pads | adhesive | 绝缘丙烯酸胶片，0.15mm厚，6×1.4mm | 8 |  |  | default |  |  | 4片位于主控边缘座面，4片位于压桥夹持面；避开裸铜焊点，不用厚泡棉替代。 | 隔离PCB焊盘与夹持面并固定装配高度。
