Cailynoo7/CalcKey/product/print-preparation/part-settings.csv

object_id | name | stl | quantity | material | nozzle_mm | layer_mm | first_layer_mm | perimeters_requested | infill_percent | top_solid_layers_min | bottom_solid_layers_min | orientation_already_in_stl | applied_rotation_deg_xyz | bbox_mm | support_recommendation | support_exclusions | brim_suggestion | cleanup_focus | setting_source | stl_sha256
base | 底盖 | product/production/models/base.stl | 1 | PLA | 0.4 | 0.15 | 0.15 | 4 | 20 | 5 | 5 | 托架及三桥朝上；轴耳朝下；底板外侧面距平台约6.2mm | [0, 0, 0] | 89.000×130.000×17.400 | 底板悬空外侧面从平台均匀支撑；轴耳悬垂按后续预览补局部支撑 | 三处穿带孔、2.8mm轴孔、限位面、LCD/主控承托面、螺孔与对位唇边；Type-C孔与接口立台、八处主控绝缘贴面；Type-C孔与接口立台、八处主控绝缘贴面；Type-C孔与接口立台、八处主控绝缘贴面；Type-C孔与接口立台、八处主控绝缘贴面 | 默认无；必要时约5mm外侧裙边 | 先拆大面支撑，再清轴耳；不掰单耳，不靠螺钉拉平翘曲 | default | 8dbadbe84ef31a977737732a5aae7f748d22391339f11a00c898c8612992575d
top | 主壳 | product/production/models/top.stl | 1 | PLA | 0.4 | 0.15 | 0.15 | 4 | 20 | 5 | 5 | 键面朝下；大腔口朝上 | [180, 0, 0] | 89.000×130.000×18.600 | 前内壁两处桥的悬伸底面局部支撑；允许从模型表面生成；USB槽肩按后续预览判断 | 10.6×2穿带孔、轴孔与1.5mm卡扣台阶、螺纹孔、保护片槽、合盖面 | 默认无；必要时约5mm外侧裙边 | 托住桥根分块拆支撑，不磨薄卡扣台阶或扩大轴孔 | default | d890005daf3ba04562d0bf551e93d4b9521c080fb444981d32556bc6156ef0fb
rear_foot_left | 左翻脚 | product/production/models/rear_foot_left.stl | 1 | PETG | 0.4 | 0.15 | 0.15 | 4 | 100 | 5 | 5 | 原X轴向端面贴平台；轴孔轴线沿打印Z | [0, 90, 0] | 6.200×10.350×10.000 | 默认无；仅对后续预览确认的外侧悬垂补可清理局部支撑 | 轴孔、两档脚底接触面、止挡及侧向配合面 | 必要时约3mm外侧裙边 | 去轴孔入口毛刺；不磨掉两档限位或脚底面 | default | bbcb5a1f1f3fa0bdce6daf1746f113fc14a234f8cd8b0bfb8a98969f93142866
rear_foot_right | 右翻脚 | product/production/models/rear_foot_right.stl | 1 | PETG | 0.4 | 0.15 | 0.15 | 4 | 100 | 5 | 5 | 原X轴向端面贴平台；轴孔轴线沿打印Z | [0, 90, 0] | 6.200×10.350×10.000 | 默认无；仅对后续预览确认的外侧悬垂补可清理局部支撑 | 轴孔、两档脚底接触面、止挡及侧向配合面 | 必要时约3mm外侧裙边 | 去轴孔入口毛刺；不磨掉两档限位或脚底面 | default | 11a77dc9681bc6aca2c54b5041b04a271560deba90c1843d7c13632ae579c7e4
hinge_axle_left | 左销轴 | product/production/models/hinge_axle_left.stl | 1 | PETG | 0.4 | 0.15 | 0.15 | 4 | 100 | 5 | 5 | 直径5mm挡头贴平台；2.4mm细杆竖直向上 | [0, -90, 0] | 5.000×5.000×19.300 | 默认无 | 整根细杆及挡头功能面 | 建议约4mm外侧裙边 | 不要夹细杆拧裙边；沿轴向装配，防止层间折断 | default | 6d62b491d0eae5af62c8d0b261496954481df8c39fd8c43ddcd0eb505d834228
hinge_axle_right | 右销轴 | product/production/models/hinge_axle_right.stl | 1 | PETG | 0.4 | 0.15 | 0.15 | 4 | 100 | 5 | 5 | 直径5mm挡头贴平台；2.4mm细杆竖直向上 | [0, -90, 0] | 5.000×5.000×19.300 | 默认无 | 整根细杆及挡头功能面 | 建议约4mm外侧裙边 | 不要夹细杆拧裙边；沿轴向装配，防止层间折断 | default | cab6359550d32c7578f75439939392900b6020c89a62110c40979fc3e020f599
hinge_cap_left | 左短端帽 | product/production/models/hinge_cap_left.stl | 1 | PETG | 0.4 | 0.15 | 0.15 | 4 | 100 | 5 | 5 | 闭口贴平台；直径2.6mm、深1.2mm盲孔朝上 | [0, 90, 0] | 5.000×5.000×2.400 | 默认无 | 盲孔与端面 | 默认无；附着不足时约2mm外侧裙边 | 保留闭口厚度；仅清入口毛刺；胶不进入铰链孔 | default | 7c7bfcf810ecefe4f16ed65cfb4400197b5ced9b3f9e1de838116febfa1ce284
hinge_cap_right | 右短端帽 | product/production/models/hinge_cap_right.stl | 1 | PETG | 0.4 | 0.15 | 0.15 | 4 | 100 | 5 | 5 | 闭口贴平台；直径2.6mm、深1.2mm盲孔朝上 | [0, 90, 0] | 5.000×5.000×2.400 | 默认无 | 盲孔与端面 | 默认无；附着不足时约2mm外侧裙边 | 保留闭口厚度；仅清入口毛刺；胶不进入铰链孔 | default | 8e212d049ec6ae9c2f20e0d824d7cd13396b8e42b3d4e76749afa13113a9b206
key_01 | 键帽 Num | product/production/models/key_01.stl | 1 | PETG | 0.2 | 0.1 | 0.1 | 4 | 100 | 6 | 6 | 字面贴平台；帽腔及十字孔朝上 | [180, 0, 0] | 18.200×18.200×7.000 | 默认无；凹字和5键浅凹点开头几层的短跨后续逐层预览 | 全部帽腔、十字孔、字槽与定位凹点 | 默认无；无筏层 | 轻清拉丝；保留连续0.40mm薄壁；不以实轴强行扩孔 | default | 47b668f21605a484b370ae45f394189963b0950ca7c62c7ab0cc2aa03d19ca51
key_02 | 键帽 ÷ | product/production/models/key_02.stl | 1 | PETG | 0.2 | 0.1 | 0.1 | 4 | 100 | 6 | 6 | 字面贴平台；帽腔及十字孔朝上 | [180, 0, 0] | 18.200×18.200×7.000 | 默认无；凹字和5键浅凹点开头几层的短跨后续逐层预览 | 全部帽腔、十字孔、字槽与定位凹点 | 默认无；无筏层 | 轻清拉丝；保留连续0.40mm薄壁；不以实轴强行扩孔 | default | 03782036bec97451708fa221977bf24764f4aa069293149883e9fb2b36ea0b23
key_03 | 键帽 × | product/production/models/key_03.stl | 1 | PETG | 0.2 | 0.1 | 0.1 | 4 | 100 | 6 | 6 | 字面贴平台；帽腔及十字孔朝上 | [180, 0, 0] | 18.200×18.200×7.000 | 默认无；凹字和5键浅凹点开头几层的短跨后续逐层预览 | 全部帽腔、十字孔、字槽与定位凹点 | 默认无；无筏层 | 轻清拉丝；保留连续0.40mm薄壁；不以实轴强行扩孔 | default | b49f64adef3446512abbcee79820ae1137ab18f0844fabebfba6ab40c6e0acd1
key_04 | 键帽 Bk | product/production/models/key_04.stl | 1 | PETG | 0.2 | 0.1 | 0.1 | 4 | 100 | 6 | 6 | 字面贴平台；帽腔及十字孔朝上 | [180, 0, 0] | 18.200×18.200×7.000 | 默认无；凹字和5键浅凹点开头几层的短跨后续逐层预览 | 全部帽腔、十字孔、字槽与定位凹点 | 默认无；无筏层 | 轻清拉丝；保留连续0.40mm薄壁；不以实轴强行扩孔 | default | 4721d0c03dd6914e826f8abeaa54dec1afb5865fe9229e42990d339a7b242eb8
key_05 | 键帽 7 | product/production/models/key_05.stl | 1 | PETG | 0.2 | 0.1 | 0.1 | 4 | 100 | 6 | 6 | 字面贴平台；帽腔及十字孔朝上 | [180, 0, 0] | 18.200×18.200×7.000 | 默认无；凹字和5键浅凹点开头几层的短跨后续逐层预览 | 全部帽腔、十字孔、字槽与定位凹点 | 默认无；无筏层 | 轻清拉丝；保留连续0.40mm薄壁；不以实轴强行扩孔 | default | 19b2e8bc53dbc2debd7235e945909b3527c3e81836a39ea8bb7841992c025e2e
key_06 | 键帽 8 | product/production/models/key_06.stl | 1 | PETG | 0.2 | 0.1 | 0.1 | 4 | 100 | 6 | 6 | 字面贴平台；帽腔及十字孔朝上 | [180, 0, 0] | 18.200×18.200×7.000 | 默认无；凹字和5键浅凹点开头几层的短跨后续逐层预览 | 全部帽腔、十字孔、字槽与定位凹点 | 默认无；无筏层 | 轻清拉丝；保留连续0.40mm薄壁；不以实轴强行扩孔 | default | 52da9af08a8137ca5061c5c47d02262e8484f8d5db3d4b2e8e99efe1d22dc353
key_07 | 键帽 9 | product/production/models/key_07.stl | 1 | PETG | 0.2 | 0.1 | 0.1 | 4 | 100 | 6 | 6 | 字面贴平台；帽腔及十字孔朝上 | [180, 0, 0] | 18.200×18.200×7.000 | 默认无；凹字和5键浅凹点开头几层的短跨后续逐层预览 | 全部帽腔、十字孔、字槽与定位凹点 | 默认无；无筏层 | 轻清拉丝；保留连续0.40mm薄壁；不以实轴强行扩孔 | default | 8921fa28d16d956f57dad2ec209962a6cc070a8d087733d5cb5a4909e4e21730
key_08 | 键帽 − | product/production/models/key_08.stl | 1 | PETG | 0.2 | 0.1 | 0.1 | 4 | 100 | 6 | 6 | 字面贴平台；帽腔及十字孔朝上 | [180, 0, 0] | 18.200×18.200×7.000 | 默认无；凹字和5键浅凹点开头几层的短跨后续逐层预览 | 全部帽腔、十字孔、字槽与定位凹点 | 默认无；无筏层 | 轻清拉丝；保留连续0.40mm薄壁；不以实轴强行扩孔 | default | 83f584c97ee0bcadd5a4a2492d4255a566bc0d657b6e791d8056467ad27164fd
key_09 | 键帽 4 | product/production/models/key_09.stl | 1 | PETG | 0.2 | 0.1 | 0.1 | 4 | 100 | 6 | 6 | 字面贴平台；帽腔及十字孔朝上 | [180, 0, 0] | 18.200×18.200×7.000 | 默认无；凹字和5键浅凹点开头几层的短跨后续逐层预览 | 全部帽腔、十字孔、字槽与定位凹点 | 默认无；无筏层 | 轻清拉丝；保留连续0.40mm薄壁；不以实轴强行扩孔 | default | c6ffbcc5ad3ed2cb98c84dcdc6535d833ae0e117e913c9cb2335290fbc12b666
key_10 | 键帽 5 | product/production/models/key_10.stl | 1 | PETG | 0.2 | 0.1 | 0.1 | 4 | 100 | 6 | 6 | 字面贴平台；帽腔及十字孔朝上 | [180, 0, 0] | 18.200×18.200×7.000 | 默认无；凹字和5键浅凹点开头几层的短跨后续逐层预览 | 全部帽腔、十字孔、字槽与定位凹点 | 默认无；无筏层 | 轻清拉丝；保留连续0.40mm薄壁；不以实轴强行扩孔；检查5键直径2mm、模型深0.35mm浅凹点 | default | e879a73d1be04f53fa02b7ccfa07a612418e9cd85f69fd4fee46109172fe1357
key_11 | 键帽 6 | product/production/models/key_11.stl | 1 | PETG | 0.2 | 0.1 | 0.1 | 4 | 100 | 6 | 6 | 字面贴平台；帽腔及十字孔朝上 | [180, 0, 0] | 18.200×18.200×7.000 | 默认无；凹字和5键浅凹点开头几层的短跨后续逐层预览 | 全部帽腔、十字孔、字槽与定位凹点 | 默认无；无筏层 | 轻清拉丝；保留连续0.40mm薄壁；不以实轴强行扩孔 | default | 0b44d249af5447622593f87cb8204f160ffa91f2be47439985aed6577a9daf88
key_12 | 键帽 + | product/production/models/key_12.stl | 1 | PETG | 0.2 | 0.1 | 0.1 | 4 | 100 | 6 | 6 | 字面贴平台；帽腔及十字孔朝上 | [180, 0, 0] | 18.200×18.200×7.000 | 默认无；凹字和5键浅凹点开头几层的短跨后续逐层预览 | 全部帽腔、十字孔、字槽与定位凹点 | 默认无；无筏层 | 轻清拉丝；保留连续0.40mm薄壁；不以实轴强行扩孔 | default | af05d786f9e4fb3d9b5353386baa574ebce1b8bdea18af2d792094e1f3330e87
key_13 | 键帽 1 | product/production/models/key_13.stl | 1 | PETG | 0.2 | 0.1 | 0.1 | 4 | 100 | 6 | 6 | 字面贴平台；帽腔及十字孔朝上 | [180, 0, 0] | 18.200×18.200×7.000 | 默认无；凹字和5键浅凹点开头几层的短跨后续逐层预览 | 全部帽腔、十字孔、字槽与定位凹点 | 默认无；无筏层 | 轻清拉丝；保留连续0.40mm薄壁；不以实轴强行扩孔 | default | 9a107cc0950d500b6869690391196ec2abbda88ec230901d79f0241b5090967d
key_14 | 键帽 2 | product/production/models/key_14.stl | 1 | PETG | 0.2 | 0.1 | 0.1 | 4 | 100 | 6 | 6 | 字面贴平台；帽腔及十字孔朝上 | [180, 0, 0] | 18.200×18.200×7.000 | 默认无；凹字和5键浅凹点开头几层的短跨后续逐层预览 | 全部帽腔、十字孔、字槽与定位凹点 | 默认无；无筏层 | 轻清拉丝；保留连续0.40mm薄壁；不以实轴强行扩孔 | default | e7b38470d909e23dfd9c2a25588ac49792e76efa407d9772b477fed7fb4520e7
key_15 | 键帽 3 | product/production/models/key_15.stl | 1 | PETG | 0.2 | 0.1 | 0.1 | 4 | 100 | 6 | 6 | 字面贴平台；帽腔及十字孔朝上 | [180, 0, 0] | 18.200×18.200×7.000 | 默认无；凹字和5键浅凹点开头几层的短跨后续逐层预览 | 全部帽腔、十字孔、字槽与定位凹点 | 默认无；无筏层 | 轻清拉丝；保留连续0.40mm薄壁；不以实轴强行扩孔 | default | 0c04ce66c40bba7931a77e28b4eed47a9539b65daeabed9726d299e6863c21a1
key_16 | 键帽 Enter/= | product/production/models/key_16.stl | 1 | PETG | 0.2 | 0.1 | 0.1 | 4 | 100 | 6 | 6 | 字面贴平台；帽腔及十字孔朝上 | [180, 0, 0] | 18.200×18.200×7.000 | 默认无；凹字和5键浅凹点开头几层的短跨后续逐层预览 | 全部帽腔、十字孔、字槽与定位凹点 | 默认无；无筏层 | 轻清拉丝；保留连续0.40mm薄壁；不以实轴强行扩孔；检查Enter/=上下两行 | default | 8dbc2a78f35759553ce45322ae60f50b17b4f0f4ab16e8754929d3da19e9b172
key_17 | 键帽 Mode | product/production/models/key_17.stl | 1 | PETG | 0.2 | 0.1 | 0.1 | 4 | 100 | 6 | 6 | 字面贴平台；帽腔及十字孔朝上 | [180, 0, 0] | 18.200×18.200×7.000 | 默认无；凹字和5键浅凹点开头几层的短跨后续逐层预览 | 全部帽腔、十字孔、字槽与定位凹点 | 默认无；无筏层 | 轻清拉丝；保留连续0.40mm薄壁；不以实轴强行扩孔 | default | 5906ad71e889846f8704b13930a9f975fdbe61d6b112a6c79a98837680d405e3
key_18 | 键帽 0 | product/production/models/key_18.stl | 1 | PETG | 0.2 | 0.1 | 0.1 | 4 | 100 | 6 | 6 | 字面贴平台；帽腔及十字孔朝上 | [180, 0, 0] | 18.200×18.200×7.000 | 默认无；凹字和5键浅凹点开头几层的短跨后续逐层预览 | 全部帽腔、十字孔、字槽与定位凹点 | 默认无；无筏层 | 轻清拉丝；保留连续0.40mm薄壁；不以实轴强行扩孔 | default | e92fdf1e73cc3db34add5c65aa41c03285edf0483a973a7c876651591f7ad671
key_19 | 键帽 . | product/production/models/key_19.stl | 1 | PETG | 0.2 | 0.1 | 0.1 | 4 | 100 | 6 | 6 | 字面贴平台；帽腔及十字孔朝上 | [180, 0, 0] | 18.200×18.200×7.000 | 默认无；凹字和5键浅凹点开头几层的短跨后续逐层预览 | 全部帽腔、十字孔、字槽与定位凹点 | 默认无；无筏层 | 轻清拉丝；保留连续0.40mm薄壁；不以实轴强行扩孔 | default | 77712f685eb1aa4cc5bceb83e261349f68bec7534f8ec8e5624520f3de47ac19
key_20 | 键帽 AC | product/production/models/key_20.stl | 1 | PETG | 0.2 | 0.1 | 0.1 | 4 | 100 | 6 | 6 | 字面贴平台；帽腔及十字孔朝上 | [180, 0, 0] | 18.200×18.200×7.000 | 默认无；凹字和5键浅凹点开头几层的短跨后续逐层预览 | 全部帽腔、十字孔、字槽与定位凹点 | 默认无；无筏层 | 轻清拉丝；保留连续0.40mm薄壁；不以实轴强行扩孔 | default | bac45ace766ecc45b29e035cab1215377c3105124db98474239f15a17b5dafdc
controller_clamp_a | 主控压桥A | product/production/models/controller_clamp_a.stl | 1 | PLA | 0.4 | 0.15 | 0.15 | 4 | 100 | 5 | 5 | 压脚向下、沉孔向上；已落Z=0 | [0, 0, 0] | 6.000×38.000×5.050 | 仅非接触桥底酌情局部支撑；保留清理路径，不支撑压脚贴胶面 | 螺钉沉孔、板边接触面和绝缘胶片面 | 默认无；必要时约5mm外侧裙边 | 去毛刺后贴0.15mm绝缘胶片，禁止拧紧压弯主控 | default | fc2d2e26d92a25bd2f221dcefcd778b340cab22b48cc27139704e0c0a24591ff
controller_clamp_b | 主控压桥B | product/production/models/controller_clamp_b.stl | 1 | PLA | 0.4 | 0.15 | 0.15 | 4 | 100 | 5 | 5 | 压脚向下、沉孔向上；已落Z=0 | [0, 0, 0] | 6.000×38.000×5.050 | 仅非接触桥底酌情局部支撑；保留清理路径，不支撑压脚贴胶面 | 螺钉沉孔、板边接触面和绝缘胶片面 | 默认无；必要时约5mm外侧裙边 | 去毛刺后贴0.15mm绝缘胶片，禁止拧紧压弯主控 | default | ecdd3bde7a18aaf01ec85c3166c5a1a3310815b2de1432b1dd71fcc88a4dfafd
