Cailynoo7/CalcKey/product/production/print-plan.csv

object_id | file | quantity | material | nozzle_mm | layer_mm | units | scale_percent
base | product/production/models/base.stl | 1 | PLA | 0.4 | 0.15 | mm | 100
top | product/production/models/top.stl | 1 | PLA | 0.4 | 0.15 | mm | 100
rear_foot_left | product/production/models/rear_foot_left.stl | 1 | PETG | 0.4 | 0.15 | mm | 100
rear_foot_right | product/production/models/rear_foot_right.stl | 1 | PETG | 0.4 | 0.15 | mm | 100
hinge_axle_left | product/production/models/hinge_axle_left.stl | 1 | PETG | 0.4 | 0.15 | mm | 100
hinge_axle_right | product/production/models/hinge_axle_right.stl | 1 | PETG | 0.4 | 0.15 | mm | 100
hinge_cap_left | product/production/models/hinge_cap_left.stl | 1 | PETG | 0.4 | 0.15 | mm | 100
hinge_cap_right | product/production/models/hinge_cap_right.stl | 1 | PETG | 0.4 | 0.15 | mm | 100
key_01 | product/production/models/key_01.stl | 1 | PETG | 0.2 | 0.1 | mm | 100
key_02 | product/production/models/key_02.stl | 1 | PETG | 0.2 | 0.1 | mm | 100
key_03 | product/production/models/key_03.stl | 1 | PETG | 0.2 | 0.1 | mm | 100
key_04 | product/production/models/key_04.stl | 1 | PETG | 0.2 | 0.1 | mm | 100
key_05 | product/production/models/key_05.stl | 1 | PETG | 0.2 | 0.1 | mm | 100
key_06 | product/production/models/key_06.stl | 1 | PETG | 0.2 | 0.1 | mm | 100
key_07 | product/production/models/key_07.stl | 1 | PETG | 0.2 | 0.1 | mm | 100
key_08 | product/production/models/key_08.stl | 1 | PETG | 0.2 | 0.1 | mm | 100
key_09 | product/production/models/key_09.stl | 1 | PETG | 0.2 | 0.1 | mm | 100
key_10 | product/production/models/key_10.stl | 1 | PETG | 0.2 | 0.1 | mm | 100
key_11 | product/production/models/key_11.stl | 1 | PETG | 0.2 | 0.1 | mm | 100
key_12 | product/production/models/key_12.stl | 1 | PETG | 0.2 | 0.1 | mm | 100
key_13 | product/production/models/key_13.stl | 1 | PETG | 0.2 | 0.1 | mm | 100
key_14 | product/production/models/key_14.stl | 1 | PETG | 0.2 | 0.1 | mm | 100
key_15 | product/production/models/key_15.stl | 1 | PETG | 0.2 | 0.1 | mm | 100
key_16 | product/production/models/key_16.stl | 1 | PETG | 0.2 | 0.1 | mm | 100
key_17 | product/production/models/key_17.stl | 1 | PETG | 0.2 | 0.1 | mm | 100
key_18 | product/production/models/key_18.stl | 1 | PETG | 0.2 | 0.1 | mm | 100
key_19 | product/production/models/key_19.stl | 1 | PETG | 0.2 | 0.1 | mm | 100
key_20 | product/production/models/key_20.stl | 1 | PETG | 0.2 | 0.1 | mm | 100
controller_clamp_a | product/production/models/controller_clamp_a.stl | 1 | PLA | 0.4 | 0.15 | mm | 100
controller_clamp_b | product/production/models/controller_clamp_b.stl | 1 | PLA | 0.4 | 0.15 | mm | 100
