Cailynoo7/CalcKey/product/diagrams/soldering-map.csv

switch | label | diode | row | row_gpio | row_physical_pin | col | col_gpio | col_physical_pin | diode_anode | diode_cathode
SW01 | NumLock | D01 | 0 | GP2 | 4 | 0 | GP7 | 10 | SW01.2 | R0
SW02 | ÷ | D02 | 0 | GP2 | 4 | 1 | GP8 | 11 | SW02.2 | R0
SW03 | × | D03 | 0 | GP2 | 4 | 2 | GP9 | 12 | SW03.2 | R0
SW04 | Backspace | D04 | 0 | GP2 | 4 | 3 | GP10 | 14 | SW04.2 | R0
SW05 | 7 | D05 | 1 | GP3 | 5 | 0 | GP7 | 10 | SW05.2 | R1
SW06 | 8 | D06 | 1 | GP3 | 5 | 1 | GP8 | 11 | SW06.2 | R1
SW07 | 9 | D07 | 1 | GP3 | 5 | 2 | GP9 | 12 | SW07.2 | R1
SW08 | − | D08 | 1 | GP3 | 5 | 3 | GP10 | 14 | SW08.2 | R1
SW09 | 4 | D09 | 2 | GP4 | 6 | 0 | GP7 | 10 | SW09.2 | R2
SW10 | 5 | D10 | 2 | GP4 | 6 | 1 | GP8 | 11 | SW10.2 | R2
SW11 | 6 | D11 | 2 | GP4 | 6 | 2 | GP9 | 12 | SW11.2 | R2
SW12 | + | D12 | 2 | GP4 | 6 | 3 | GP10 | 14 | SW12.2 | R2
SW13 | 1 | D13 | 3 | GP5 | 7 | 0 | GP7 | 10 | SW13.2 | R3
SW14 | 2 | D14 | 3 | GP5 | 7 | 1 | GP8 | 11 | SW14.2 | R3
SW15 | 3 | D15 | 3 | GP5 | 7 | 2 | GP9 | 12 | SW15.2 | R3
SW16 | Enter/= | D16 | 3 | GP5 | 7 | 3 | GP10 | 14 | SW16.2 | R3
SW17 | Mode | D17 | 4 | GP6 | 9 | 0 | GP7 | 10 | SW17.2 | R4
SW18 | 0 | D18 | 4 | GP6 | 9 | 1 | GP8 | 11 | SW18.2 | R4
SW19 | . | D19 | 4 | GP6 | 9 | 2 | GP9 | 12 | SW19.2 | R4
SW20 | AC | D20 | 4 | GP6 | 9 | 3 | GP10 | 14 | SW20.2 | R4
