Cailynoo7/CalcKey/product/purchasing/matrix/hand-soldering-tools.csv

项目 | 默认规格 | 建议数量 | 说明
温控电烙铁 | 适合0805和通孔焊接，小型凿形/刀形烙铁头 | 1套 | 已有可复用，不计入成品BOM；source=default
电子焊锡丝 | SAC305无铅松香芯，直径0.5mm | 50g/卷×1 | 已有可复用，不计入成品BOM；source=default
电子助焊剂 | 适合手焊、与焊料配套的免清洗电子助焊剂 | 1小支 | 已有可复用，不计入成品BOM；source=default
细尖镊子 | 夹持0805电阻 | 1把 | 已有可复用，不计入成品BOM；source=default
斜口钳 | 剪二极管引脚 | 1把 | 已有可复用，不计入成品BOM；source=default
剥线工具 | 支持26AWG | 1把 | 已有可复用，不计入成品BOM；source=default
万用表 | 电阻/通断/二极管档 | 1台 | 已有可复用，不计入成品BOM；source=default
PCB夹具 | 固定裸板手焊 | 1套 | 已有可复用，不计入成品BOM；source=default
吸锡带 | 约2mm宽 | 1小卷 | 已有可复用，不计入成品BOM；source=default
清洁用品 | 按助焊剂说明准备适合裸PCB的清洁剂与无绒材料 | 1套 | 已有可复用，不计入成品BOM；source=default
