Cailynoo7/CalcKey/product/assembly/component-check-record.csv

id | type | isolated | expected | reading_1 | reading_2 | status | notes
SW01 | 开关 | 未焊散件 | 松开OL；按下直连低阻 |  |  | 待测
D01 | 1N4148 | 未焊散件 | 红A黑K有压降；反向OL |  |  | 待测
SW02 | 开关 | 未焊散件 | 松开OL；按下直连低阻 |  |  | 待测
D02 | 1N4148 | 未焊散件 | 红A黑K有压降；反向OL |  |  | 待测
SW03 | 开关 | 未焊散件 | 松开OL；按下直连低阻 |  |  | 待测
D03 | 1N4148 | 未焊散件 | 红A黑K有压降；反向OL |  |  | 待测
SW04 | 开关 | 未焊散件 | 松开OL；按下直连低阻 |  |  | 待测
D04 | 1N4148 | 未焊散件 | 红A黑K有压降；反向OL |  |  | 待测
SW05 | 开关 | 未焊散件 | 松开OL；按下直连低阻 |  |  | 待测
D05 | 1N4148 | 未焊散件 | 红A黑K有压降；反向OL |  |  | 待测
SW06 | 开关 | 未焊散件 | 松开OL；按下直连低阻 |  |  | 待测
D06 | 1N4148 | 未焊散件 | 红A黑K有压降；反向OL |  |  | 待测
SW07 | 开关 | 未焊散件 | 松开OL；按下直连低阻 |  |  | 待测
D07 | 1N4148 | 未焊散件 | 红A黑K有压降；反向OL |  |  | 待测
SW08 | 开关 | 未焊散件 | 松开OL；按下直连低阻 |  |  | 待测
D08 | 1N4148 | 未焊散件 | 红A黑K有压降；反向OL |  |  | 待测
SW09 | 开关 | 未焊散件 | 松开OL；按下直连低阻 |  |  | 待测
D09 | 1N4148 | 未焊散件 | 红A黑K有压降；反向OL |  |  | 待测
SW10 | 开关 | 未焊散件 | 松开OL；按下直连低阻 |  |  | 待测
D10 | 1N4148 | 未焊散件 | 红A黑K有压降；反向OL |  |  | 待测
SW11 | 开关 | 未焊散件 | 松开OL；按下直连低阻 |  |  | 待测
D11 | 1N4148 | 未焊散件 | 红A黑K有压降；反向OL |  |  | 待测
SW12 | 开关 | 未焊散件 | 松开OL；按下直连低阻 |  |  | 待测
D12 | 1N4148 | 未焊散件 | 红A黑K有压降；反向OL |  |  | 待测
SW13 | 开关 | 未焊散件 | 松开OL；按下直连低阻 |  |  | 待测
D13 | 1N4148 | 未焊散件 | 红A黑K有压降；反向OL |  |  | 待测
SW14 | 开关 | 未焊散件 | 松开OL；按下直连低阻 |  |  | 待测
D14 | 1N4148 | 未焊散件 | 红A黑K有压降；反向OL |  |  | 待测
SW15 | 开关 | 未焊散件 | 松开OL；按下直连低阻 |  |  | 待测
D15 | 1N4148 | 未焊散件 | 红A黑K有压降；反向OL |  |  | 待测
SW16 | 开关 | 未焊散件 | 松开OL；按下直连低阻 |  |  | 待测
D16 | 1N4148 | 未焊散件 | 红A黑K有压降；反向OL |  |  | 待测
SW17 | 开关 | 未焊散件 | 松开OL；按下直连低阻 |  |  | 待测
D17 | 1N4148 | 未焊散件 | 红A黑K有压降；反向OL |  |  | 待测
SW18 | 开关 | 未焊散件 | 松开OL；按下直连低阻 |  |  | 待测
D18 | 1N4148 | 未焊散件 | 红A黑K有压降；反向OL |  |  | 待测
SW19 | 开关 | 未焊散件 | 松开OL；按下直连低阻 |  |  | 待测
D19 | 1N4148 | 未焊散件 | 红A黑K有压降；反向OL |  |  | 待测
SW20 | 开关 | 未焊散件 | 松开OL；按下直连低阻 |  |  | 待测
D20 | 1N4148 | 未焊散件 | 红A黑K有压降；反向OL |  |  | 待测
RPU0 | 10k±1% | 未焊散件 | 9.9–10.1kΩ＋仪表误差 |  |  | 待测
RPU1 | 10k±1% | 未焊散件 | 9.9–10.1kΩ＋仪表误差 |  |  | 待测
RPU2 | 10k±1% | 未焊散件 | 9.9–10.1kΩ＋仪表误差 |  |  | 待测
RPU3 | 10k±1% | 未焊散件 | 9.9–10.1kΩ＋仪表误差 |  |  | 待测
