Cailynoo7/CalcKey/product/matrix-assembly-diagrams/unpowered-check-record.csv

项目 | 红表笔 | 黑表笔 | 条件 | 预期 | 实测 | 结果
COL0上拉 | J6 | J10 | 主控/LCD未连接 | 约10kΩ |  | 待测
COL1上拉 | J7 | J10 | 主控/LCD未连接 | 约10kΩ |  | 待测
COL2上拉 | J8 | J10 | 主控/LCD未连接 | 约10kΩ |  | 待测
COL3上拉 | J9 | J10 | 主控/LCD未连接 | 约10kΩ |  | 待测
SW1/D1 | J6 | J1 | 对应按键按下；主控/LCD未连接 | 二极管正向压降 |  | 待测
SW1/D1 | J1 | J6 | 对应按键按下；主控/LCD未连接 | 截止 |  | 待测
SW2/D2 | J7 | J1 | 对应按键按下；主控/LCD未连接 | 二极管正向压降 |  | 待测
SW2/D2 | J1 | J7 | 对应按键按下；主控/LCD未连接 | 截止 |  | 待测
SW3/D3 | J8 | J1 | 对应按键按下；主控/LCD未连接 | 二极管正向压降 |  | 待测
SW3/D3 | J1 | J8 | 对应按键按下；主控/LCD未连接 | 截止 |  | 待测
SW4/D4 | J9 | J1 | 对应按键按下；主控/LCD未连接 | 二极管正向压降 |  | 待测
SW4/D4 | J1 | J9 | 对应按键按下；主控/LCD未连接 | 截止 |  | 待测
SW5/D5 | J6 | J2 | 对应按键按下；主控/LCD未连接 | 二极管正向压降 |  | 待测
SW5/D5 | J2 | J6 | 对应按键按下；主控/LCD未连接 | 截止 |  | 待测
SW6/D6 | J7 | J2 | 对应按键按下；主控/LCD未连接 | 二极管正向压降 |  | 待测
SW6/D6 | J2 | J7 | 对应按键按下；主控/LCD未连接 | 截止 |  | 待测
SW7/D7 | J8 | J2 | 对应按键按下；主控/LCD未连接 | 二极管正向压降 |  | 待测
SW7/D7 | J2 | J8 | 对应按键按下；主控/LCD未连接 | 截止 |  | 待测
SW8/D8 | J9 | J2 | 对应按键按下；主控/LCD未连接 | 二极管正向压降 |  | 待测
SW8/D8 | J2 | J9 | 对应按键按下；主控/LCD未连接 | 截止 |  | 待测
SW9/D9 | J6 | J3 | 对应按键按下；主控/LCD未连接 | 二极管正向压降 |  | 待测
SW9/D9 | J3 | J6 | 对应按键按下；主控/LCD未连接 | 截止 |  | 待测
SW10/D10 | J7 | J3 | 对应按键按下；主控/LCD未连接 | 二极管正向压降 |  | 待测
SW10/D10 | J3 | J7 | 对应按键按下；主控/LCD未连接 | 截止 |  | 待测
SW11/D11 | J8 | J3 | 对应按键按下；主控/LCD未连接 | 二极管正向压降 |  | 待测
SW11/D11 | J3 | J8 | 对应按键按下；主控/LCD未连接 | 截止 |  | 待测
SW12/D12 | J9 | J3 | 对应按键按下；主控/LCD未连接 | 二极管正向压降 |  | 待测
SW12/D12 | J3 | J9 | 对应按键按下；主控/LCD未连接 | 截止 |  | 待测
SW13/D13 | J6 | J4 | 对应按键按下；主控/LCD未连接 | 二极管正向压降 |  | 待测
SW13/D13 | J4 | J6 | 对应按键按下；主控/LCD未连接 | 截止 |  | 待测
SW14/D14 | J7 | J4 | 对应按键按下；主控/LCD未连接 | 二极管正向压降 |  | 待测
SW14/D14 | J4 | J7 | 对应按键按下；主控/LCD未连接 | 截止 |  | 待测
SW15/D15 | J8 | J4 | 对应按键按下；主控/LCD未连接 | 二极管正向压降 |  | 待测
SW15/D15 | J4 | J8 | 对应按键按下；主控/LCD未连接 | 截止 |  | 待测
SW16/D16 | J9 | J4 | 对应按键按下；主控/LCD未连接 | 二极管正向压降 |  | 待测
SW16/D16 | J4 | J9 | 对应按键按下；主控/LCD未连接 | 截止 |  | 待测
SW17/D17 | J6 | J5 | 对应按键按下；主控/LCD未连接 | 二极管正向压降 |  | 待测
SW17/D17 | J5 | J6 | 对应按键按下；主控/LCD未连接 | 截止 |  | 待测
SW18/D18 | J7 | J5 | 对应按键按下；主控/LCD未连接 | 二极管正向压降 |  | 待测
SW18/D18 | J5 | J7 | 对应按键按下；主控/LCD未连接 | 截止 |  | 待测
SW19/D19 | J8 | J5 | 对应按键按下；主控/LCD未连接 | 二极管正向压降 |  | 待测
SW19/D19 | J5 | J8 | 对应按键按下；主控/LCD未连接 | 截止 |  | 待测
SW20/D20 | J9 | J5 | 对应按键按下；主控/LCD未连接 | 二极管正向压降 |  | 待测
SW20/D20 | J5 | J9 | 对应按键按下；主控/LCD未连接 | 截止 |  | 待测
J1导线 | J1 | 主控物理4 | 断电 | 端到端通断 |  | 待测
J2导线 | J2 | 主控物理5 | 断电 | 端到端通断 |  | 待测
J3导线 | J3 | 主控物理6 | 断电 | 端到端通断 |  | 待测
J4导线 | J4 | 主控物理7 | 断电 | 端到端通断 |  | 待测
J5导线 | J5 | 主控物理9 | 断电 | 端到端通断 |  | 待测
J6导线 | J6 | 主控物理10 | 断电 | 端到端通断 |  | 待测
J7导线 | J7 | 主控物理11 | 断电 | 端到端通断 |  | 待测
J8导线 | J8 | 主控物理12 | 断电 | 端到端通断 |  | 待测
J9导线 | J9 | 主控物理14 | 断电 | 端到端通断 |  | 待测
J10导线 | J10 | 主控物理36 | 断电 | 端到端通断 |  | 待测
LCD P1导线 | LCD P1 | 主控物理15 | 断电 | 端到端通断 |  | 待测
LCD P2导线 | LCD P2 | 主控物理2 | 断电 | 端到端通断 |  | 待测
LCD P3导线 | LCD P3 | 主控物理1 | 断电 | 端到端通断 |  | 待测
LCD P4导线 | LCD P4 | 主控物理38 | 断电 | 端到端通断 |  | 待测
LCD P5导线 | LCD P5 | 主控物理36 | 断电 | 端到端通断 |  | 待测
