Cailynoo7/CalcKey/product/matrix-assembly-diagrams/01-component-orientation.png

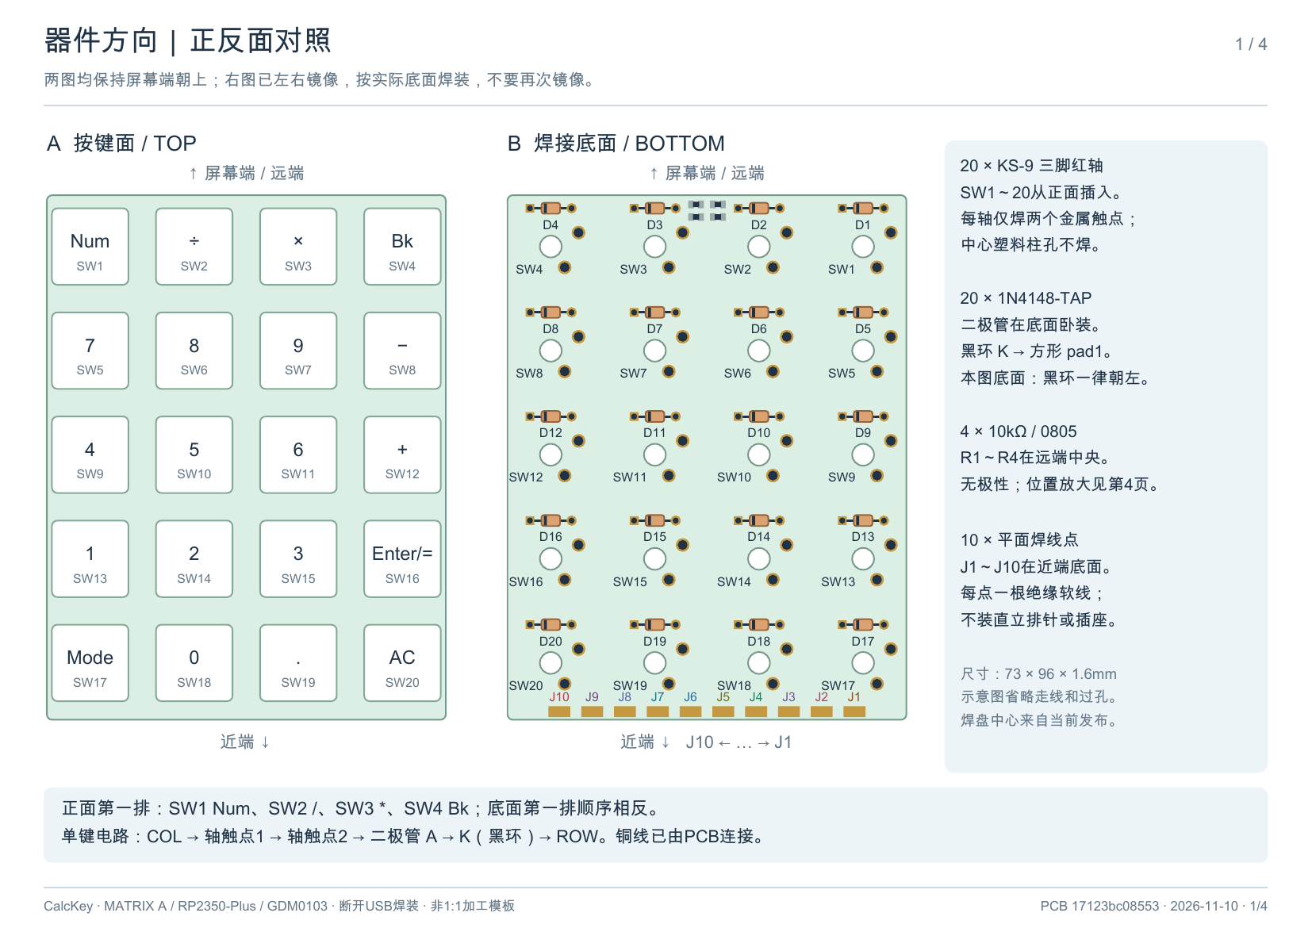
product/matrix-assembly-diagrams/01-component-orientation.png
