Cailynoo7/CalcKey/manufacturing/matrix/releases/17123bc08553010640eaa377912e790923ec95a26949b1e102fa73c7f9b2c727/package/assembly.step

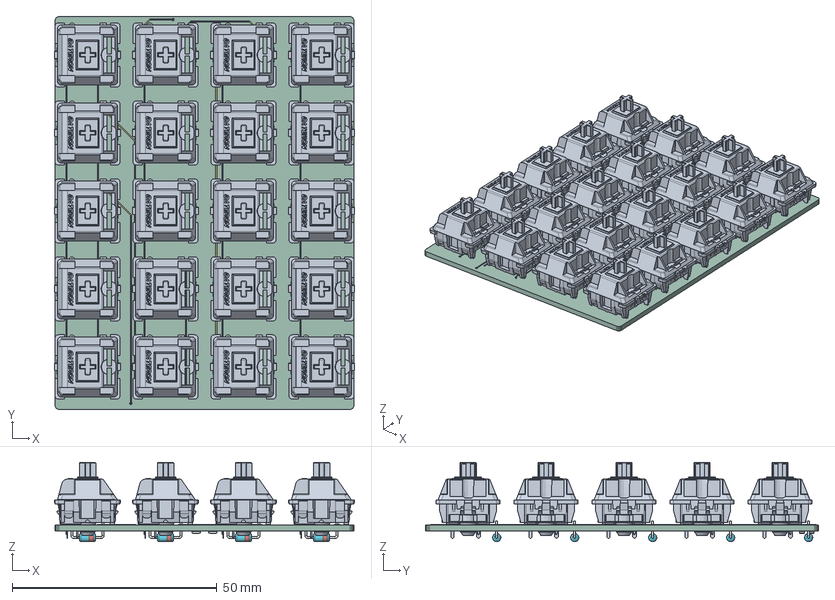
[picture p4: CAD file, 2026-11-06]
manufacturing/matrix/releases/17123bc08553010640eaa377912e790923ec95a26949b1e102fa73c7f9b2c727/package/assembly.step
73.4 x 96.0 x 19.4 mm
RD-0A28913hz x 20
R_0805_2012Metric x 4
D_DO-35_SOD27_P7.62mm_Horizontal x 20
board_copper
board_pad
board_via
board_PCB
