Cailynoo7/CalcKey/design/matrix/source/models/ks9.step

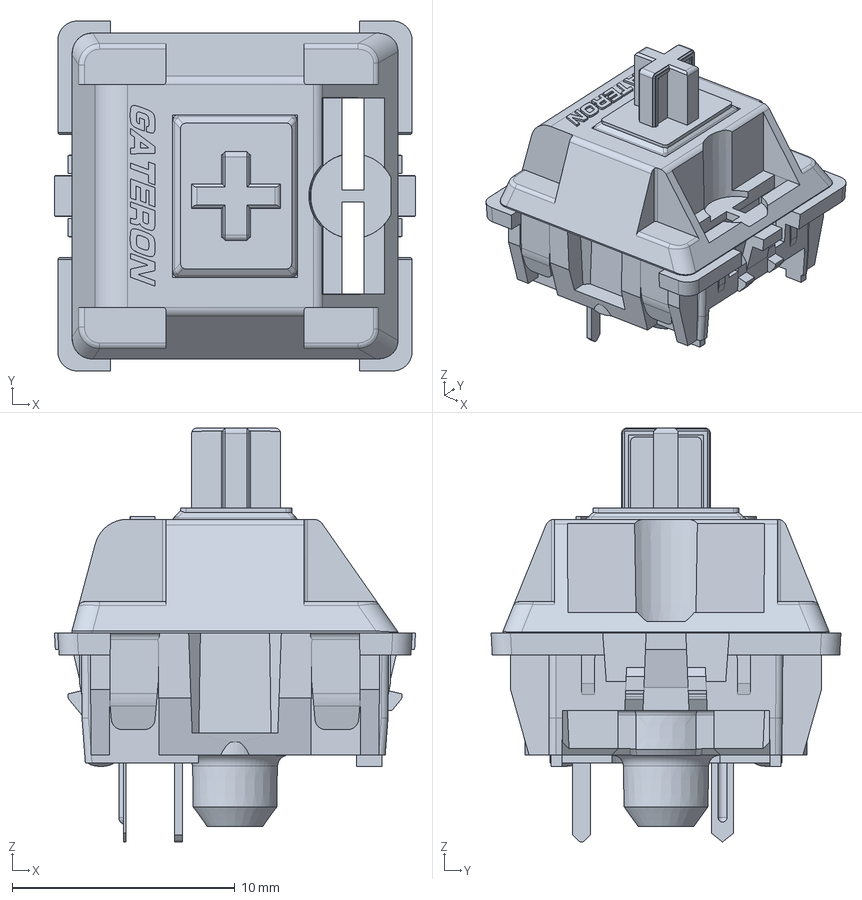
[picture p5: CAD file, 2026-11-06]
design/matrix/source/models/ks9.step
16.2 x 15.7 x 18.6 mm
