Cailynoo7/CalcKey/product/production/models/top.stl

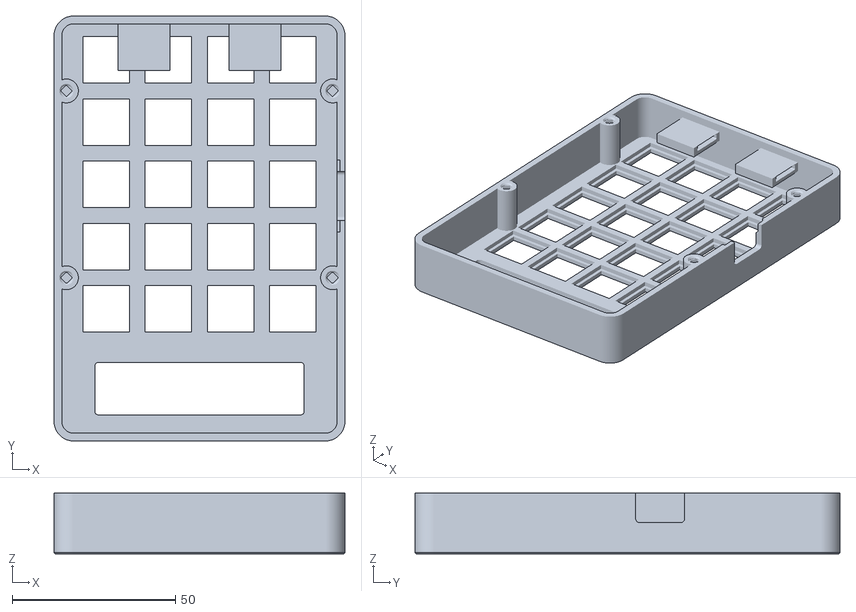
[picture p6: CAD file, 2026-11-10]
product/production/models/top.stl
89.0 x 130.0 x 18.6
