Cailynoo7/CalcKey/design/enclosure/source/assets/a6dc199a3a4e298685d6ed8e8ca74fd55980cce419e5dcee973fb04c4cd22006.step

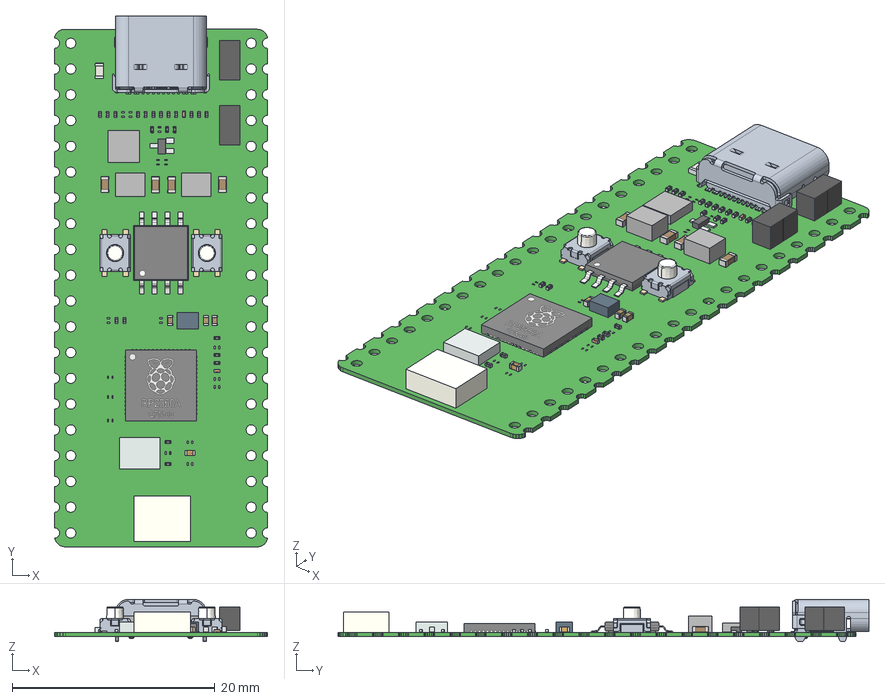
[picture p7: CAD file, 2026-11-10]
design/enclosure/source/assets/a6dc199a3a4e298685d6ed8e8ca74fd55980cce419e5dcee973fb04c4cd22006.step
21.0 x 52.3 x 4.16 mm
Board
3_1_A x 4
Anschl_X_FCsse_1 x 22
K_X_F6rper_1 x 22
User_Library-Chip_Cap_MLCC_0201_(0603) x 18
Extruded x 15
User_Library-RP2350A
Legs_Seite_2
Legs_Seite_1
ts-1185ec-a-e-a-1 x 2
CAPC1608(0603) x 4
