Cailynoo7/CalcKey/product/production/models/base.stl

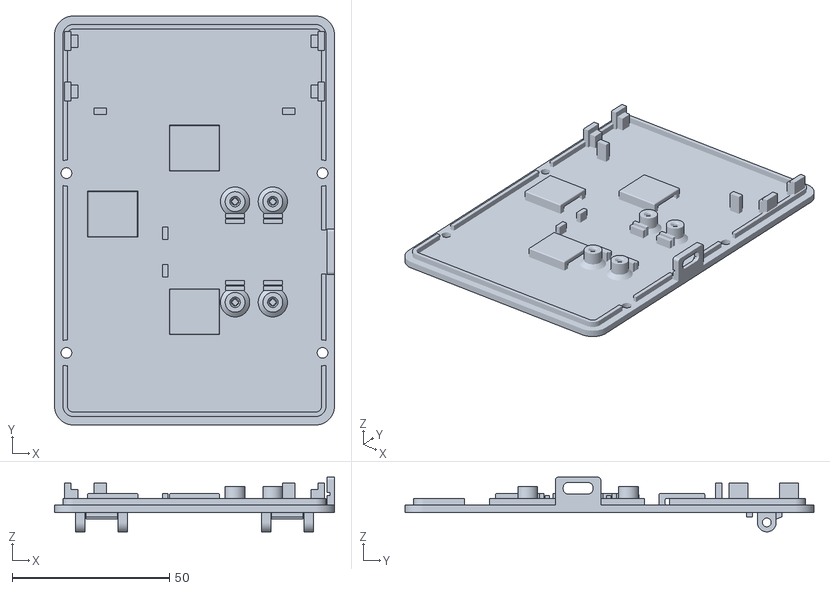
[picture p8: CAD file, 2026-11-10]
product/production/models/base.stl
89.0 x 130.0 x 17.4
