Cailynoo7/CalcKey/design/enclosure/source/assets/d49ada10d893cfcb07cb4abced0a0a0cadca4c4150f153d874268ca06171a24f.step

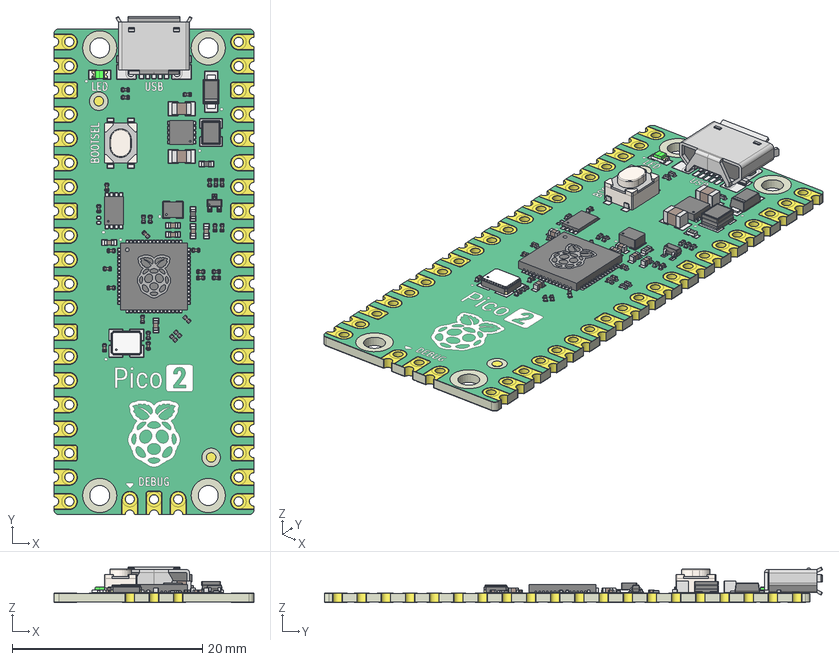
[picture p9: CAD file, 2026-11-06]
design/enclosure/source/assets/d49ada10d893cfcb07cb4abced0a0a0cadca4c4150f153d874268ca06171a24f.step
21.0 x 52.3 x 3.77 mm
CapacitorMainBody x 21
CapacitorContacts x 21
ResistorMainBody x 17
ResistorBlackLayer x 17
ResistorContacts x 17
Pins x 7
Package x 5
EP x 3
Pin1Indicator x 5
Logo
Chassis
Contacts x 3
Back
CathodeIndicator
Lid
Pads
PinIndicator
White_Body
Lens
Plastic_Body
Metal_Plate
Plastic_Plunger
rpi_pico2_PCB
