Cailynoo7/CalcKey/product/production/models/controller_clamp_b.stl

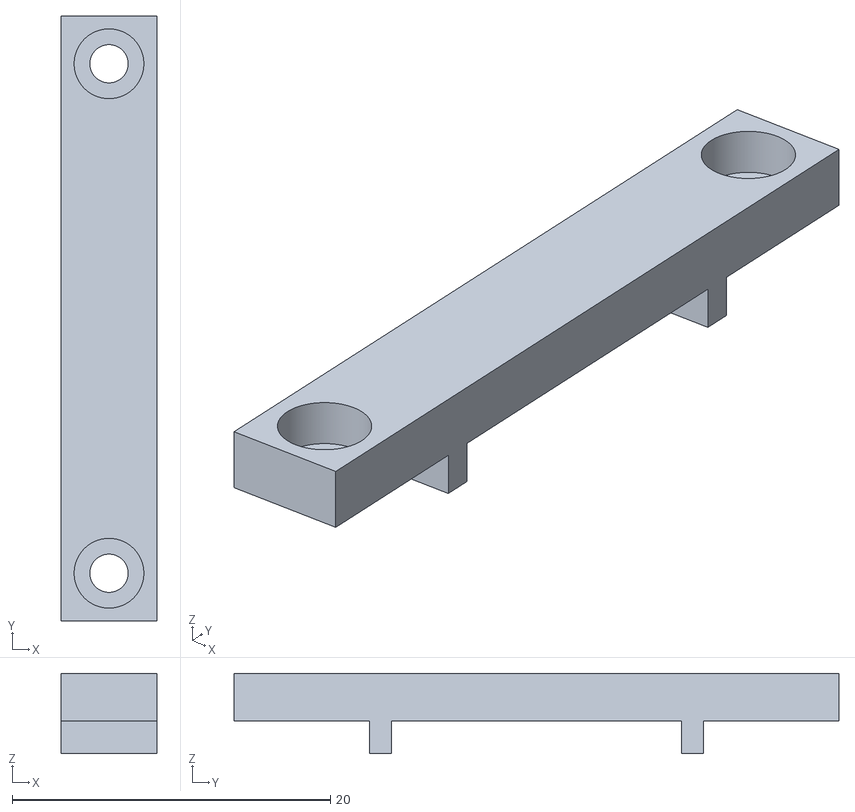
[picture p10: CAD file, 2026-11-10]
product/production/models/controller_clamp_b.stl
6.00 x 38.0 x 5.05
