Cailynoo7/CalcKey/product/production/models/key_01.stl

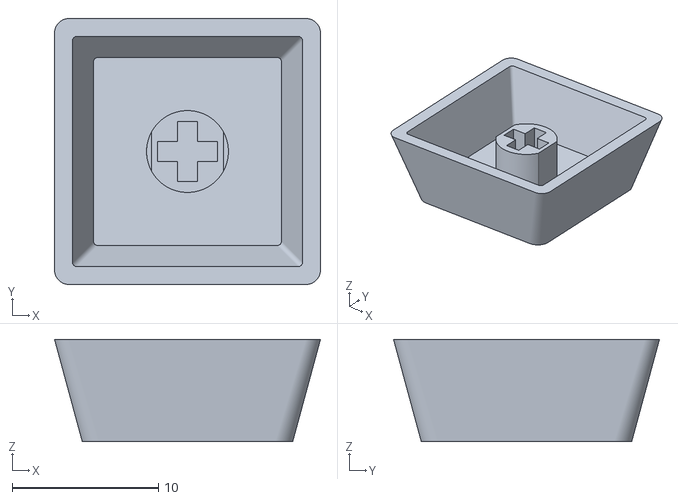
[picture p11: CAD file, 2026-11-06]
product/production/models/key_01.stl
18.2 x 18.2 x 7.00
