Cailynoo7/CalcKey/product/production/models/hinge_cap_left.stl

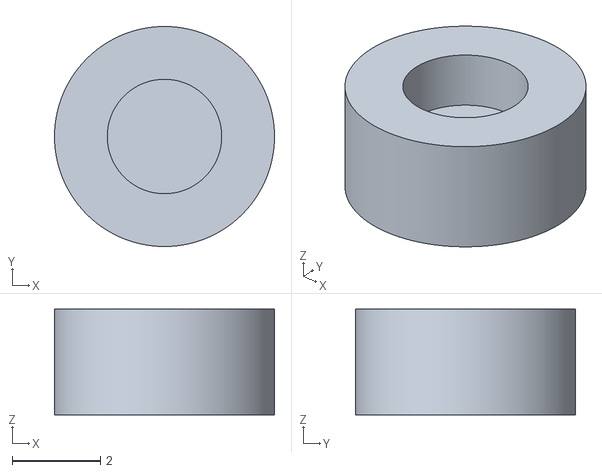
[picture p12: CAD file, 2026-11-06]
product/production/models/hinge_cap_left.stl
5.00 x 5.00 x 2.40
