Cailynoo7/CalcKey/product/production/models/hinge_axle_left.stl

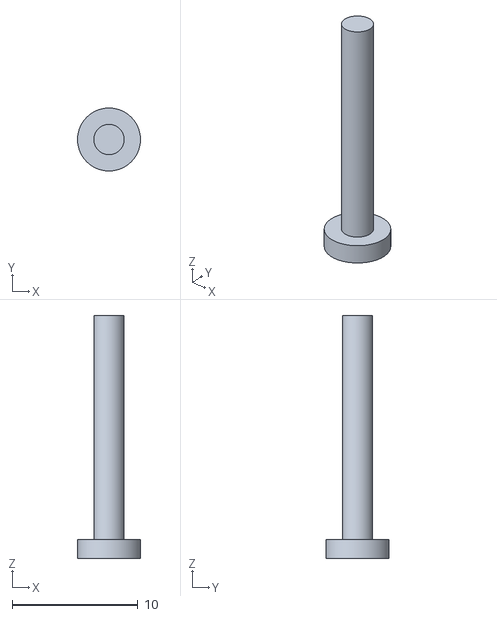
[picture p13: CAD file, 2026-11-06]
product/production/models/hinge_axle_left.stl
5.00 x 5.00 x 19.3
