Cailynoo7/CalcKey/product/production/models/rear_foot_right.stl

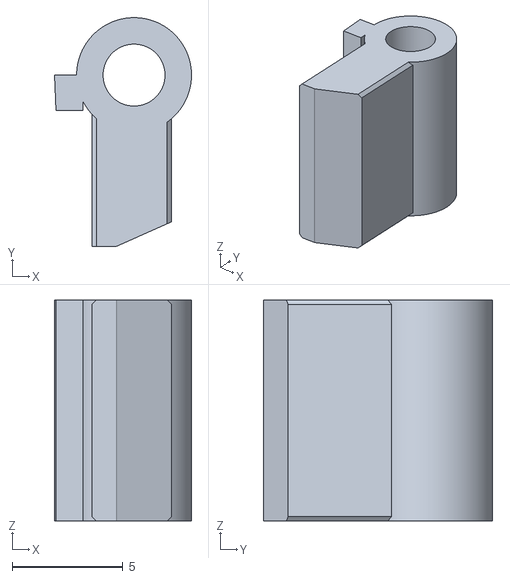
[picture p14: CAD file, 2026-11-06]
product/production/models/rear_foot_right.stl
6.20 x 10.3 x 10.00
