Cailynoo7/CalcKey/(list of files, cad)

Other CAD files:
manufacturing/enclosure/releases/export-fa411383a0f6c23d36fed4b6df68eda5/model.step
product/cad-compatibility/before-seat-fix.step
product/production/history/before-runtime-refresh.step
product/production/models/controller_clamp_a.stl
product/production/models/key_17.stl
product/production/models/key_09.stl
product/production/models/key_02.stl
product/production/models/key_03.stl
product/production/models/key_16.stl
product/production/models/key_20.stl
product/production/models/key_05.stl
product/production/models/key_07.stl
product/production/models/key_11.stl
product/production/models/key_13.stl
product/production/models/key_10.stl
product/production/models/key_19.stl
product/production/models/key_06.stl
product/production/models/key_18.stl
product/production/models/key_12.stl
product/production/models/key_08.stl
product/production/models/key_14.stl
product/production/models/key_15.stl
product/production/models/key_04.stl
product/production/models/hinge_axle_right.stl
product/production/models/hinge_cap_right.stl
product/production/models/rear_foot_left.stl
design/enclosure/source/assets/650977cc5a1bbeaab4eabdefd3f547642a1c34a5a8e5cbf49ac6f8b575c979f4.step
