Cailynoo7/CalcKey/product/print-preparation/README.md

# CalcKey 全套打印件准备建议

适用当前固定桥版本：30件，主壳1、底盖1、主控压桥2、翻脚2、销轴2、短端帽2、键帽20。依据当前已发布STEP、STL及模型清单整理；单位mm、比例100%。本次只整理工艺建议，没有切片、排盘、生成G-code、打印、上电或烧录。打印机、耗材品牌与平台尚未指定，以下工艺值均为`source=default`的起点，不是经过试打的机器配置。用户此前选择跳过小样试打，本说明不将其重新列为前置条件。

## 版本与文件选择

当前30件以production/model-manifest.json及完整包清单绑定STEP。主壳、底盖和两只压桥从Type-C已校验STEP转换，其余26件在形状、安装位置和字节核对后复用；历史来源没有改称新实测。STL已应用打印朝向和Z=0平移，不要再套装配4°倾角。

透明保护片单独切割，不打印电子件、螺钉或轴体。材料和支撑为未试打的工艺默认值，切片器、打印机和耗材型号仍由实际制作条件决定。

## 材料与工艺分组

这是按耗材和喷嘴分组的建议，不是已排好的打印板。

| 组别 | 零件 / 数量 | 材料 | 喷嘴 / 常规层高 | 壁数 / 填充起点 | 首层建议 |
| --- | --- | --- | --- | --- | --- |
| A | 主壳、底盖 / 2 | 普通PLA | 0.4 / 0.15mm | 4道 / 20%陀螺填充 | 0.15mm；大平面平整、无挤料堆积 |
| A2 | 主控压桥A/B / 2 | 普通PLA | 0.4 / 0.15mm | 4道 / 100% | 0.15mm；压脚贴面保留清洁 |
| B | 左右翻脚、销轴、端帽 / 6 | 普通PETG | 0.4 / 0.15mm | 4道 / 100% | 0.15mm；销轴小底面优先外侧裙边 |
| C | 20只正式键帽 / 20 | 普通PETG | 0.2 / 0.10mm | 4道上限 / 100% | 0.10mm；看清字槽和5键浅凹点 |

默认至少5层顶/底实心层；键帽至少6层。小截面容不下4道壁时以真实几何为限；100%填充只填充模型实体，不封住帽腔、十字孔或其他设计孔洞。键帽最薄插座壁约0.40mm，必须保留连续挤出线；0.4mm喷嘴不直接替代当前0.2mm键帽方案。避免含纤维、发泡或颗粒填充料，以免精细孔壁、层间结合及喷嘴适配与既有方案不同。

PLA用于室内桌面壳体，PETG用于需要一定韧性的脚、轴帽和键帽；这沿用现有模型清单。PLA高温下容易变形，壳体不按车内暴晒用途使用。PETG可能拉丝，桥接、细节与支撑脱离较难，不能把“材料较韧”等同于细孔或薄壁已经验证。[PLA材料说明](https://help.prusa3d.com/article/pla_2062) · [PETG材料说明](https://help.prusa3d.com/article/petg_2059)

温度、热床、风扇、回抽和流量采用实际打印机与耗材厂家匹配的配置；本次不写一套通用温度。细小外轮廓可从10～20mm/s、壳体外壁20～30mm/s保守起步，属于未校准默认值；小件按耗材配置保持层间冷却时间，不以把温度降到欠熔来消除拉丝。PETG平台按平台厂家要求选择，光滑PEI须特别遵守隔离层要求，避免过强粘附。[PETG平台与配置依据](https://help.prusa3d.com/article/petg_2059)

## 每类零件的朝向与支撑

### 主壳 top：键面向下、大腔口向上

现有STL打印包络约89×130×18.6mm，主壳外侧键面朝平台，内部朝上。模型已在零件坐标绕X旋转180°，无需重摆。

- **支撑重点：前内壁两处穿带桥的悬伸底面。** 在其下方限制生成可移除局部支撑；需允许支撑从模型表面生长，不能假定“仅从热床生成”一定能托住被面板遮挡的位置。
- 两座桥的打印前零件坐标根部中心为`(-17,-55.7,5.2)`和`(17,-55.7,5.2)`；这是CAD零件坐标，不能直接当成STL切片坐标。找靠近前壁、朝腔内伸出的两块桥即可。
- 10.6×2mm穿带孔、20个轴孔、1.5mm卡扣台阶、螺纹孔、保护片槽及合盖面设为支撑避让区，不能用满腔自动支撑。桥孔顶优先作为10.6mm短跨处理；如果实际桥接不能成形，需另改局部方案，不能将难以清除的支撑塞入2mm高孔内。
- USB开口和局部槽肩在后续切片时逐层查看；必要时只在可接近、可清理的开口处添加局部支撑。不能仅按统一悬垂角度宣布整件免支撑。
- 默认不用筏层。外轮廓如需提高附着，可用约5mm外侧裙边；不要扩进轴孔或屏幕窗口。
- 清理时托住桥根部，分小块拆支撑；不得借桥、薄卡扣台阶或螺柱当撬杆。只去毛刺，不磨薄1.5mm夹持台阶，也不扩大轴孔。

### 底盖 base：托架向上、铰链耳向下

现有STL打印包络约89×130×17.4mm。保持当前朝向，LCD/主控座面及三处穿带桥朝上。后端轴耳和限位结构比底板外侧面更低；当前STL底板外侧面约在平台上方6.2mm，**不能直接把整块底板作为接触平台的平底来免支撑打印**。

- 底板外侧悬空区域需要从平台生成可移除支撑，覆盖实际悬空底面；轴耳周边按其悬垂补充局部支撑。底板支撑界面应均匀，不只托住四角。
- 轴耳2.8mm轴孔、限位接触面及后脚活动空间避免塞满支撑；孔顶按小跨度查看。若必须在孔缘有接触，保持能从外侧清除，不能粘死在孔内。
- 三处穿带孔继续按10.6mm短跨处理，孔内禁填支撑。LCD/主控承托面、对位唇边、螺孔和胶片座面保持干净，不用支撑疤痕充当安装高度。
- 先拆大面支撑，再处理轴耳附近小块，手托两耳；不拉扯单耳去扯掉整张支撑。
- 平台冷却后再取件；检查底板翘曲，螺钉不能用于强行拉平翘曲底盖。

### 左右翻脚：轴向端面贴平台

左右各1件，约6.2×10.35×10mm打印包络；现有STL已绕零件Y轴90°，原轴孔轴线沿打印Z方向。保持该方向，两档落桌接触面与止挡按模型保留。

- 默认不加支撑；端部小倒角及斜面在后续预览中检查，必要时仅在可清理的外轮廓补少量支撑。
- 约3mm外侧裙边可作为小件附着的起点；孔内不生成裙边或支撑。
- 重点清理轴孔入口的象脚和毛刺。保留两档脚底接触面、止挡凸部和0.25mm侧隙对应的端面，不能为了好转动而随意磨掉限位。

### 左右销轴：挡头贴平台、细杆向上

左右各1件，约5×5×19.3mm打印包络，杆径2.4mm、挡头直径5mm；现有STL已绕Y轴-90°。默认无支撑、100%填充，建议约4mm外侧裙边稳住挡头。

- 保留细杆连续周长，后续预览中不得有间断或孤立段；最小层时间优先遵循PETG配置。
- 竖打印节省支撑并保留圆度，但细杆横向受力仍受层间强度影响，100%填充不能证明能抗扭或无限承载。
- 从裙边外缘向内逐步清理，不夹住细杆拧掉裙边；只清理挡头底缘毛刺。装配时支撑耳座，沿轴向插入，不弯杆硬挤。

### 左右短端帽：闭口贴平台、盲孔向上

左右各1件，约5×5×2.4mm；盲孔直径2.6mm、深1.2mm，销轴名义胶合插入1mm。现有STL已绕Y轴90°。默认无支撑、100%填充；附着不足时才使用约2mm外侧裙边。

- 孔内不加支撑，不灌胶找平；先清除入口毛刺并干装，保留闭口壁厚。
- 保持当前短帽尺寸，不误用历史4.4mm端帽。胶仅用于轴端与帽的连接，不能流入2.8mm铰链轴孔；名义1mm胶接保持力仍待实测。

### 20键帽：字面贴平台、帽腔与十字孔向上

每只打印包络约18.2×18.2×7mm，顶部外观面实际约14.4mm宽；现有STL已绕X轴180°。默认无支撑、无筏层、无裙边，保留帽腔和十字孔。

- 使用0.2mm喷嘴、0.10mm层高；打印预览须能保留4.10×1.40mm十字孔和约0.40mm最薄插座壁，不能用“自动修复”为由封孔或删薄壁。
- 字面接触平台，平台纹理会转印到手指接触面；PETG采用实际平台支持的细纹/缎面或带厂家规定隔离层的平台。首层不要过度压挤，否则文字、定位凹点边缘及外缘可能被挤糊。
- key_10是“5”，带直径2mm、名义深0.35mm的浅凹点；key_16是上下两行“Enter”和“=”。凹字与凹点在开始几层会形成局部跨桥，后续需逐层检查，孔内和字槽不填支撑。0.35mm为模型深度，不承诺打印层离散后恰好得到同一深度。
- 不做自动整体缩放、孔径补偿或模糊表面处理。若实物偏紧，应另记录并修改插座参数，不能用整帽缩放同时改变键距、外形与行程避让。
- 清理拉丝时不要把工具插入十字孔内刮削；不热熔修孔、不用实轴芯强行扩孔。帽腔、插座入口和裙边残留只做轻微去毛刺。
- 20只均为单色实体凹刻，不需要额外打印字块；填色可作为后续外观工艺，不作为装配条件。

## 后续切片应检查的内容

本次没有运行切片，以下是未来预览时要查看的项目，均未记为已通过。

1. 分组使用正确喷嘴，模型mm/100%，保留本版STL朝向；同时保留件号，防止左右件或“5”“Enter/=”混淆。
2. 主壳桥底有可拆的托底，底盖大面下方有支撑；全部支撑都有实际拆出路径。支撑界面的Z/XY间隔使用具体切片器、喷嘴、层高及材料适配的配置，不把间隙一律设成0。支撑画选与阻挡区需结合生成结果复核。[支撑配置依据](https://help.prusa3d.com/article/support-material_1698)
3. 五个10.6×2mm孔内可通带；轴孔、十字孔、卡扣台阶、螺纹孔和合盖面没有不可清理的支撑或裙边。
4. 20帽的插座薄壁有连续走线；5键浅凹点和Enter/=双行槽均保留。小轴没有缺线、过短层时间导致的积热或层间欠熔。
5. 所有孤立区域被合理承托。不要通过启用“仅热床支撑”或关闭支撑后忽略悬空层来缩短时间。
6. 只有实际切片后才报告耗材重量、打印时长、支撑用量和最大平台占用；本说明不把实体体积或包围盒等同于这些数值。

## 制件清理后的断电机械检查

充分冷却后拆支撑，清除碎屑与拉丝，再让电子件接近壳体；先干装，后按现有整机装配说明胶接和锁螺钉。

- 核对30件数量，主壳与底盖自然合缝，LCD/主控座面平整，不能靠拧螺钉强压装配。
- 五个穿带孔可通过10mm、总厚≤0.1mm的聚酰亚胺胶带，无刮破线皮的毛刺；桥根无裂纹。
- 两脚在两档均能抵住预定限位，脚底接触桌面；端帽不擦侧耳，销轴/胶接无松脱。检查不代表载荷寿命已验收。
- 各轴坐平、卡扣回弹；20帽插座无裂纹，按到底不擦壳、释放回弹。结合现有154项待测整机表记录真实结果，不预填合格。
- 装PCB、LCD及线束时保持所有外部供电断开；电气测点沿用原指南。本说明不实施焊接、通电或固件写入。

## 证据与当前限制

数量、几何、朝向与文件哈希在`source-checks.json`绑定当前模型清单、STEP导出记录和30个STL。材料/喷嘴/层高沿用已交付默认值；新增壁数、填充、裙边、速度与支撑策略属于未试打的工艺默认值。没有指定打印机，不生成打印机专用配置，也没有真实切片、附着、支撑可拆性或强度结果。

初次整理本说明时记录的螺钉接口错误（缺少seat参数）已在后续CAD兼容修复中解决：两处调用显式使用seat="surface"，重建成功；32个对象数值事实一致，28个打印实体经规范化STEP或双向实体差集对照确认未改形。详见`../cad-compatibility`。该修复没有改变本说明的材料、打印朝向或支撑建议，所有实际打印与强度结果仍待测。

本补充由当前完整制作包的package-manifest.json逐文件列出，并与修复后CAD、STEP、PCB及LCD固件记录共同封装。

## Type-C压桥及开口补充

主控压桥两只为PLA，每只打印包络约6×38×5.05mm，沉孔朝上、压脚朝下，STL已落Z=0。仅在非接触桥底需要时加可移除局部支撑，不在板边压脚或0.15mm绝缘胶片贴面堆支撑。主壳与底盖采用Type-C版，外露孔9.44×3.66mm，内侧另为金属壳避空；孔内不留难清理支撑或残丝，不用工具随意扩孔。底盖外侧主平面仍因轴耳而离平台，需要均匀支撑；两只压桥不按键帽参数打印。

材料数量为PLA 4件、PETG 26件；八颗螺钉分别是4颗M3×8合盖、4颗M2×6压桥。打印公差、主控真实板厚及夹持仍待实物验收，不能通过拧弯板来补差。
