Cailynoo7/CalcKey/product/keycap-fit-guide.md

> 用户已选择跳过打印试配；本文保留为可选历史资料。正式制作以production说明与正式整机模型为准。

# CalcKey 自制打印键帽与试配

用户确定实际键帽采用3D打印。20个正式帽体已包含中心MX十字盲孔插座，每个键帽单独建模为一个有效连续实体，凹刻键位文字；外购DSA帽和键位贴纸不再是必需件。另提供三只完整试配帽，先标定实际轴芯与打印工艺。

## 结构与参数

| 尺寸 | 正式帽默认值 | 性质 |
| --- | --- | --- |
| 帽底宽×深 | 18.2×18.2mm | 自定义1U，19.05mm键距 |
| 顶面宽×深 | 14.4×14.4mm | 平顶，非厂家DSA标准外形 |
| 帽高 | 7mm | 不含独立底座，帽壳与插座为一体 |
| 侧壁/顶壁 | 1.2/1.6mm | PETG精细打印默认 |
| 插座外径 | 5.6mm | 松紧与轴体上盖避空需实配 |
| 十字孔总长/臂宽 | 4.10/1.40mm | 自制试配初值，不是佳达隆原厂公差 |
| 盲孔深度 | 3.3mm | 入口内缩1.4mm，止挡距帽底4.7mm |
| 入口导向 | 0.1mm | 下段两侧削平宽4.8至帽内z5.1；入口局部最薄壁0.25mm |
| 文字凹刻深度 | 0.35mm | 与帽体一体，可填色 |

插座向顶壁内搭接0.2mm并融合；十字孔在止挡面封闭，上方保留实体，不贯穿顶面。十字孔由两条相交矩形切除，名义截面积9.52mm²。底面视图中的中央圆柱就是实际打印插座，不是单独装配的零件。

官方KS-9模型法兰支承底面至轴顶10.2mm；止挡距帽底4.7mm，对应帽底离面5.5mm。20帽静止对完整轴体无穿插；下压4mm对外壳最小余量1.5mm（网格0.02、步长0.25mm、17姿态）。厂家STEP将轴芯与壳体融合：只读试算去除量得的5×6.55mm活动轴芯投影后，20帽对其余外形均无干涉；这不验证内部运动机构。真实座高、回弹与松紧仍需试配。

## 三只试配帽

| 编号 | 十字孔总长 | 臂宽 | 深度 | 入口名义最薄壁 |
| --- | --- | --- | --- | --- |
| P0 | 4.10mm | 1.40mm | 3.3mm | 0.250mm |
| P5 | 4.15mm | 1.45mm | 3.3mm | 0.225mm |
| P10 | 4.20mm | 1.50mm | 3.3mm | 0.200mm |

增量指整个孔长和臂宽的变化，不是每侧间隙；三样不是松紧保证档位。打印机、线材、方向改变后，需要重新判断。

## 打印和选择

1. 默认PETG、0.2mm喷嘴、0.1mm层高，同一批三样保持同工艺。平顶朝下贴板、帽腔/十字孔向上；这是打印朝向，不直接沿用整机中4°倾斜的姿态。平顶设计使此方向不需给孔内加支撑。
2. 查看切片中的插座连续周长与十字孔空域，确认没有漏壁或封孔。0.20–0.25mm削平段入口局部薄壁属于小插座试配特征，不能保证常规0.4mm喷嘴下的成型和强度；不要在孔内塞支撑材料。
3. 待件充分冷却，清除松散残料，检查入口无裂纹。不要预先强行扩孔到失去记录的尺寸。
4. 托住实际KS-9H10B045NN-X14底座，沿轴线轻推P0；明显过紧就停止，换P5/P10。不扭着硬压，不靠拉键帽把轴体从面板拔出。
5. 选择能够稳定就位、按压不脱落且能轴向拔取的一只。记录帽底到面板的实际高度；按到底检查帽裙、插座是否碰轴体上盖或面板，以及松手是否回弹。
6. 做少量反复插拔并观察插座根部和孔端裂纹。三样都紧/都松时，调整正式帽公共参数keycap_socket_fit_delta后重做小样；不涂胶来掩盖配合问题。
7. 用选定结果先确认一只完整文字帽，再打印其余19只。正式20帽共享同一帽体与插座参数；文字大小/深度可逐键调整。外壳轴孔和轴体卡扣保持力仍需单独试装。

## 已完成与待完成

- 已完成：20个正式打印帽、三种试配帽、单实体/有效性检查、十字孔截面和盲孔止挡检查、20帽4mm路径检查、STEP导出。
- 待完成：实际打印收缩、插拔松紧、座高、融合模型未独立表达的内部运动、卡扣固定、薄壁裂纹与寿命。没有打印或上电实测结果。

工艺参考：[Adafruit打印键帽](https://learn.adafruit.com/3dprinted-custom-keycaps/customize)、[KeyV2作者可调插座参数](https://github.com/rsheldiii/KeyV2/blob/master/src/settings.scad)。本项目为自主建模，未复制第三方模型源码，未把其参数当作已选KS-9的原厂公差。

## 与六孔机械轴安装试片配合

使用独立70×60×3mm PLA试片，先比较A–D的14.0/14.1/14.2/14.3mm孔，再比较E/F的1.35/1.65mm夹持台阶；C孔14.2/T1.50复现当前主壳。先确认真实轴肩面坐平、原轴卡扣回弹和保持，再在合适孔内比较三帽。试片与键帽分别按各自材料/喷嘴制作；联合试配方法与记录见机械轴安装试配指南。三帽均已同步为KS-9版本：3.3mm深、1.4mm基准臂宽、4.8mm削平段。最薄壁属于细喷嘴试验特征，若漏线或裂纹即停止，不打印全套。
