Cailynoo7/CalcKey/product/switch-fit-guide.md

> 用户已选择跳过打印试配；本文保留为可选历史资料。正式制作以production说明与正式整机模型为准。

# 机械轴安装孔、卡扣与打印键帽联合试配

只需70×60×3mm的PLA六孔试片和已有P0/P5/P10三只PETG键帽。正式主壳和20个键帽的尺寸未改，本次没有打印、烧录或通电。试片的浅凹刻标出孔号/孔宽和T台阶厚度，T不是3mm总板厚；正面为装轴肩面和测量高度的基准，背面为16.4mm方形避空。

| 孔号 | 方孔宽/深mm | T夹持厚mm | 用途 |
| --- | --- | --- | --- |
| A | 14.0 | 1.50 | 开孔偏小试样 |
| B | 14.1 | 1.50 | 开孔中间试样 |
| C | 14.2 | 1.50 | 完整复现当前主壳轴孔接口 |
| D | 14.3 | 1.50 | 开孔偏大试样 |
| E | 14.2 | 1.35 | 同孔宽、较薄夹持台阶 |
| F | 14.2 | 1.65 | 同孔宽、较厚夹持台阶 |

这些数值是自主试配变量，不是佳达隆制造公差。已取得KS-9H10B045NN-X14-FB官方STEP并装入整机；试片本身不含轴体。现货仍须比对完整料号与CAD后缀。

## 先制作小样

试片：PLA、0.4mm喷嘴、0.15mm层高，首层默认也0.15mm、4道外壁、100%填充、100%比例；刻字/装轴正面朝下贴板，16.4mm避空朝上。让孔口打印方向、材料和补偿与未来主壳一致，不在功能孔、薄台阶内生成支撑。试片实心只为便于重复试配，不等于整壳刚度或强度已经验证。记录打印机、材料和所有孔扩张/象脚补偿，不能用不同补偿制造通过。

三只键帽按原工艺单独制作：PETG、0.2mm喷嘴、0.1mm层高，平顶朝下、十字孔向上；不要把两种喷嘴/材料混为同一套工艺。P0、P5、P10十字孔长/臂宽分别4.10/1.40、4.15/1.45、4.20/1.50mm，深度均3.3mm。

## 先校准轴孔和卡扣

1. 冷却后看刻字、孔口、背面台阶，测孔宽X/Y、3mm总厚及实际T厚。T是在孔边窄台阶测，不是把卡尺夹在板外缘。去毛刺前后分别记录，不一开始就扩孔或削卡扣。
2. 用未焊接、未接电的实物轴。手持外缘或把试片两端架起，背面暂留至少12mm净空，不让定位柱/电触点顶桌面；12mm是工装默认，仍以实际轴底外廓为准。
3. 先D，再C/B/A逐渐收紧；按轴体外壳肩面，保持轴线与孔垂直，不通过压轴芯强顶。明显过紧、卡扣不能释放或板有裂纹时停止该孔。检查肩面坐平、各原轴卡扣在背面回弹、摇晃及轻微拔出保持，结果填六孔记录。
4. E/F只比较同一个14.2mm孔的夹持厚度。先保持同一只轴及相同方向，避免把不同轴体个体差异当成孔尺寸差异。取出时先在背面释放原轴各卡扣，再沿轴线退出，避免硬拔。

## 再校准键帽

1. 在已合适的孔里托住实际轴体，沿轴线轻试P0/P5/P10；过紧就停止，不扭压、不涂胶补救。
2. 量静止时帽底到装轴正面的高度，再量按到底的间距，确认名义4mm行程及回弹，观察帽裙和插座是否碰轴体上盖或试片。当前KS-9模型名义静止间距5.5mm、到底1.5mm，仍只是实物对照值，不能据此强压键帽到某高度。
3. 拔帽时托住轴体，检查卡扣是否仍保持、插座有无裂纹，少量重复插拔并记录。轴夹持与帽松紧分开判断；若帽太紧把轴拔出，不能直接断言面板孔不合适。
4. 配对表提供6孔×3帽共18行。无需在明显不适合的孔中强行做全组合，可写不适用与原因。至少完成选定合理孔的三帽对比，并在原三帽记录表保留工艺结果。
5. 确定孔宽、T台阶、帽孔和实际高度后，再据测值修改正式主壳与共享键帽参数。不仅因试片能卡住就批量打印整套。

## 数字模型已检查的范围

六处上层开孔分别14.0/14.1/14.2/14.3/14.2/14.2mm，下层均16.4mm；六处夹持T为1.50/1.50/1.50/1.50/1.35/1.65mm，已用几何切片及小截面实体交集量取。板为一个有效连续实体；最小孔间实体6.6mm，文字下剩2.7mm。原试片几何尺寸验证保持有效；正式KS-9键帽名义到底间隙为1.5mm，整机的20帽已用官方轴体检查，详见KS-9装配核对。卡扣弹性、保持力、打印收缩和就位高度均待实物测量。

六孔和联合配对实测表均待测。主壳与既有三帽CAD保持不变；不以近似轴体图或没有物理测量的“无碰撞”替代实配。
