Cailynoo7/CalcKey/product/final-assembly/unpowered-checklist.csv

编号 | 阶段 | 项目 | 红表笔 | 黑表笔 | 档位或方法 | 前置条件 | 判据 | 来源 | 实测或观察 | 结果 | 异常与处理 | 复查结果 | 操作者 | 日期
A01 | 00 版本与准备 | 主壳/底盖版本 |  |  | 目视并对照导出 | 仅核对资料或已有实物，不启动打印 | 主壳前内壁2桥、底盖3桥；采用18faaed5/export-fa411383a0f6c23d36fed4b6df68eda5，STEP/STL与完整包按当前清单取用 | design/enclosure/README.md; product/harness-routing.md |  | 待测
A02 | 00 版本与准备 | 外部电源全部断开 |  |  | 目视线缆 | 任何电阻/通断/二极管测量之前 | USB、充电器、调试器等均断开；若曾供电先测残余电压，不短接电容 | design/enclosure/README.md; product/harness-routing.md |  | 待测
A03 | 00 版本与准备 | 表笔插孔与表线基准 |  |  | 电阻档短接/分开表笔 | 红V/Ω、黑COM，待测电路无残余电压 | 记录表线基准Ω与分开OL，不用电流档 | design/enclosure/README.md; product/harness-routing.md |  | 待测
A04 | 00 版本与准备 | 30件及机构备件 |  |  | 点数/目视 | 已取得实物时；不在本次打印 | 30个打印件、单独保护片、两D12×2前垫、两后脚/短轴/盲帽齐全，孔内无残丝碎屑 | design/enclosure/README.md; product/harness-routing.md |  | 待测
A05 | 00 版本与准备 | 八颗紧固螺钉 |  |  | 点数与长度核对 | 安装前 | 4颗ISO7380-1 M3×8合盖；4颗ISO4762 M2×6固定两只主控压桥，旧OLED螺钉不混用 | design/enclosure/README.md; product/harness-routing.md |  | 待测
A06 | 00 版本与准备 | LCD与轴体识别 |  |  | 看型号/版本/P1 | 用户已确认KS-9对应关系；到货复核不改变选型 | LCD为GDM0103 3.3V/6点钟，认P1；轴为既定KS-9H10B045NN-X14三脚红轴 | design/enclosure/README.md; product/harness-routing.md |  | 待测
A07 | 00 版本与准备 | 15根软线及胶带 |  |  | 点数/量尺寸 | 未裁短末端 | 10矩阵+5LCD、26AWG柔性线外径≤1.3mm、每根总长默认150mm；胶带10mm宽/总厚≤0.1mm | design/enclosure/README.md; product/harness-routing.md |  | 待测
B01 | 10 独立矩阵 | 四只上拉装配 |  |  | 目视/核型号 | 主控/LCD未接矩阵，所有键松开 | R1～R4为10kΩ±1%/0805、坐平无锡桥；按图核位置 | product/matrix-assembly-diagrams/guided-soldering.md |  | 待测
B02 | 10 独立矩阵 | 二十只二极管方向 |  |  | 目视/核K | 屏幕端朝上看PCB底面 | 20只1N4148-TAP底面卧装，黑环K左侧对方形pad1，无玻璃裂纹，正面剪脚不顶轴 | product/matrix-assembly-diagrams/guided-soldering.md |  | 待测
B03 | 10 独立矩阵 | 20轴与40处触点 |  |  | 目视/轻按 | 键帽未装、主控/LCD未接 | 20轴坐平且PCB不翘，40个金属触点焊好；20个中心塑料柱NPTH孔未焊 | product/matrix-assembly-diagrams/guided-soldering.md |  | 待测
B04 | 10 独立矩阵 | 被动矩阵焊后清理 |  |  | 放大目视 | 焊点冷却 | 无散股、锡桥、金属屑或虚焊；不做旧版跨键并线 | product/matrix-assembly-diagrams/guided-soldering.md |  | 待测
E01 | 10 独立矩阵 | COL0上拉 | J6 | J10 | 电阻档 | 主控/LCD未连接 | 约10kΩ | product/matrix-assembly-diagrams/unpowered-check-record.csv：数据行1 |  | 待测
E02 | 10 独立矩阵 | COL1上拉 | J7 | J10 | 电阻档 | 主控/LCD未连接 | 约10kΩ | product/matrix-assembly-diagrams/unpowered-check-record.csv：数据行2 |  | 待测
E03 | 10 独立矩阵 | COL2上拉 | J8 | J10 | 电阻档 | 主控/LCD未连接 | 约10kΩ | product/matrix-assembly-diagrams/unpowered-check-record.csv：数据行3 |  | 待测
E04 | 10 独立矩阵 | COL3上拉 | J9 | J10 | 电阻档 | 主控/LCD未连接 | 约10kΩ | product/matrix-assembly-diagrams/unpowered-check-record.csv：数据行4 |  | 待测
E05 | 10 独立矩阵 | SW1/D1 | J6 | J1 | 二极管档 | 对应按键按下；主控/LCD未连接 | 二极管正向压降 | product/matrix-assembly-diagrams/unpowered-check-record.csv：数据行5 |  | 待测
E06 | 10 独立矩阵 | SW1/D1 | J1 | J6 | 二极管档 | 对应按键按下；主控/LCD未连接 | 截止 | product/matrix-assembly-diagrams/unpowered-check-record.csv：数据行6 |  | 待测
R01 | 10 独立矩阵 | SW1 Num 松开与释放 | J6 | J1 | 二极管档，记起始松开/测后释放两个读数 | 主控/LCD未连接；其他19键松开；正反测后恢复红列黑行再释放 | 起始松开OL；测后释放也为OL | product/matrix-assembly-diagrams/guided-soldering.md |  | 待测
E07 | 10 独立矩阵 | SW2/D2 | J7 | J1 | 二极管档 | 对应按键按下；主控/LCD未连接 | 二极管正向压降 | product/matrix-assembly-diagrams/unpowered-check-record.csv：数据行7 |  | 待测
E08 | 10 独立矩阵 | SW2/D2 | J1 | J7 | 二极管档 | 对应按键按下；主控/LCD未连接 | 截止 | product/matrix-assembly-diagrams/unpowered-check-record.csv：数据行8 |  | 待测
R02 | 10 独立矩阵 | SW2 ÷ 松开与释放 | J7 | J1 | 二极管档，记起始松开/测后释放两个读数 | 主控/LCD未连接；其他19键松开；正反测后恢复红列黑行再释放 | 起始松开OL；测后释放也为OL | product/matrix-assembly-diagrams/guided-soldering.md |  | 待测
E09 | 10 独立矩阵 | SW3/D3 | J8 | J1 | 二极管档 | 对应按键按下；主控/LCD未连接 | 二极管正向压降 | product/matrix-assembly-diagrams/unpowered-check-record.csv：数据行9 |  | 待测
E10 | 10 独立矩阵 | SW3/D3 | J1 | J8 | 二极管档 | 对应按键按下；主控/LCD未连接 | 截止 | product/matrix-assembly-diagrams/unpowered-check-record.csv：数据行10 |  | 待测
R03 | 10 独立矩阵 | SW3 × 松开与释放 | J8 | J1 | 二极管档，记起始松开/测后释放两个读数 | 主控/LCD未连接；其他19键松开；正反测后恢复红列黑行再释放 | 起始松开OL；测后释放也为OL | product/matrix-assembly-diagrams/guided-soldering.md |  | 待测
E11 | 10 独立矩阵 | SW4/D4 | J9 | J1 | 二极管档 | 对应按键按下；主控/LCD未连接 | 二极管正向压降 | product/matrix-assembly-diagrams/unpowered-check-record.csv：数据行11 |  | 待测
E12 | 10 独立矩阵 | SW4/D4 | J1 | J9 | 二极管档 | 对应按键按下；主控/LCD未连接 | 截止 | product/matrix-assembly-diagrams/unpowered-check-record.csv：数据行12 |  | 待测
R04 | 10 独立矩阵 | SW4 Bk 松开与释放 | J9 | J1 | 二极管档，记起始松开/测后释放两个读数 | 主控/LCD未连接；其他19键松开；正反测后恢复红列黑行再释放 | 起始松开OL；测后释放也为OL | product/matrix-assembly-diagrams/guided-soldering.md |  | 待测
E13 | 10 独立矩阵 | SW5/D5 | J6 | J2 | 二极管档 | 对应按键按下；主控/LCD未连接 | 二极管正向压降 | product/matrix-assembly-diagrams/unpowered-check-record.csv：数据行13 |  | 待测
E14 | 10 独立矩阵 | SW5/D5 | J2 | J6 | 二极管档 | 对应按键按下；主控/LCD未连接 | 截止 | product/matrix-assembly-diagrams/unpowered-check-record.csv：数据行14 |  | 待测
R05 | 10 独立矩阵 | SW5 7 松开与释放 | J6 | J2 | 二极管档，记起始松开/测后释放两个读数 | 主控/LCD未连接；其他19键松开；正反测后恢复红列黑行再释放 | 起始松开OL；测后释放也为OL | product/matrix-assembly-diagrams/guided-soldering.md |  | 待测
E15 | 10 独立矩阵 | SW6/D6 | J7 | J2 | 二极管档 | 对应按键按下；主控/LCD未连接 | 二极管正向压降 | product/matrix-assembly-diagrams/unpowered-check-record.csv：数据行15 |  | 待测
E16 | 10 独立矩阵 | SW6/D6 | J2 | J7 | 二极管档 | 对应按键按下；主控/LCD未连接 | 截止 | product/matrix-assembly-diagrams/unpowered-check-record.csv：数据行16 |  | 待测
R06 | 10 独立矩阵 | SW6 8 松开与释放 | J7 | J2 | 二极管档，记起始松开/测后释放两个读数 | 主控/LCD未连接；其他19键松开；正反测后恢复红列黑行再释放 | 起始松开OL；测后释放也为OL | product/matrix-assembly-diagrams/guided-soldering.md |  | 待测
E17 | 10 独立矩阵 | SW7/D7 | J8 | J2 | 二极管档 | 对应按键按下；主控/LCD未连接 | 二极管正向压降 | product/matrix-assembly-diagrams/unpowered-check-record.csv：数据行17 |  | 待测
E18 | 10 独立矩阵 | SW7/D7 | J2 | J8 | 二极管档 | 对应按键按下；主控/LCD未连接 | 截止 | product/matrix-assembly-diagrams/unpowered-check-record.csv：数据行18 |  | 待测
R07 | 10 独立矩阵 | SW7 9 松开与释放 | J8 | J2 | 二极管档，记起始松开/测后释放两个读数 | 主控/LCD未连接；其他19键松开；正反测后恢复红列黑行再释放 | 起始松开OL；测后释放也为OL | product/matrix-assembly-diagrams/guided-soldering.md |  | 待测
E19 | 10 独立矩阵 | SW8/D8 | J9 | J2 | 二极管档 | 对应按键按下；主控/LCD未连接 | 二极管正向压降 | product/matrix-assembly-diagrams/unpowered-check-record.csv：数据行19 |  | 待测
E20 | 10 独立矩阵 | SW8/D8 | J2 | J9 | 二极管档 | 对应按键按下；主控/LCD未连接 | 截止 | product/matrix-assembly-diagrams/unpowered-check-record.csv：数据行20 |  | 待测
R08 | 10 独立矩阵 | SW8 − 松开与释放 | J9 | J2 | 二极管档，记起始松开/测后释放两个读数 | 主控/LCD未连接；其他19键松开；正反测后恢复红列黑行再释放 | 起始松开OL；测后释放也为OL | product/matrix-assembly-diagrams/guided-soldering.md |  | 待测
E21 | 10 独立矩阵 | SW9/D9 | J6 | J3 | 二极管档 | 对应按键按下；主控/LCD未连接 | 二极管正向压降 | product/matrix-assembly-diagrams/unpowered-check-record.csv：数据行21 |  | 待测
E22 | 10 独立矩阵 | SW9/D9 | J3 | J6 | 二极管档 | 对应按键按下；主控/LCD未连接 | 截止 | product/matrix-assembly-diagrams/unpowered-check-record.csv：数据行22 |  | 待测
R09 | 10 独立矩阵 | SW9 4 松开与释放 | J6 | J3 | 二极管档，记起始松开/测后释放两个读数 | 主控/LCD未连接；其他19键松开；正反测后恢复红列黑行再释放 | 起始松开OL；测后释放也为OL | product/matrix-assembly-diagrams/guided-soldering.md |  | 待测
E23 | 10 独立矩阵 | SW10/D10 | J7 | J3 | 二极管档 | 对应按键按下；主控/LCD未连接 | 二极管正向压降 | product/matrix-assembly-diagrams/unpowered-check-record.csv：数据行23 |  | 待测
E24 | 10 独立矩阵 | SW10/D10 | J3 | J7 | 二极管档 | 对应按键按下；主控/LCD未连接 | 截止 | product/matrix-assembly-diagrams/unpowered-check-record.csv：数据行24 |  | 待测
R10 | 10 独立矩阵 | SW10 5 松开与释放 | J7 | J3 | 二极管档，记起始松开/测后释放两个读数 | 主控/LCD未连接；其他19键松开；正反测后恢复红列黑行再释放 | 起始松开OL；测后释放也为OL | product/matrix-assembly-diagrams/guided-soldering.md |  | 待测
E25 | 10 独立矩阵 | SW11/D11 | J8 | J3 | 二极管档 | 对应按键按下；主控/LCD未连接 | 二极管正向压降 | product/matrix-assembly-diagrams/unpowered-check-record.csv：数据行25 |  | 待测
E26 | 10 独立矩阵 | SW11/D11 | J3 | J8 | 二极管档 | 对应按键按下；主控/LCD未连接 | 截止 | product/matrix-assembly-diagrams/unpowered-check-record.csv：数据行26 |  | 待测
R11 | 10 独立矩阵 | SW11 6 松开与释放 | J8 | J3 | 二极管档，记起始松开/测后释放两个读数 | 主控/LCD未连接；其他19键松开；正反测后恢复红列黑行再释放 | 起始松开OL；测后释放也为OL | product/matrix-assembly-diagrams/guided-soldering.md |  | 待测
E27 | 10 独立矩阵 | SW12/D12 | J9 | J3 | 二极管档 | 对应按键按下；主控/LCD未连接 | 二极管正向压降 | product/matrix-assembly-diagrams/unpowered-check-record.csv：数据行27 |  | 待测
E28 | 10 独立矩阵 | SW12/D12 | J3 | J9 | 二极管档 | 对应按键按下；主控/LCD未连接 | 截止 | product/matrix-assembly-diagrams/unpowered-check-record.csv：数据行28 |  | 待测
R12 | 10 独立矩阵 | SW12 + 松开与释放 | J9 | J3 | 二极管档，记起始松开/测后释放两个读数 | 主控/LCD未连接；其他19键松开；正反测后恢复红列黑行再释放 | 起始松开OL；测后释放也为OL | product/matrix-assembly-diagrams/guided-soldering.md |  | 待测
E29 | 10 独立矩阵 | SW13/D13 | J6 | J4 | 二极管档 | 对应按键按下；主控/LCD未连接 | 二极管正向压降 | product/matrix-assembly-diagrams/unpowered-check-record.csv：数据行29 |  | 待测
E30 | 10 独立矩阵 | SW13/D13 | J4 | J6 | 二极管档 | 对应按键按下；主控/LCD未连接 | 截止 | product/matrix-assembly-diagrams/unpowered-check-record.csv：数据行30 |  | 待测
R13 | 10 独立矩阵 | SW13 1 松开与释放 | J6 | J4 | 二极管档，记起始松开/测后释放两个读数 | 主控/LCD未连接；其他19键松开；正反测后恢复红列黑行再释放 | 起始松开OL；测后释放也为OL | product/matrix-assembly-diagrams/guided-soldering.md |  | 待测
E31 | 10 独立矩阵 | SW14/D14 | J7 | J4 | 二极管档 | 对应按键按下；主控/LCD未连接 | 二极管正向压降 | product/matrix-assembly-diagrams/unpowered-check-record.csv：数据行31 |  | 待测
E32 | 10 独立矩阵 | SW14/D14 | J4 | J7 | 二极管档 | 对应按键按下；主控/LCD未连接 | 截止 | product/matrix-assembly-diagrams/unpowered-check-record.csv：数据行32 |  | 待测
R14 | 10 独立矩阵 | SW14 2 松开与释放 | J7 | J4 | 二极管档，记起始松开/测后释放两个读数 | 主控/LCD未连接；其他19键松开；正反测后恢复红列黑行再释放 | 起始松开OL；测后释放也为OL | product/matrix-assembly-diagrams/guided-soldering.md |  | 待测
E33 | 10 独立矩阵 | SW15/D15 | J8 | J4 | 二极管档 | 对应按键按下；主控/LCD未连接 | 二极管正向压降 | product/matrix-assembly-diagrams/unpowered-check-record.csv：数据行33 |  | 待测
E34 | 10 独立矩阵 | SW15/D15 | J4 | J8 | 二极管档 | 对应按键按下；主控/LCD未连接 | 截止 | product/matrix-assembly-diagrams/unpowered-check-record.csv：数据行34 |  | 待测
R15 | 10 独立矩阵 | SW15 3 松开与释放 | J8 | J4 | 二极管档，记起始松开/测后释放两个读数 | 主控/LCD未连接；其他19键松开；正反测后恢复红列黑行再释放 | 起始松开OL；测后释放也为OL | product/matrix-assembly-diagrams/guided-soldering.md |  | 待测
E35 | 10 独立矩阵 | SW16/D16 | J9 | J4 | 二极管档 | 对应按键按下；主控/LCD未连接 | 二极管正向压降 | product/matrix-assembly-diagrams/unpowered-check-record.csv：数据行35 |  | 待测
E36 | 10 独立矩阵 | SW16/D16 | J4 | J9 | 二极管档 | 对应按键按下；主控/LCD未连接 | 截止 | product/matrix-assembly-diagrams/unpowered-check-record.csv：数据行36 |  | 待测
R16 | 10 独立矩阵 | SW16 Enter/= 松开与释放 | J9 | J4 | 二极管档，记起始松开/测后释放两个读数 | 主控/LCD未连接；其他19键松开；正反测后恢复红列黑行再释放 | 起始松开OL；测后释放也为OL | product/matrix-assembly-diagrams/guided-soldering.md |  | 待测
E37 | 10 独立矩阵 | SW17/D17 | J6 | J5 | 二极管档 | 对应按键按下；主控/LCD未连接 | 二极管正向压降 | product/matrix-assembly-diagrams/unpowered-check-record.csv：数据行37 |  | 待测
E38 | 10 独立矩阵 | SW17/D17 | J5 | J6 | 二极管档 | 对应按键按下；主控/LCD未连接 | 截止 | product/matrix-assembly-diagrams/unpowered-check-record.csv：数据行38 |  | 待测
R17 | 10 独立矩阵 | SW17 Mode 松开与释放 | J6 | J5 | 二极管档，记起始松开/测后释放两个读数 | 主控/LCD未连接；其他19键松开；正反测后恢复红列黑行再释放 | 起始松开OL；测后释放也为OL | product/matrix-assembly-diagrams/guided-soldering.md |  | 待测
E39 | 10 独立矩阵 | SW18/D18 | J7 | J5 | 二极管档 | 对应按键按下；主控/LCD未连接 | 二极管正向压降 | product/matrix-assembly-diagrams/unpowered-check-record.csv：数据行39 |  | 待测
E40 | 10 独立矩阵 | SW18/D18 | J5 | J7 | 二极管档 | 对应按键按下；主控/LCD未连接 | 截止 | product/matrix-assembly-diagrams/unpowered-check-record.csv：数据行40 |  | 待测
R18 | 10 独立矩阵 | SW18 0 松开与释放 | J7 | J5 | 二极管档，记起始松开/测后释放两个读数 | 主控/LCD未连接；其他19键松开；正反测后恢复红列黑行再释放 | 起始松开OL；测后释放也为OL | product/matrix-assembly-diagrams/guided-soldering.md |  | 待测
E41 | 10 独立矩阵 | SW19/D19 | J8 | J5 | 二极管档 | 对应按键按下；主控/LCD未连接 | 二极管正向压降 | product/matrix-assembly-diagrams/unpowered-check-record.csv：数据行41 |  | 待测
E42 | 10 独立矩阵 | SW19/D19 | J5 | J8 | 二极管档 | 对应按键按下；主控/LCD未连接 | 截止 | product/matrix-assembly-diagrams/unpowered-check-record.csv：数据行42 |  | 待测
R19 | 10 独立矩阵 | SW19 . 松开与释放 | J8 | J5 | 二极管档，记起始松开/测后释放两个读数 | 主控/LCD未连接；其他19键松开；正反测后恢复红列黑行再释放 | 起始松开OL；测后释放也为OL | product/matrix-assembly-diagrams/guided-soldering.md |  | 待测
E43 | 10 独立矩阵 | SW20/D20 | J9 | J5 | 二极管档 | 对应按键按下；主控/LCD未连接 | 二极管正向压降 | product/matrix-assembly-diagrams/unpowered-check-record.csv：数据行43 |  | 待测
E44 | 10 独立矩阵 | SW20/D20 | J5 | J9 | 二极管档 | 对应按键按下；主控/LCD未连接 | 截止 | product/matrix-assembly-diagrams/unpowered-check-record.csv：数据行44 |  | 待测
R20 | 10 独立矩阵 | SW20 AC 松开与释放 | J9 | J5 | 二极管档，记起始松开/测后释放两个读数 | 主控/LCD未连接；其他19键松开；正反测后恢复红列黑行再释放 | 起始松开OL；测后释放也为OL | product/matrix-assembly-diagrams/guided-soldering.md |  | 待测
C01 | 20 软线焊装 | 15根导线标签与PCB首段 |  |  | 目视/逐根对照 | 主控焊端前，板已支撑 | J1～J10及LCD P1～P5两端标号一致；J线朝板内低位直焊，无排针 | product/matrix-assembly-diagrams/guided-soldering.md |  | 待测
C02 | 20 软线焊装 | LCD未使用端绝缘 |  |  | 逐端目视 | 不增加背光或/INT连线 | P6～P9各自绝缘，不接外部线、不互短；不把内部任意两NC必须OL作判据 | product/matrix-assembly-diagrams/guided-soldering.md |  | 待测
C03 | 20 软线焊装 | LCD板背低位引线 |  |  | 目视/量突出量 | 胶粘安装前，玻璃不受压 | 焊点与首段线突出≤1.5mm，朝内，边缘托架承托带不被导线占用 | product/matrix-assembly-diagrams/guided-soldering.md |  | 待测
C04 | 20 软线焊装 | 主控物理36共享节点 |  |  | 目视端点/编号 | 主控按官方方向识别物理编号 | J10与LCD P5同到3V3 OUT/36；LCD P4到GND/38；35/37无意外锡桥 | product/matrix-assembly-diagrams/guided-soldering.md |  | 待测
C05 | 20 软线焊装 | 矩阵行与电源接法 |  |  | 逐端目视标签 | 不拿芯片内阻猜针脚 | 矩阵无GND端子；J1～J5不接地；J10不接VBUS、VSYS、3V3_EN或5V | product/matrix-assembly-diagrams/guided-soldering.md |  | 待测
E45 | 20 软线焊装 | J1导线 | J1 | 主控物理4 | 电阻/通断档，记录实际读数 | 断电 | 端到端通断 | product/matrix-assembly-diagrams/unpowered-check-record.csv：数据行45 |  | 待测
E46 | 20 软线焊装 | J2导线 | J2 | 主控物理5 | 电阻/通断档，记录实际读数 | 断电 | 端到端通断 | product/matrix-assembly-diagrams/unpowered-check-record.csv：数据行46 |  | 待测
E47 | 20 软线焊装 | J3导线 | J3 | 主控物理6 | 电阻/通断档，记录实际读数 | 断电 | 端到端通断 | product/matrix-assembly-diagrams/unpowered-check-record.csv：数据行47 |  | 待测
E48 | 20 软线焊装 | J4导线 | J4 | 主控物理7 | 电阻/通断档，记录实际读数 | 断电 | 端到端通断 | product/matrix-assembly-diagrams/unpowered-check-record.csv：数据行48 |  | 待测
E49 | 20 软线焊装 | J5导线 | J5 | 主控物理9 | 电阻/通断档，记录实际读数 | 断电 | 端到端通断 | product/matrix-assembly-diagrams/unpowered-check-record.csv：数据行49 |  | 待测
E50 | 20 软线焊装 | J6导线 | J6 | 主控物理10 | 电阻/通断档，记录实际读数 | 断电 | 端到端通断 | product/matrix-assembly-diagrams/unpowered-check-record.csv：数据行50 |  | 待测
E51 | 20 软线焊装 | J7导线 | J7 | 主控物理11 | 电阻/通断档，记录实际读数 | 断电 | 端到端通断 | product/matrix-assembly-diagrams/unpowered-check-record.csv：数据行51 |  | 待测
E52 | 20 软线焊装 | J8导线 | J8 | 主控物理12 | 电阻/通断档，记录实际读数 | 断电 | 端到端通断 | product/matrix-assembly-diagrams/unpowered-check-record.csv：数据行52 |  | 待测
E53 | 20 软线焊装 | J9导线 | J9 | 主控物理14 | 电阻/通断档，记录实际读数 | 断电 | 端到端通断 | product/matrix-assembly-diagrams/unpowered-check-record.csv：数据行53 |  | 待测
E54 | 20 软线焊装 | J10导线 | J10 | 主控物理36 | 电阻/通断档，记录实际读数 | 断电 | 端到端通断 | product/matrix-assembly-diagrams/unpowered-check-record.csv：数据行54 |  | 待测
E55 | 20 软线焊装 | LCD P1导线 | LCD P1 | 主控物理15 | 电阻/通断档，记录实际读数 | 断电 | 端到端通断 | product/matrix-assembly-diagrams/unpowered-check-record.csv：数据行55 |  | 待测
E56 | 20 软线焊装 | LCD P2导线 | LCD P2 | 主控物理2 | 电阻/通断档，记录实际读数 | 断电 | 端到端通断 | product/matrix-assembly-diagrams/unpowered-check-record.csv：数据行56 |  | 待测
E57 | 20 软线焊装 | LCD P3导线 | LCD P3 | 主控物理1 | 电阻/通断档，记录实际读数 | 断电 | 端到端通断 | product/matrix-assembly-diagrams/unpowered-check-record.csv：数据行57 |  | 待测
E58 | 20 软线焊装 | LCD P4导线 | LCD P4 | 主控物理38 | 电阻/通断档，记录实际读数 | 断电 | 端到端通断 | product/matrix-assembly-diagrams/unpowered-check-record.csv：数据行58 |  | 待测
E59 | 20 软线焊装 | LCD P5导线 | LCD P5 | 主控物理36 | 电阻/通断档，记录实际读数 | 断电 | 端到端通断 | product/matrix-assembly-diagrams/unpowered-check-record.csv：数据行59 |  | 待测
D01 | 30 机械安装 | 翻脚、短轴及盲帽 |  |  | 干装/观察胶接/轻翻 | 两壳有支撑；胶材按要求固化 | 17.8mm短轴、Ø5×2.4盲帽，入帽约1mm；胶仅轴端，转动面不粘；0/110°两档限位可达 | design/enclosure/README.md |  | 待测
D02 | 30 机械安装 | 主控压桥固定 |  |  | 目视/轻拧 | 既有线束松放，不靠线悬吊 | Type-C向右；两只压桥、4颗M2×6、8片6×1.4×0.15mm绝缘垫；螺钉不穿板，不压芯片或弯板；板载电池座不接 | design/enclosure/README.md |  | 待测
D03 | 30 机械安装 | LCD四处边缘固定 |  |  | 实物承托带检查/轻压PCB | 先焊线与绝缘、后粘接；不压玻璃 | 四片2×4×0.15mm绝缘胶片；边缘无铜/元件/导线干涉，背面凸起不顶托架 | design/enclosure/README.md |  | 待测
D04 | 30 机械安装 | 保护片与胶框 |  |  | 目视/干合盖 | 67.6×19.6×1mm保护片，0.15mm周边胶框 | 64×16mm窗口清洁、无溢胶遮挡，LCD玻璃不顶保护片或受周边挤压 | design/enclosure/README.md |  | 待测
F01 | 40 固定与余量 | 五处穿带孔可用 |  |  | 穿带/目视 | 新版本实物已备，线束不拉紧 | 5个10.6×2mm孔通畅，不以拉扯焊线穿带 | product/harness-routing.md |  | 待测
F02 | 40 固定与余量 | 主壳前两桥分组 |  |  | 核对局部坐标与标签 | 键面朝上、屏幕远端作为左右基准 | (-17,-55.7)固定J1～J5；(17,-55.7)固定J6～J10，每组5线，夹持线皮 | product/harness-routing.md |  | 待测
F03 | 40 固定与余量 | 底盖前中汇线桥 |  |  | 目视并排宽度 | 中心(0,-29)，桥顶z6mm | 10线单层、宽≤13mm，含胶带高度≤1.5mm，无圆束堆高 | product/harness-routing.md |  | 待测
F04 | 40 固定与余量 | LCD底盖后中桥 |  |  | 沿五线追踪固定点 | 中心(0,23)，桥顶z6mm | P1～P5仅固定到底盖、不绑主壳或矩阵，5线宽≤6.5mm，含胶带高≤1.5mm | product/harness-routing.md |  | 待测
F05 | 40 固定与余量 | 左侧辅助桥（可选） |  |  | 检查可达余线 | 中心(-26,2)；余段自然可达才使用 | 不强迫绕远或拉紧；不用时可填不适用并写原因 | product/harness-routing.md |  | 待测
F06 | 40 固定与余量 | 矩阵左右折返区 |  |  | 目视/量堆高 | 各5根线，未把自由段粘到底板 | 左区(-26,-36.7,4.55)/20×21.4×3；右区(26,-39,4.55)/20×16.8×3mm；松弛S形，内弯半径默认≥5mm | product/harness-routing.md |  | 待测
F07 | 40 固定与余量 | LCD余线区 |  |  | 目视/量堆高 | 只收自然可达余线，不硬塞全线 | 中心(-26,-15.5,4.55)，20×18×3mm；无圆线团、无托架夹线 | product/harness-routing.md |  | 待测
F08 | 40 固定与余量 | 主控分散出线与压桥间通道 |  |  | 侧视/干合盖观察 | 桥间电源线区5×23×1.5mm中心(18.9,-9.5,10.05)；信号前缘分散 | 只有三根电源线穿桥间，不挤入15线；前缘分散区45×1.5×1.5mm、中心(17,-21.7,7.1)，避开元件和夹持区 | product/harness-routing.md |  | 待测
F09 | 40 固定与余量 | 胶带长度与搭接 |  |  | 量宽/搭接与松紧 | 默认5条10×65mm、总厚≤0.1mm | 穿桥后包住线皮，尾搭≥15mm；不勒凹线皮，不粘住跨壳自由段 | product/harness-routing.md |  | 待测
F10 | 40 固定与余量 | 独立绝缘与带尾 |  |  | 放大目视 | 所有焊点冷却且绝缘完毕 | 裸铜/引脚独立绝缘；固定胶带不代替热缩管，不贴玻璃，带尾不入柱/唇/轴脚/翻脚 | product/harness-routing.md |  | 待测
F11 | 40 固定与余量 | 自由段长度定义 |  |  | 逐根沿线量弧长 | 参照S01～S10记录，不以两桥直线距离替代 | 150mm为每根总长；不足时延长并记实际长度，不缩减65mm维护段 | product/harness-routing.md |  | 待测
S01 | 40 固定与余量 | J1 跨壳自由长度 |  |  | 沿线量弧长；记自由长度mm、总线长mm及弯曲观察 | 主壳前左桥夹持区至底盖前中桥夹持区；该线未被中途粘死 | 自由长度≥65mm；总长默认150mm；松弛折返且单根内弯半径默认≥5mm；30mm开盖另在M项实物观察 | product/harness-routing.md |  | 待测
S02 | 40 固定与余量 | J2 跨壳自由长度 |  |  | 沿线量弧长；记自由长度mm、总线长mm及弯曲观察 | 主壳前左桥夹持区至底盖前中桥夹持区；该线未被中途粘死 | 自由长度≥65mm；总长默认150mm；松弛折返且单根内弯半径默认≥5mm；30mm开盖另在M项实物观察 | product/harness-routing.md |  | 待测
S03 | 40 固定与余量 | J3 跨壳自由长度 |  |  | 沿线量弧长；记自由长度mm、总线长mm及弯曲观察 | 主壳前左桥夹持区至底盖前中桥夹持区；该线未被中途粘死 | 自由长度≥65mm；总长默认150mm；松弛折返且单根内弯半径默认≥5mm；30mm开盖另在M项实物观察 | product/harness-routing.md |  | 待测
S04 | 40 固定与余量 | J4 跨壳自由长度 |  |  | 沿线量弧长；记自由长度mm、总线长mm及弯曲观察 | 主壳前左桥夹持区至底盖前中桥夹持区；该线未被中途粘死 | 自由长度≥65mm；总长默认150mm；松弛折返且单根内弯半径默认≥5mm；30mm开盖另在M项实物观察 | product/harness-routing.md |  | 待测
S05 | 40 固定与余量 | J5 跨壳自由长度 |  |  | 沿线量弧长；记自由长度mm、总线长mm及弯曲观察 | 主壳前左桥夹持区至底盖前中桥夹持区；该线未被中途粘死 | 自由长度≥65mm；总长默认150mm；松弛折返且单根内弯半径默认≥5mm；30mm开盖另在M项实物观察 | product/harness-routing.md |  | 待测
S06 | 40 固定与余量 | J6 跨壳自由长度 |  |  | 沿线量弧长；记自由长度mm、总线长mm及弯曲观察 | 主壳前右桥夹持区至底盖前中桥夹持区；该线未被中途粘死 | 自由长度≥65mm；总长默认150mm；松弛折返且单根内弯半径默认≥5mm；30mm开盖另在M项实物观察 | product/harness-routing.md |  | 待测
S07 | 40 固定与余量 | J7 跨壳自由长度 |  |  | 沿线量弧长；记自由长度mm、总线长mm及弯曲观察 | 主壳前右桥夹持区至底盖前中桥夹持区；该线未被中途粘死 | 自由长度≥65mm；总长默认150mm；松弛折返且单根内弯半径默认≥5mm；30mm开盖另在M项实物观察 | product/harness-routing.md |  | 待测
S08 | 40 固定与余量 | J8 跨壳自由长度 |  |  | 沿线量弧长；记自由长度mm、总线长mm及弯曲观察 | 主壳前右桥夹持区至底盖前中桥夹持区；该线未被中途粘死 | 自由长度≥65mm；总长默认150mm；松弛折返且单根内弯半径默认≥5mm；30mm开盖另在M项实物观察 | product/harness-routing.md |  | 待测
S09 | 40 固定与余量 | J9 跨壳自由长度 |  |  | 沿线量弧长；记自由长度mm、总线长mm及弯曲观察 | 主壳前右桥夹持区至底盖前中桥夹持区；该线未被中途粘死 | 自由长度≥65mm；总长默认150mm；松弛折返且单根内弯半径默认≥5mm；30mm开盖另在M项实物观察 | product/harness-routing.md |  | 待测
S10 | 40 固定与余量 | J10 跨壳自由长度 |  |  | 沿线量弧长；记自由长度mm、总线长mm及弯曲观察 | 主壳前右桥夹持区至底盖前中桥夹持区；该线未被中途粘死 | 自由长度≥65mm；总长默认150mm；松弛折返且单根内弯半径默认≥5mm；30mm开盖另在M项实物观察 | product/harness-routing.md |  | 待测
P01 | 50 合盖前电气 | 无外部供电再确认 |  |  | 目视 | 合盖前电气复测 | USB/充电器/调试器全部断开；曾供电先查残余电压 | product/matrix-assembly-diagrams/guided-soldering.md |  | 待测
P02 | 50 合盖前电气 | J10与LCD P5共享3V3 | J10 | LCD P5 | 电阻/通断档 | 主控已连接，设备无残余电压 | 记录读数，应为同一节点且接近表线基准；到物理36的单线结果另见E项 | product/matrix-assembly-diagrams/guided-soldering.md |  | 待测
P03 | 50 合盖前电气 | 合盖前3V3—GND | 主控物理36 | 主控物理38 | 电阻档，记录正/反接稳定值及变化趋势 | 全程无外部供电，芯片已经接入 | 无固定阻值/必须OL要求；持续近表线基准的低阻须查明，不能以一次不蜂鸣通过 | product/matrix-assembly-diagrams/guided-soldering.md |  | 待测
P04 | 50 合盖前电气 | 相邻焊点和电源区目视 |  |  | 放大目视，重点物理35～38 | 已接芯片，不给所有相邻脚套OL判据 | 无锡桥、裸线散股及残留金属；不确定的读数需记录并定位 | product/matrix-assembly-diagrams/guided-soldering.md |  | 待测
K01 | 60 逐键回弹 | SW1 Num 三阶段机械检查 |  |  | 分别记轴体/装帽开盖/合盖后三段观察 | 全程断电；只按至轴正常止点，不过压凑4mm | 标签与布局一致、坐平、按下和释放不卡壳不蹭邻帽，合盖后仍自然回弹 | design/enclosure/README.md |  | 待测
K02 | 60 逐键回弹 | SW2 ÷ 三阶段机械检查 |  |  | 分别记轴体/装帽开盖/合盖后三段观察 | 全程断电；只按至轴正常止点，不过压凑4mm | 标签与布局一致、坐平、按下和释放不卡壳不蹭邻帽，合盖后仍自然回弹 | design/enclosure/README.md |  | 待测
K03 | 60 逐键回弹 | SW3 × 三阶段机械检查 |  |  | 分别记轴体/装帽开盖/合盖后三段观察 | 全程断电；只按至轴正常止点，不过压凑4mm | 标签与布局一致、坐平、按下和释放不卡壳不蹭邻帽，合盖后仍自然回弹 | design/enclosure/README.md |  | 待测
K04 | 60 逐键回弹 | SW4 Bk 三阶段机械检查 |  |  | 分别记轴体/装帽开盖/合盖后三段观察 | 全程断电；只按至轴正常止点，不过压凑4mm | 标签与布局一致、坐平、按下和释放不卡壳不蹭邻帽，合盖后仍自然回弹 | design/enclosure/README.md |  | 待测
K05 | 60 逐键回弹 | SW5 7 三阶段机械检查 |  |  | 分别记轴体/装帽开盖/合盖后三段观察 | 全程断电；只按至轴正常止点，不过压凑4mm | 标签与布局一致、坐平、按下和释放不卡壳不蹭邻帽，合盖后仍自然回弹 | design/enclosure/README.md |  | 待测
K06 | 60 逐键回弹 | SW6 8 三阶段机械检查 |  |  | 分别记轴体/装帽开盖/合盖后三段观察 | 全程断电；只按至轴正常止点，不过压凑4mm | 标签与布局一致、坐平、按下和释放不卡壳不蹭邻帽，合盖后仍自然回弹 | design/enclosure/README.md |  | 待测
K07 | 60 逐键回弹 | SW7 9 三阶段机械检查 |  |  | 分别记轴体/装帽开盖/合盖后三段观察 | 全程断电；只按至轴正常止点，不过压凑4mm | 标签与布局一致、坐平、按下和释放不卡壳不蹭邻帽，合盖后仍自然回弹 | design/enclosure/README.md |  | 待测
K08 | 60 逐键回弹 | SW8 − 三阶段机械检查 |  |  | 分别记轴体/装帽开盖/合盖后三段观察 | 全程断电；只按至轴正常止点，不过压凑4mm | 标签与布局一致、坐平、按下和释放不卡壳不蹭邻帽，合盖后仍自然回弹 | design/enclosure/README.md |  | 待测
K09 | 60 逐键回弹 | SW9 4 三阶段机械检查 |  |  | 分别记轴体/装帽开盖/合盖后三段观察 | 全程断电；只按至轴正常止点，不过压凑4mm | 标签与布局一致、坐平、按下和释放不卡壳不蹭邻帽，合盖后仍自然回弹 | design/enclosure/README.md |  | 待测
K10 | 60 逐键回弹 | SW10 5 三阶段机械检查 |  |  | 分别记轴体/装帽开盖/合盖后三段观察 | 全程断电；只按至轴正常止点，不过压凑4mm | 标签与布局一致、坐平、按下和释放不卡壳不蹭邻帽，合盖后仍自然回弹；5键有浅圆定位凹点 | design/enclosure/README.md |  | 待测
K11 | 60 逐键回弹 | SW11 6 三阶段机械检查 |  |  | 分别记轴体/装帽开盖/合盖后三段观察 | 全程断电；只按至轴正常止点，不过压凑4mm | 标签与布局一致、坐平、按下和释放不卡壳不蹭邻帽，合盖后仍自然回弹 | design/enclosure/README.md |  | 待测
K12 | 60 逐键回弹 | SW12 + 三阶段机械检查 |  |  | 分别记轴体/装帽开盖/合盖后三段观察 | 全程断电；只按至轴正常止点，不过压凑4mm | 标签与布局一致、坐平、按下和释放不卡壳不蹭邻帽，合盖后仍自然回弹 | design/enclosure/README.md |  | 待测
K13 | 60 逐键回弹 | SW13 1 三阶段机械检查 |  |  | 分别记轴体/装帽开盖/合盖后三段观察 | 全程断电；只按至轴正常止点，不过压凑4mm | 标签与布局一致、坐平、按下和释放不卡壳不蹭邻帽，合盖后仍自然回弹 | design/enclosure/README.md |  | 待测
K14 | 60 逐键回弹 | SW14 2 三阶段机械检查 |  |  | 分别记轴体/装帽开盖/合盖后三段观察 | 全程断电；只按至轴正常止点，不过压凑4mm | 标签与布局一致、坐平、按下和释放不卡壳不蹭邻帽，合盖后仍自然回弹 | design/enclosure/README.md |  | 待测
K15 | 60 逐键回弹 | SW15 3 三阶段机械检查 |  |  | 分别记轴体/装帽开盖/合盖后三段观察 | 全程断电；只按至轴正常止点，不过压凑4mm | 标签与布局一致、坐平、按下和释放不卡壳不蹭邻帽，合盖后仍自然回弹 | design/enclosure/README.md |  | 待测
K16 | 60 逐键回弹 | SW16 Enter/= 三阶段机械检查 |  |  | 分别记轴体/装帽开盖/合盖后三段观察 | 全程断电；只按至轴正常止点，不过压凑4mm | 标签与布局一致、坐平、按下和释放不卡壳不蹭邻帽，合盖后仍自然回弹；Enter与=为双行 | design/enclosure/README.md |  | 待测
K17 | 60 逐键回弹 | SW17 Mode 三阶段机械检查 |  |  | 分别记轴体/装帽开盖/合盖后三段观察 | 全程断电；只按至轴正常止点，不过压凑4mm | 标签与布局一致、坐平、按下和释放不卡壳不蹭邻帽，合盖后仍自然回弹 | design/enclosure/README.md |  | 待测
K18 | 60 逐键回弹 | SW18 0 三阶段机械检查 |  |  | 分别记轴体/装帽开盖/合盖后三段观察 | 全程断电；只按至轴正常止点，不过压凑4mm | 标签与布局一致、坐平、按下和释放不卡壳不蹭邻帽，合盖后仍自然回弹 | design/enclosure/README.md |  | 待测
K19 | 60 逐键回弹 | SW19 . 三阶段机械检查 |  |  | 分别记轴体/装帽开盖/合盖后三段观察 | 全程断电；只按至轴正常止点，不过压凑4mm | 标签与布局一致、坐平、按下和释放不卡壳不蹭邻帽，合盖后仍自然回弹 | design/enclosure/README.md |  | 待测
K20 | 60 逐键回弹 | SW20 AC 三阶段机械检查 |  |  | 分别记轴体/装帽开盖/合盖后三段观察 | 全程断电；只按至轴正常止点，不过压凑4mm | 标签与布局一致、坐平、按下和释放不卡壳不蹭邻帽，合盖后仍自然回弹 | design/enclosure/README.md |  | 待测
M01 | 70 合盖与维护 | 自然合缝 |  |  | 托住两壳轻合/观察四周 | 线束已整理，先不依靠螺钉拉合 | 定位唇自然贴合，无回弹、顶LCD或PCB弯曲，无柱/唇/USB/轴脚夹线 | product/harness-routing.md; product/matrix-assembly-diagrams/guided-soldering.md |  | 待测
M02 | 70 合盖与维护 | 四颗底部螺钉 |  |  | 核长度/轻拧 | 自然合缝后 | 仅4颗M3×8向上合盖，不强拧掩盖缝隙；后续可正常拆卸 | product/harness-routing.md; product/matrix-assembly-diagrams/guided-soldering.md |  | 待测
M03 | 70 合盖与维护 | Type-C机械试插 |  |  | 使用另一端悬空的线头试插后拔出 | 不接电脑、充电器或任何供电端 | 正反插均能完全就位、不挤壳或牵线；开口9.44×3.66mm；不做USB枚举或供电测试 | product/harness-routing.md; product/matrix-assembly-diagrams/guided-soldering.md |  | 待测
M04 | 70 合盖与维护 | 两档支撑与前垫 |  |  | 抬起切档后轻放水平面 | 两只后脚在同一实体限位档，前D12×2垫齐全 | 观察落桌贴合、摇晃、滑移、回折或帽松动；如有异常记录，不把几何核对当承载实测 | product/harness-routing.md; product/matrix-assembly-diagrams/guided-soldering.md |  | 待测
M05 | 70 合盖与维护 | 20键合盖后复查 |  |  | 逐键轻按并释放 | K01～K20均填合盖后观察 | 20键均回弹；SW10定位凹点、SW16 Enter/=位置正确，未以合盖压平PCB | product/harness-routing.md; product/matrix-assembly-diagrams/guided-soldering.md |  | 待测
M06 | 70 合盖与维护 | 30mm维护开口 |  |  | 卸4颗M3、手托底盖沿局部负z缓慢下放并量开口 | 外部线缆全断，两壳均受支撑 | 接口立台随底盖向下退出，无须横撬；可到30mm；10矩阵线自然展开，桥处不滑移、线皮不紧、焊点不受拉；遇阻停止重排 | product/harness-routing.md; product/matrix-assembly-diagrams/guided-soldering.md |  | 待测
M07 | 70 合盖与维护 | LCD随底盖移动 |  |  | 观察LCD五线与模块 | 30mm开口过程中，不撬玻璃 | LCD与主控一同移动，LCD线没有跨上壳固定；完全分离仍需断开焊线 | product/harness-routing.md; product/matrix-assembly-diagrams/guided-soldering.md |  | 待测
M08 | 70 合盖与维护 | 重合盖后供电节点 |  |  | 同档位记录3V3—GND方向/稳定值/趋势 | 外部供电断开，对照P03 | 不得出现未解释的新持续近表线低阻；读数变化先查，不要求固定阻值或OL | product/harness-routing.md; product/matrix-assembly-diagrams/guided-soldering.md |  | 待测
M09 | 70 合盖与维护 | 重合盖后机构与残屑 |  |  | 目视并复查受影响K项 | 重新排线或返修后 | 无夹线/裸铜/碎屑，键、翻脚与USB口不受干涉；修复有复查记录 | product/harness-routing.md; product/matrix-assembly-diagrams/guided-soldering.md |  | 待测
M10 | 70 合盖与维护 | 记录与本阶段结束 |  |  | 检查未填项、异常及引用记录 | 仅在确实操作并提供实测后判断完成 | 必测项有记录，异常有处置/复查；缺项不代填通过；停在断电检查，功能待后续验收 | product/harness-routing.md; product/matrix-assembly-diagrams/guided-soldering.md |  | 待测
