Cailynoo7/CalcKey/product/type-c-step-diagnostics.md

# Type-C版整机STEP诊断

本次仅定位问题，没有改CAD源码、参数、开口、零件位置或导入模型。当前版本17314e9，CAD状态指纹保持654e42c0。40份源码/资产/接线文件的逐文件SHA256及汇总指纹前后相同；开口仍为9.44×3.66mm。

## 已复现的确定故障

Waveshare原厂主控模型在内存中有效，写为STEP并重读后无效。故障位于Type_C1 USB金属壳子组件的第16号实体（从0计数），体积约65.63855mm³。重读后有3处面被报告为BRepCheck_UnorientableShape：1个平面和2个锥面。这些索引只用于本次诊断的重读对象，不是稳定面编号。

主壳、底盖、矩阵PCB组件各自STEP往返检查通过。在临时内存测试中只排除主控后，其余443个实体也全部有效。主控没有从正式装配删除；这个对照测试没有生成文件，更不能当作删掉主控后的交付方案。

## 耗时范围

| 隔离对象 | 写入与重读有效性检查总耗时（约） | 结果 |
|---|---:|---|
| 底盖 | 0.17秒 | 有效 |
| 主壳 | 0.20秒 | 有效 |
| 微雪主控 | 4.71秒 | 重读无效 |
| 矩阵PCB组件 | 7.81秒 | 有效 |

用相同Build123d序列化函数对35个已提交对象作纯内存诊断：装配文档与转换约1.50秒、写流0.56秒，约49.5MB；重读约3.10秒（不含有效性检查），565个实体，整体仍因主控模型而无效。所有流均在内存，没有生成或替代制作STEP。

因此，现有证据排除了普通STEP序列化本身必然要300秒的解释，也不能只凭面数多就判断是性能问题。前次完整交付仅返回300秒超时，没有细分阶段日志；本次无法确定到底在哪个校验、修复或其他交付子步骤耗尽时间。原厂模型拓扑故障已确定；它与完整交付超时的具体调用关系仍缺证据。

## 交付边界与下一步

完整交付仍未通过，当前模型预览和此前装配检查继续可用；本次不把内存诊断当作正式发布，也没有重复运行已知会超时的完整流程。

下一步应保形修复原厂模型拓扑，或取得同版、几何一致的有效机械模型；只有几何对照通过才替换导入，并重新完成整机交付。若仍超时，需要完整交付各阶段的耗时与失败日志。目前可用操作没有暴露这一日志选项。

未打印、未上电、未烧录、未提交Git。详细步骤、数据、源文件哈希和诊断限制均已记录在配套JSON中。
