Cailynoo7/CalcKey/product/matrix-assembly-diagrams/02-j1-j10-to-controller.png

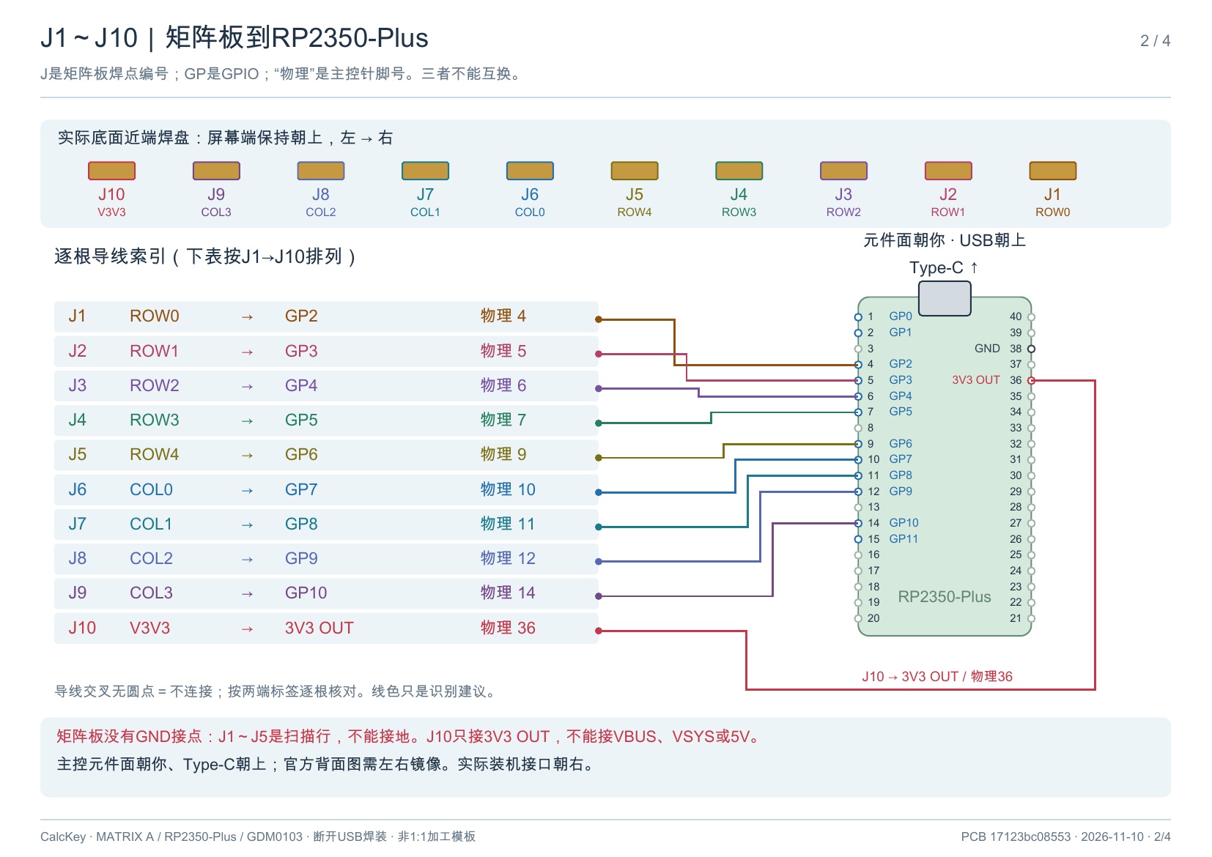
product/matrix-assembly-diagrams/02-j1-j10-to-controller.png
