Cailynoo7/CalcKey/product/matrix-assembly-diagrams/03-lcd-orientation-and-wiring.png

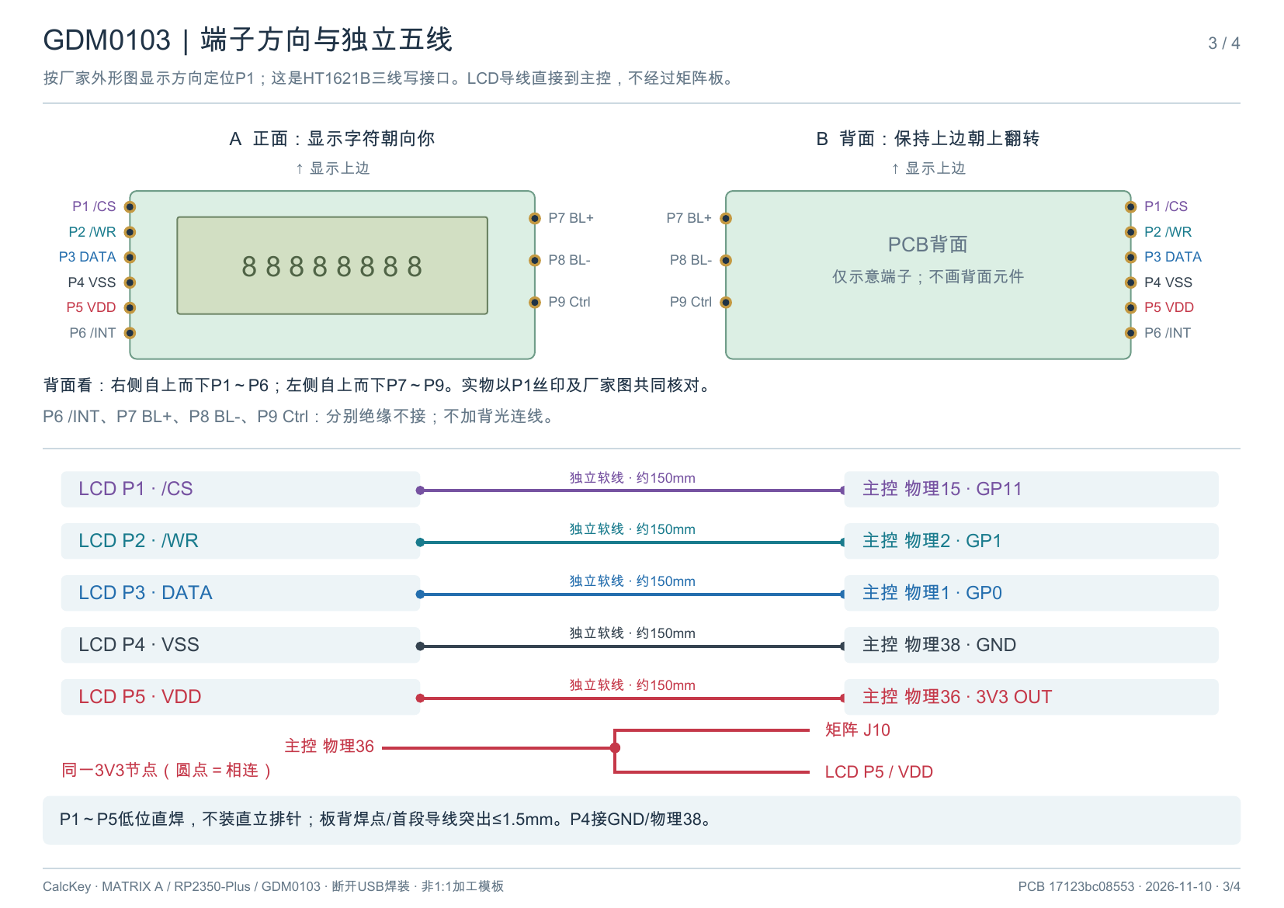
product/matrix-assembly-diagrams/03-lcd-orientation-and-wiring.png
