Cailynoo7/CalcKey/product/matrix-assembly-diagrams/04-details-and-unpowered-checks.png

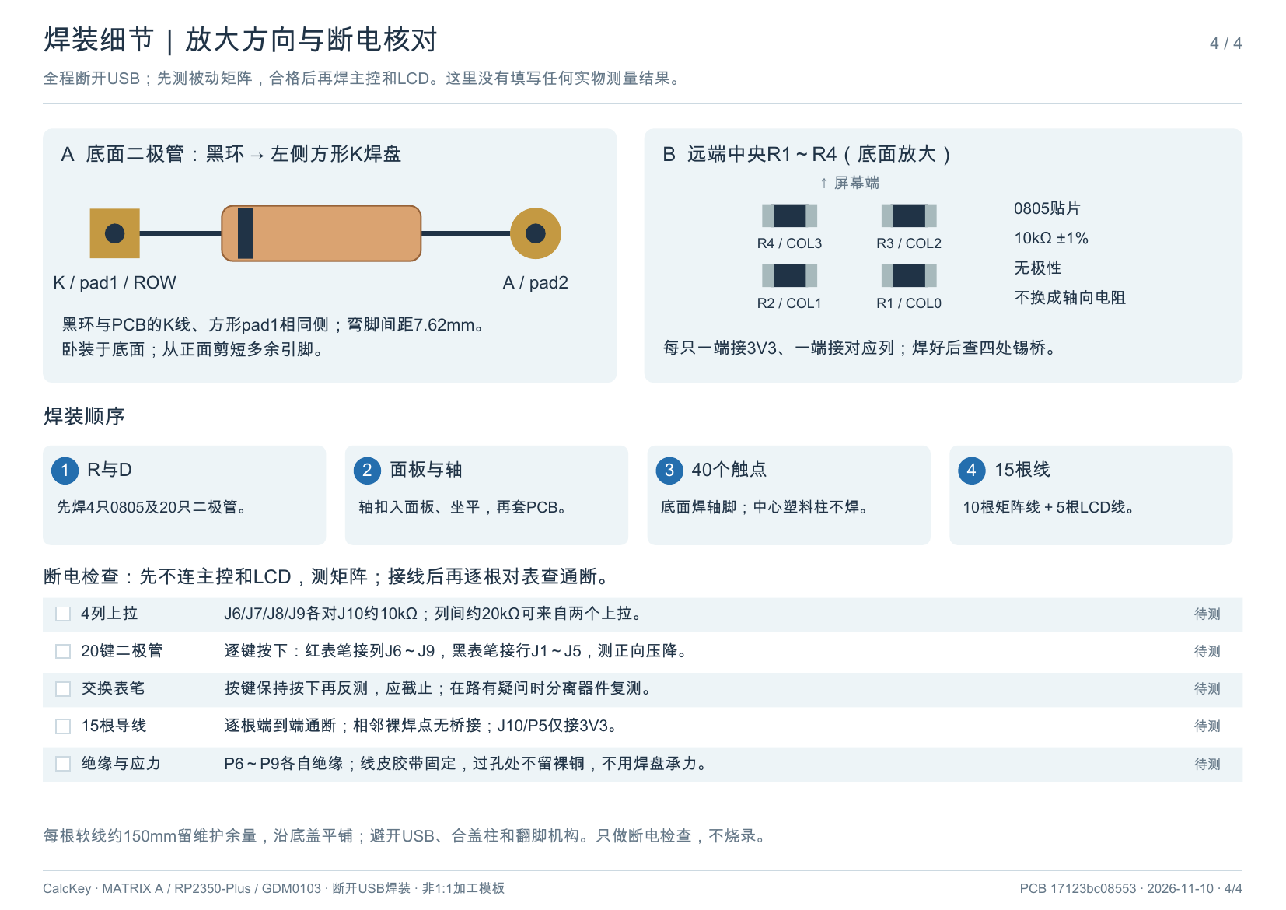
product/matrix-assembly-diagrams/04-details-and-unpowered-checks.png
