Cailynoo7/CalcKey/product/mechanical-verification.md

> **LCD版本提示（2026-11-05）：本资料对应旧SSD1315 OLED硬件。当前已改选GDM0103/HT1621B八位LCD；屏幕接线、驱动、显示验收均不能直接沿用。当前LCD接线以LCD替换说明和接线记录为准；当前LCD固件已升级v0.2.0并完成编译验证；本旧OLED资料仍不可直接沿用，先不烧录。矩阵GPIO保持不变。**

# CalcKey 机械尺寸与装配核对

当前外壳/打印键帽版本：6134f8c1d6dfe0c684f8ec5a94357dd88a297d03aff8793b2b11812094c1765c。三种试配帽版本：45932384f35ccb97f7435070bd42d8218c8366dd4fe843f035254e91ee64c7ea。未改动的外壳机构沿用e91ebb7核对，当前新增键帽检查如下。
当前结构：局部89×130×21mm顶侧一体主壳、独立底盖、两只翻折角柱后脚，收起2.41103°、展开4°后高前低。以下为CAD及明确尺寸包络检查，不代替实物试制。

## 自制键帽已完成的几何检查

用户选择20个实际键帽3D打印，现有参考帽已替换为20个独立打印件；帽壳、中心圆柱插座融合为一体，文字凹刻。20件均有效且各只有1个实体。侧壁1.2mm、顶壁1.6mm；十字孔截面实测长4.10×4.10mm、面积8.4mm²（臂宽1.20mm），入口z1.4、止挡z5.2、深3.8mm。只读探针确认止挡面上方有实体、下方为孔。入口最薄名义壁0.65mm，是精细打印的待试验特征。

三种完整试配帽P0/P5/P10分别为孔长/臂宽4.10/1.20、4.15/1.25、4.20/1.30mm，均为有效单实体。20个正式帽按暂定安装位置法向下压4mm，对主壳、底盖、Pico、螺钉、保护片无穿插，与面板最小1mm；网格0.02mm、路径步长0.5mm，两批各9姿态。不含缺少精确模型的实际轴体上盖/轴芯；轴芯就位高度、松紧、卡扣和强度仍需实配。下文e91ebb7记录中“键帽无插座/外购DSA”描述只适用于当时的参考模型。

## e91ebb7阶段的轴体精确模型与安装高度记录

本轮检查尚未获得精确CHERRY MX2A-L1NN（EAN4025112104640）的STEP/STP，未导入通用MX或其他型号替代。20个实际轴体、键帽十字插座及其安装配合仍未完成三维验证；现有导出保持不变。

20孔只读切片检查：上层全为14.2×14.2mm，下层全为16.4×16.4mm，夹持台阶厚1.5mm。新取得CHERRY历史MX目录第3页给通用金属框架孔14±0.05mm、厚1.5±0.1mm；它仅是历史系列接口参考，不是本型号带公差图。14.2mm仍是打印试配默认值，不能宣称是厂商孔径或已保证卡牢。

当前参考帽底局部z26、面板顶z21，空隙5mm；帽壳没有十字插座。20帽法向下压4mm再次检查无穿插、最小间隙1mm（网格弦差0.02mm、步长0.5mm），只能证明参考帽壳的运动余量，不能证明真实安装高度。需要精确轴体肩位/轴顶高度和已购键帽的插座深度、止挡位置，才能确认是否应调整帽高。

查找渠道、已读资料和未读URL、完整测值、尚缺证据及可交给供应商的索取文字见配套MX2A安装核对记录。未发送任何外部询问。

## 关键装配默认值

保留Pico 2、0.96英寸Grove SSD1315、20个MX2A-L1NN与DSA 1U键帽。OLED原直插Grove座必须拆焊换为NS Tech 1125R-4P侧插座，保留原信号对应。OLED柱在PCB下方，螺钉从元件面装入，避免向下柱侵入板上元件。该改装是紧凑布局的明确默认值，不是用户指定新器件，也不是原装直插状态已通过。

主控横放在按键下方，原厂STEP位置(16.4,-10,5.3)，Z=-90°，Micro-B右侧出线。底盖4颗ISO7380-1 M3×8圆头螺钉；主控和OLED各2颗ISO4762 M2×4。前端两只D12×2mm脚垫，后端两只翻折角柱脚。当前展示展开4°姿态，整机Z平移6.45954242mm；收起2.41102975°，Z平移4.69058083mm。含参考键帽高度41.59741/38.99913mm。以下器件布局为局部坐标。

## 原始尺寸证据

| 项目 | 已读依据和尺寸 | 使用边界 |
| --- | --- | --- |
| MX2A-L1NN | CHERRY署名精确型号1页数据表，19.05mm键距、4mm行程、2mm预行程、3针面板安装、EAN4025112104640 | 没有开孔/卡扣公差、肩位、焊脚高度机械图；14.2mm轴孔、1.5mm台阶是试配默认值 |
| 新版MX2A_L1NN | CHERRY署名14页数据表第10–11页，15.63×15.63×18.5mm，EAN4025112120954 | 与旧主选EAN/写法不同，只作系列外廓参考，未替换主选 |
| OLED载板 | Seeed V1.0 BRD，U5板框x=-20..22.1、y=-12.1..12.1，含耳42.1×24.2，孔Ø2.2，(-10,±10)/(20,0) | 圆弧、凹槽按原始板框；实际PCB厚度未由图纸公差确认，默认1.6mm |
| OLED裸屏 | Seeed提供图纸第5页，24.74±0.2×16.9±0.2×1.42±0.1mm，V/A22.74±0.2×11.86±0.2，A/A21.74±0.2×10.86±0.2 | 厚度不包括载板、贴合胶、座体和其他元件，不能当整板高度 |
| OLED位置 | U4相对U5为(6.3545,0)，J1焊盘行中心(-16.5055,0)，4针2mm沿y | 本版U5(-6.3545,49,9)，裸屏封装中心(0,49)，连接器焊盘行中心(-22.86,49) |
| 1125R-4P | NS Tech原厂图，板上高度名义5.1mm，未注公差保守取5.6mm | 座体上限包络10.3×10.6×5.6，不包括整条插头和出线 |
| Grove线头/弯线 | 明确采购/装配限制12×10.6×6mm，单端开口线200mm | 这是设计允许外廓，需要实物符合；未冒充厂商线头尺寸 |
| 原直插座 | 1125S-4P原厂图板上高度8.1mm，保守8.6mm；HW4-2.0与该系列匹配为推断 | 旧版板位会与上盖相撞，不适用本版；原厂BRD未写具体装机座体料号 |

## 内部布局复核（保持局部坐标）

1. 主壳、底盖、保护片有效且各一个连续实体。20个参考键帽壳有效、字形接触键帽。
2. 本版已发布31个对象、465对组合，无共有体积，无未判定组合。此范围不包含缺少真实3D模型的OLED、MX轴体、线束、胶框和脚垫。
3. 20处16.4×16.4×10mm轴下接线区无穿插，离Pico最近0.705mm、螺钉1.24mm、底盖3.091mm；与主壳孔壁接触为预期边界接触。
4. 参考键帽4mm下压路径无共有体积，距面板最小1mm。按键到左右外缘6.825mm、前缘4.3mm、首排键帽到显示窗口3.3mm。实物键帽和十字轴未由参考壳体验证。
5. 临时OLED板形采用原始BRD线段与圆弧、Ø2.2孔、默认厚1.6mm：板底接触下方柱、板顶接触螺钉头，无共有体积；板边离主壳1.5mm。
6. 原厂小器件本体轮廓上方1.5mm范围与固定结构无共有体积；D1剔除外侧极性十字标记。到螺钉头最近U1约0.4535mm、D1约0.517mm。这是封装轮廓检查，不是完整元件3D检查。
7. 侧插座上限包络离主壳1.8mm；允许的Grove线头/弯线包络离主壳1.1mm。不能忽略完整线头的实物试配。
8. 底盖携Pico向下移出30mm路径无穿插；临时OLED板形、侧插座和线头包络同向以0.5mm步进复核也无共有体积。需先拔USB、卸底部螺钉，矩阵主线留150mm柔性余量；完全分离须断开手焊线束。
9. 主壳USB口为开至底缘的U形口，宽13、高9.5mm，z2.4..11.9。12×8mm允许线头离主壳最近0.5mm，离底盖约0.5385mm。
10. 保护片到上壳最小0.15mm，留给胶框。当前倾斜摆放姿态中螺钉最低点离桌面展开1.78787mm、收起1.21734mm。

路径/间隙工具使用0.02mm网格弦差，路径0.5mm采样步长；临时板形/轮廓布尔检查来自原始2D资料与明确默认高度。当前未进行打印、强度、固件、电气或实机测试。

## 翻脚、窗口与装配检查

- 主壳上缘0.4mm细倒角、前侧0.35mm浅刻CALC和短斜线保留；前壁剩余2.05mm、上缘2.0mm。底盖恢复完整2.4mm底板，外侧新增一体轴耳、展开斜限位及收起平限位。
- 两脚支点局部(±29.5,50,-3.2)mm。脚宽10、主体长8.5、厚3.6、根部R2.6mm；PETG销轴Ø2.4配Ø2.8孔，径向0.2mm间隙。轴耳厚3mm、R3，脚两侧各0.25mm；孔边最薄1.2mm（脚根）、1.6mm（轴耳）。
- 翻转范围0～110°，展开角柱相对世界竖直向后24°。收起时脚底中心相对转轴水平力臂−0.64926mm，展开时+2.51631mm；向上桌面反力分别压向收起/展开限位。超出两限位各1°的临时精确布尔出现共有体积1.86696/0.29372mm³，证明两端均有实体阻挡；这是受压稳定，不是卸载后的锁定机构。
- 从110°到0°完整翻转，对底盖、主壳、两根轴和两盲帽无穿插；网格弦差0.02mm，步长0.2mm，342姿态。到销轴最小网格间隙0.1961mm，与名义0.2mm相符；两档与限位接触是设计接触。
- 两档脚底最低点均在桌面Z=0，平面法向(0,0,-1)，每脚平面接触面积收起16.01418、展开27.30670mm²。前垫临时D12×2圆柱也与桌面相切；数值误差小于1e-10mm。脚垫未冒充真实发布件。
- 盲帽外Ø5×2.4mm，孔Ø2.6深1.2mm，壁1.2mm、闭底1.2mm；与轴端径向胶隙0.1mm、端部余量0.2mm，帽至轴耳0.15mm。销轴杆长17.8mm、有效胶合插入1mm。环氧胶只用于轴端与帽内孔；需试制验胶合，不得粘死转动面。
- 窗口32×16mm，保护片35.6×19.6×1mm、槽36×20mm；片顶/槽顶保持19.2/19.35mm。正常视线V/A容差包络23.14×12.26mm、玻璃中心偏移±1.52mm与主壳无共有体积；该检查不代替斜视角和实际玻璃贴合试验。保护片到主壳胶隙0.15mm。
- 主壳、底盖、两脚、两轴、两盲帽均有效且各一个连续实体。实际打印销轴强度、帽粘接、翻脚寿命、桌面防滑/摇晃及OLED侧视效果仍待试制。
- 底盖外侧向下打印需在底板下方支撑；避免把支撑塞入铰链孔与限位配合面。脚端面贴床、销轴竖直100%填充、帽闭口端贴床。STEP整机展示姿态不直接作为打印朝向。

- 两脚各内收2mm后，名义支撑多边形包含20个按键中心的竖直投影，最近边界余量收起6.75183mm、展开6.86639mm。前垫按刚性圆柱前缘点、后脚按真实水平底面取凸包；这不是实际抗倾覆或粘接载荷试验。

## 来源

- CHERRY精确型号署名数据表镜像：https://docs.ebay.com/document/a508b54f-d93a-4c6d-bce3-92cae32c4cb1 ，第1页；sha256 53e5f85cf0d7664c79c8e4de06917f77f8a702992f331e8d56259ac844b097c3。
- CHERRY新版系列署名数据表镜像：https://cdn.robotshop.com/media/S/Spa/RB-Spa-2726/pdf/cherry_mx2a_red_keyswitch_datasheet.pdf ，第10–11页；sha256 edc84247bbff978d9c1f161c9060d46909c2542d838e30018eb56322a8752f3a。
- Seeed原厂BRD和原理图：https://files.seeedstudio.com/wiki/Grove-OLED-Display-0.96-SSD1315-/res/Grove%20-%20OLED%20Display%200.96%20(SSD1315)_v1.0.zip 。
- Seeed裸屏图纸：https://files.seeedstudio.com/wiki/Grove-OLED-Display-0.96-SSD1315-/res/OEL%20Display%20Module.pdf ，第5页；sha256 298d155e00da1cc8fb7a2a4a2c0149973a3b238694e0b594b9bd85f12c68be5c。
- 侧插1125R-4P：https://statics3.seeedstudio.com/fusion/opl/datasheet/320110034.pdf ，第1页；sha256 4ea11a6f4b254ad5d033c6d4ea8678f187829b6b2d4cbe39db0e52951cc7696f。
- 原直插1125S-4P：https://statics3.seeedstudio.com/images/opl/datasheet/3470130P1.pdf ，第1页；sha256 4f2085845d76747e1a970b6e304c3894b7e54567afc90a614327fa6a228d4fb7。
- Grove连接器选型依据：https://www.seeedstudio.com/blog/2022/11/18/seeed-grove-designers-guide-pcb-design-guidelines-and-more/ 。
