Cailynoo7/CalcKey/product/bring-up-checklist.md

# CalcKey v0.2.0 烧录与实机验收表

本表只记录真实设备结果。屏幕配置为GDM0103 / HT1621B，旧OLED v0.1.0包不适用。编译及桌面测试已经通过；实机项目尚未执行，全部保持待测。固件对应Pico 2 / RP2350与GDM0103八位LCD；交付件的大小和SHA256以v0.2.0验证记录为准。本表供后续验收准备，用户要求先不烧录，本次不执行A段烧录或任何通电项目。

## 实物前提

- 使用Pico 2（不是初代Pico），支持数据传输的Micro-USB线。
- 完整版首次接电脑前，GP7/8/9/10应分别有10kΩ上拉至3.3V；固件关闭内部上拉，未接外部上拉的裸板不能用于完整版按键验收。
- 矩阵R0～R4接GP2/3/4/5/6；C0～C3接GP7/8/9/10。每键为列→开关→二极管阳极→阴极色环→行。
- GDM0103：P3 DATA→GP0（物理1）、P2 /WR→GP1（物理2）、P1 /CS→GP11（物理15）、P5 VDD→3V3（物理36）、P4 VSS→GND（物理38）；明确3.3V版本，P6–P9分别绝缘不接。
- 先不合壳，方便核对线路。已有其他应用程序的板，烧录会替换原应用；BOOTSEL恢复入口仍在芯片ROM中。

## A. 后续烧录（本次暂不执行）

1. 在Replicator右键Product，选择Show in Finder，解压固件交付包。
2. 找到包内Pico 2 v0.2.0的UF2，勿把ZIP、ELF或BIN复制到BOOTSEL磁盘。
3. 断开Pico USB，按住板上BOOTSEL再接电脑；出现RP2350磁盘后松开。
4. 将UF2拖进RP2350磁盘；完成后磁盘会消失，设备重新启动。
5. 观察电脑是否出现CalcKey Dual Mode USB键盘，LCD是否先显示PC，随后PC 0或PC 1。出现BOOTSEL磁盘只代表进入烧录模式，不等于固件运行通过。

| 项目 | 预期 | 实际 |
| --- | --- | --- |
| A1 BOOTSEL | 出现RP2350磁盘 | 待测 |
| A2 复制UF2与启动 | 复制完成，磁盘消失 | 待测 |
| A3 USB枚举 | 识别CalcKey Dual Mode，保持连接 | 待测 |
| A4 LCD | 先PC提示，再PC 0/PC 1显示主机NumLock状态 | 待测 |

若无磁盘：先换已确认支持数据的线、直接接电脑USB口，再重试按住BOOTSEL上电。不要以板上LED亮灭判断烧录成功，当前固件没有设置运行指示灯。

## B. 电脑键盘

打开一份空白纯文本供测试，不在真实文稿中试Backspace。先确认普通数字输入正常；NumLock关闭时数字键可能表现为方向/导航，由操作系统决定。LCD显示主机返回的NumLock状态，该灯态是否返回也要按实际系统记录。

| 物理键（行列） | 预期主机行为 | 实际 |
| --- | --- | --- |
| R0C0 NumLock | 主机切换NumLock（记录OS实际行为） | 待测 |
| R0C1 ÷ | 数字小键盘除号 / | 待测 |
| R0C2 × | 数字小键盘乘号 * | 待测 |
| R0C3 Backspace | 删除刚输入的测试字符 | 待测 |
| R1C0/C1/C2 | 依次7、8、9 | 待测 |
| R1C3 − | 小键盘减号 | 待测 |
| R2C0/C1/C2 | 依次4、5、6 | 待测 |
| R2C3 + | 小键盘加号 | 待测 |
| R3C0/C1/C2 | 依次1、2、3 | 待测 |
| R3C3 Enter/= | 回车/换行 | 待测 |
| R4C0 Mode | 不向电脑输入字符，切换到CALC | 待测 |
| R4C1 0 | 0 | 待测 |
| R4C2 . | 系统配置的小数键，记录实际字符 | 待测 |
| R4C3 AC | 只清本地计算器，不向电脑发键 | 待测 |

若整行/整列失败，先核对对应GP与焊点；若单键失败，核对该键、二极管方向和通断；若重复输入，先记录具体键与按住/轻触行为，不能直接判断为软件去抖问题。

## C. 接电脑的本地计算

按Mode后松开所有键，确认先提示CALC，随后显示本机数值。下面每项先按AC；操作符使用实体÷/×/−/+，等号使用Enter/=。

| 输入 | 屏幕预期 | 电脑预期 | 实际 |
| --- | --- | --- | --- |
| 12+34= | 46 | 无输入 | 待测 |
| 7−10= | -3 | 无输入 | 待测 |
| 1.5×2= | 3 | 无输入 | 待测 |
| 8÷4= | 2 | 无输入 | 待测 |
| 0.1+0.2= | 0.3 | 无输入 | 待测 |
| 1÷0= | Err；AC后为0 | 无输入 | 待测 |
| 123、Backspace、4= | 124 | 无输入 | 待测 |
| 2+3=，再=，再= | 5、8、11 | 无输入 | 待测 |
| −5+2= | -3 | 无输入 | 待测 |
| 2+3×4= | 20（逐步计算） | 无输入 | 待测 |
| 输入123，长按Backspace | 先删除一位；500ms后每80ms重复至0 | 无输入 | 待测 |

## D. 真正脱离电脑

断开USB，换接5V USB充电器。不能用仍连接电脑的数据口代替这一项。

| 项目 | 预期 | 实际 |
| --- | --- | --- |
| D1 仅接充电器上电 | 短暂CALC，随后0 | 待测 |
| D2 Mode | 仍保持CALC | 待测 |
| D3 重复C表前6项 | 所有结果与接电脑时相同 | 待测 |
| D4 拔电再接 | 断电关机；重新上电清零 | 待测 |

## E. 切换、长按和连接稳定性

| 项目 | 步骤与预期 | 实际 |
| --- | --- | --- |
| E1 键盘→计算器时按住数字 | 在空白文本中按住7，再按Mode；电脑停止继续输入；仍按住的7不进入计算器，全部抬起后新按键才生效 | 待测 |
| E2 计算器→键盘时按住数字 | 按住7再按Mode；电脑不突然输入7；全部抬起后重新按7可输入 | 待测 |
| E3 主机长按 | 键盘模式长按数字，由电脑重复，抬起即停止 | 待测 |
| E4 超过6个主机键 | 7键同时按下不随机选键；全部松开后正常，不能残留卡键 | 待测 |
| E5 睡眠/恢复 | 睡眠时LCD熄屏，模式不来回跳；用电脑自己的键盘唤醒，全部抬键后CalcKey恢复 | 待测 |
| E6 重复插拔 | 多次接电脑/充电器，默认模式正确，无卡键 | 待测 |
| E7 缺屏启动（可后测） | 先断电再断开LCD，再接电脑；USB键盘仍能输入。恢复接线也先断电 | 待测 |
| E8 运行稳定性 | 连续使用30分钟，记录死机、重启、屏幕异常及主机提示 | 待测 |

## F. 八位段码显示专项

| 输入（每项先AC） | 预期 | 实际 |
| --- | --- | --- |
| 12345678 | 左到右顺序正确 | 待测 |
| 88888888 | 8位的A–G全亮，冒号不亮 | 待测 |
| 1.2345678、12.345678、123.45678、1234.5678、12345.678、123456.78、1234567.8 | 七个小数点位置逐一正确 | 待测 |
| 0.、12.、−0. | 末尾点保留，末尾留空一格 | 待测 |
| 12345678. | 仍为12345678，不显示不存在的第8位右点 | 待测 |
| 1÷6=，再×6= | 0.1666667，然后1.0000002 | 待测 |
| 99999999+1= | Err；AC恢复0，新数字也可恢复 | 待测 |
| −9999999−1= | Err，负号不被截掉 | 待测 |
| 0.0000001÷3= | 舍入成0，无负零 | 待测 |
| 稳定显示与测量 | 实测对比度、6点钟视角、3.3V、波形和刷新；背光本版不接 | 待测 |

## 结果回报模板

- 设备和电脑系统：
- 实物已接：矩阵 / 四个10k上拉 / LCD：
- BOOTSEL磁盘：出现 / 未出现：
- 复制后：磁盘消失 / 仍存在：
- LCD文字：
- 电脑能否输入数字：
- 已测项目编号与结果：
- 首个异常：按了哪些键、屏幕显示什么、电脑实际收到什么：

当前尚无用户回报，不能把任何实机项目标为通过。USB挂起电流、耐久及完整Windows/macOS/Linux兼容性也没有实测。

## 官方操作依据

Raspberry Pi官方BOOTSEL拖放说明（Pico 2磁盘名RP2350）：
https://github.com/raspberrypi/documentation/blob/master/documentation/asciidoc/microcontrollers/micropython/drag-and-drop.adoc

该页面示范烧录MicroPython；本项目采用同一个ROM烧录入口，复制的是CalcKey的UF2，不需要安装MicroPython。
