Cailynoo7/CalcKey/product/type-c-reference-repair.md

# 微雪主控STEP保形修复

原厂USB壳体的STEP重读问题已修复并替换主控参考。当前修复仅改变一个故障实体的曲面表示，未删掉细节或改成网格；原厂原始STEP保留。

## 修复方法

先在当前装配坐标中进行拓扑修复，再将该实体的非平面解析曲面和曲线转换为等价NURBS表示，最后还原原厂引用坐标并保留原XCAF装配层级、名称与配色。直接在内部局部坐标转换的候选未通过验证，没有采用。外壳CAD没有在外部脚本重建；输入参考经验证后，通过正常CAD导入流程替换。

## 几何与重读核对

- 主控122个实体不变，其中121个实体保持原样。
- 故障实体转换前后双向差集体积均0；高精度体积差约0.00000428mm³，面积差约0.00000340mm²，均低于1e-5的数值检查阈值。普通积分对解析面和NURBS面可能产生不同近似读数，本次以高精度积分和差集共同判断，不把普通体积读数的微小差异当作材料增减。
- 整板包络坐标差为0；主控位置和旋转角保持原值。
- 派生参考连续两轮STEP重读有效；实际导入后整机565个实体的内存重读也有效。
- CAD对比仅报告主控参考的表示改变；其余34个对象未改变。原40份CAD源码/资产/接线文件中38份逐字节不变，仅设计注册及主控导入绑定更新，并新增修复资产。
- Type-C开口仍为9.44×3.66mm、每边间隙0.25mm，安装包络及所有打印件不变。
- 底盖下放30mm无新增干涉；网格精度0.02mm、采样步长0.5mm。主控与底盖间隙0.15mm、与矩阵组件间隙约3.8989mm。

## 正式交付

整机正式STEP交付校验已通过，当前版本18faaed，交付编号export-b7f82e97cb895f74ebf77fba5318d5a4。此次22.858秒完成，没有再次超时；无新增未声明或超预算穿插。原定位筋配合仍保留，不代表实物卡扣或夹持已验收。

详细源文件、派生文件和正式模型哈希保存在配套修复记录中。原无效面及300秒超时诊断属于修复前的历史记录；不再作为当前交付状态。

本次没有生成新STL或重打完整制作ZIP，没有打印、上电、烧录或提交Git。
