Cailynoo7/CalcKey/product/production/history/README.md

# 历史转换及检查依据

本目录只保存手焊行列版的原始STL转换记录、CAD导出记录副本和旧几何检查，保留当时revision，不是当前整机制作指令。当前矩阵PCB的装配证据与网格绑定见上级目录记录。28件网格仅在逐件形状哈希、放置和STL哈希全部一致时复用；旧STEP不混入正式包。
