Cailynoo7/CalcKey/product/matrix-assembly-diagrams/calckey-matrix-pcb-assembly.pdf

## 器件方向｜正反面对照

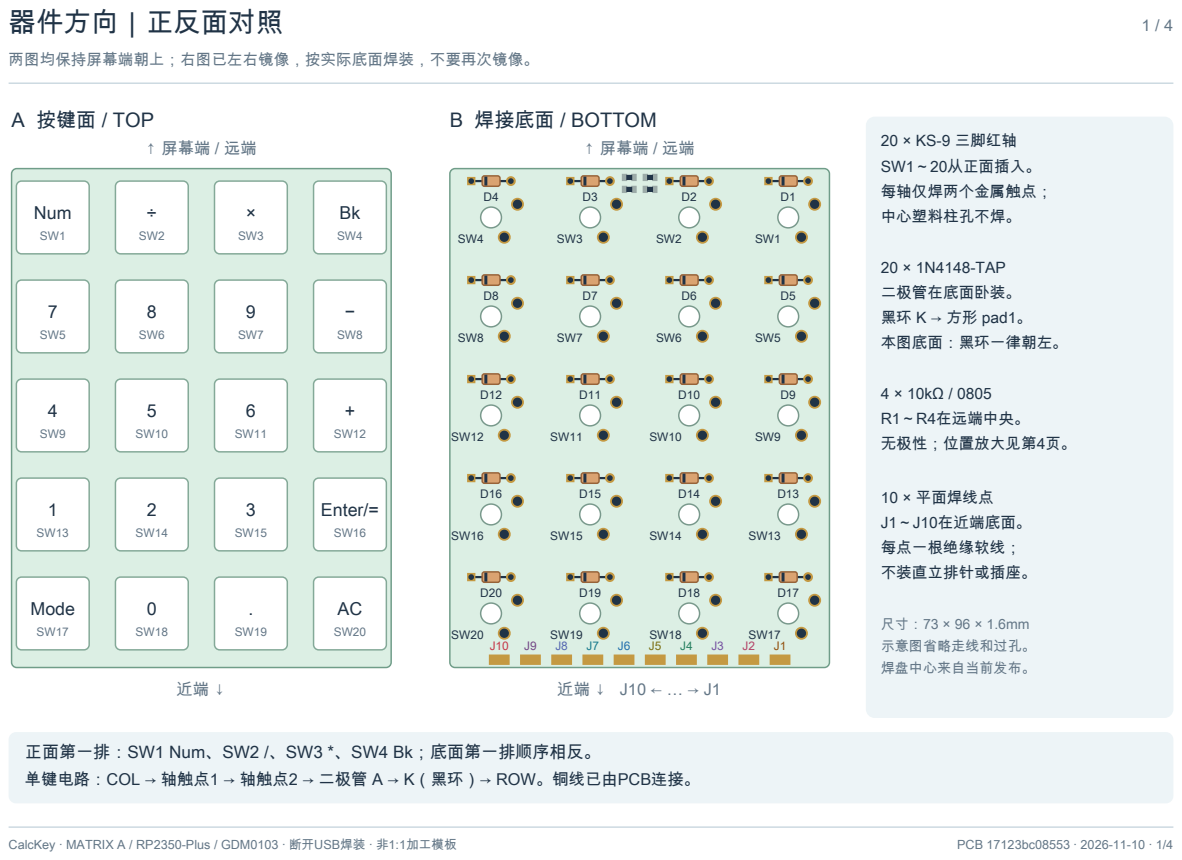
[picture p18: page 1]

两图均保持屏幕端朝上；右图已左右镜像，按实际底面焊装，不要再次镜像。

正面第一排：SW1 Num、SW2 /、SW3 *、SW4 Bk；底面第一排顺序相反。
单键电路：COL → 轴触点1 → 轴触点2 → 二极管 A → K（黑环）→ ROW。铜线已由PCB连接。

## J1～J10｜矩阵板到RP2350-Plus

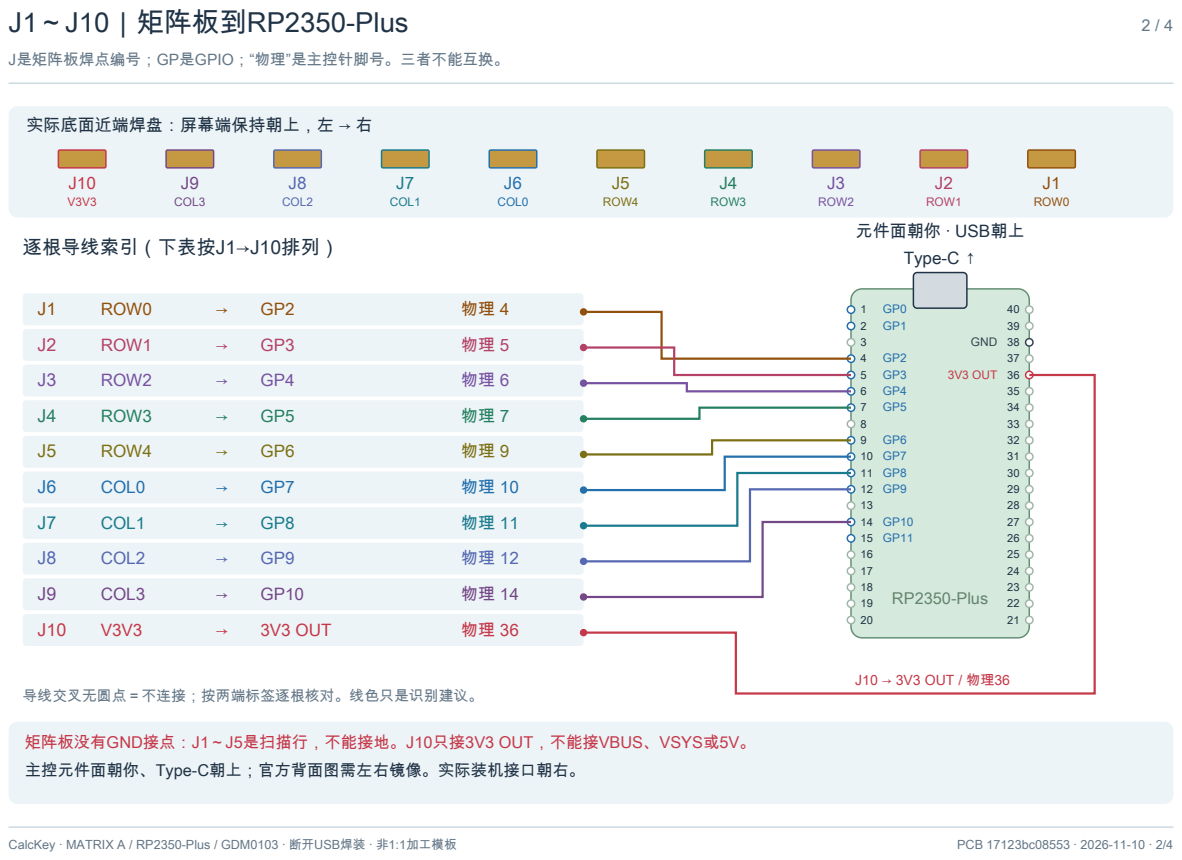
[picture p19: page 2]

J是矩阵板焊点编号；GP是GPIO；“物理”是主控针脚号。三者不能互换。

导线交叉无圆点＝不连接；按两端标签逐根核对。线色只是识别建议。

矩阵板没有GND接点：J1～J5是扫描行，不能接地。J10只接3V3 OUT，不能接VBUS、VSYS或5V。
主控元件面朝你、Type-C朝上；官方背面图需左右镜像。实际装机接口朝右。

## GDM0103｜端子方向与独立五线

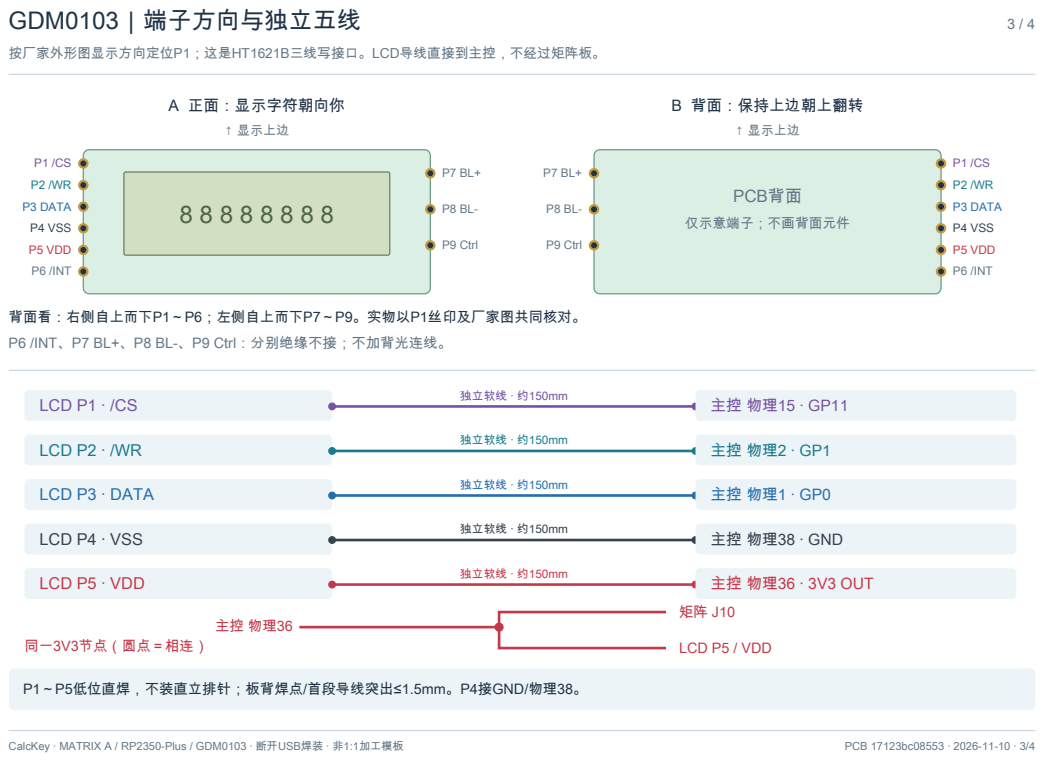
[picture p20: page 3]

P6 /INT、P7 BL+、P8 BL-、P9 Ctrl：分别绝缘不接；不加背光连线。

# 焊装细节｜放大方向与断电核对

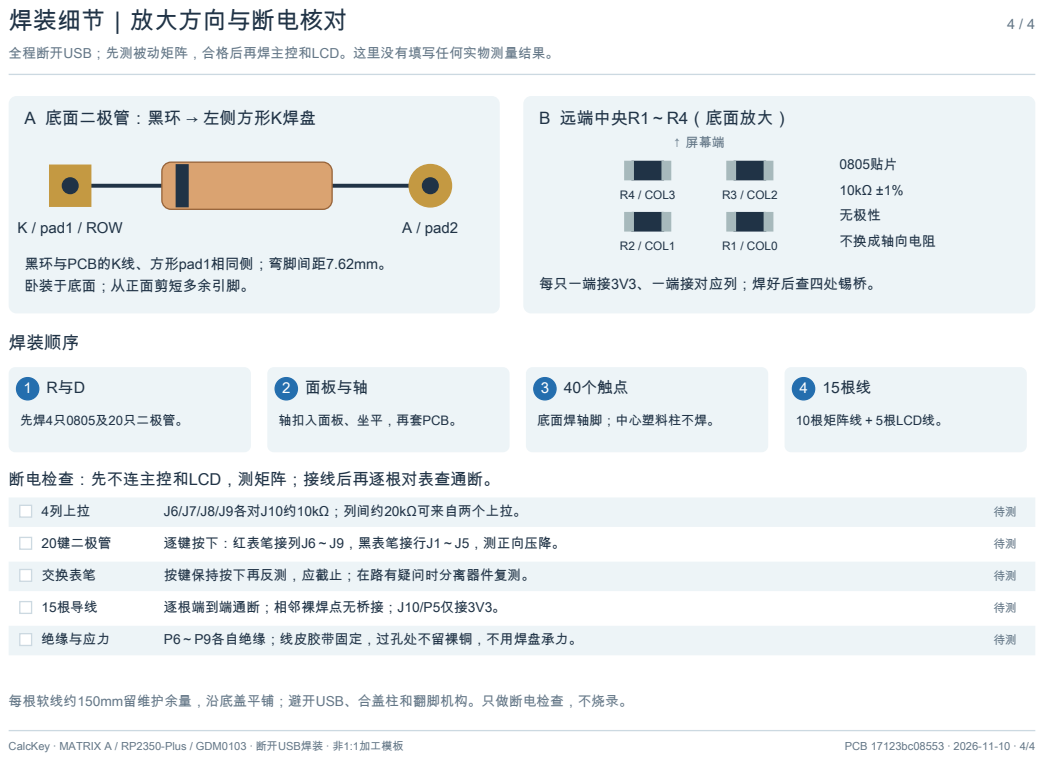
[picture p21: page 4]
K / pad1 / ROW; A / pad2; 黑环与PCB的K线、方形pad1相同侧；弯脚间距7.62mm。 卧装于底面；从正面剪短多余引脚。; B 远端中央R1～R4（底面放大）; ↑ 屏幕端; R2 / COL1; R1 / COL0; R4 / COL3; R3 / COL2; 无极性; 不换成轴向电阻; 每只一端接3V3、一端接对应列；焊好后查四处锡桥。; 焊装顺序; 1 R与D; 先焊4只0805及20只二极管。; 2 面板与轴; 3 40个触点; 底面焊轴脚；中心塑料柱不焊。; 10根矩阵线＋5根LCD线。; 4列上拉; J6/J7/J8/J9各对J10约10kΩ；列间约20kΩ可来自两个上拉。; 20键二极管; 逐键按下：红表笔接列J6～J9，黑表笔接行J1～J5，测正向压降。; 交换表笔; 按键保持按下再反测，应截止；在路有疑问时分离器件复测。; 15根导线; 逐根端到端通断；相邻裸焊点无桥接；J10/P5仅接3V3。; 绝缘与应力; P6～P9各自绝缘；线皮胶带固定，过孔处不留裸铜，不用焊盘承力。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

全程断开USB；先测被动矩阵，合格后再焊主控和LCD。这里没有填写任何实物测量结果。

A 底面二极管：黑环 → 左侧方形K焊盘

轴扣入面板、坐平，再套PCB。

断电检查：先不连主控和LCD，测矩阵；接线后再逐根对表查通断。

每根软线约150mm留维护余量，沿底盖平铺；避开USB、合盖柱和翻脚机构。只做断电检查，不烧录。
