Cailynoo7/CalcKey/product/diagrams/calckey-wiring-guide.pdf

# 20键矩阵｜正面布局与电气连接

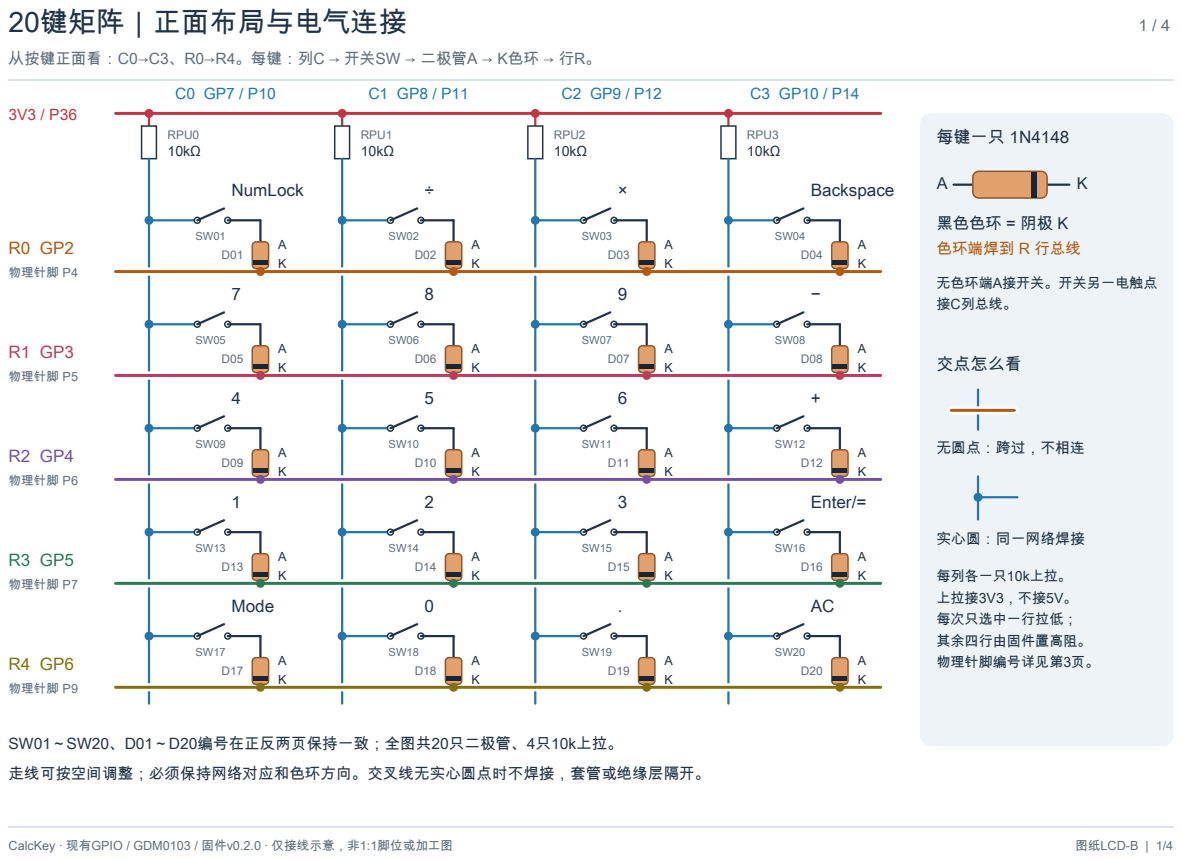
[picture p22: page 1]

从按键正面看：C0→C3、R0→R4。每键：列C → 开关SW → 二极管A → K色环 → 行R。

SW01～SW20、D01～D20编号在正反两页保持一致；全图共20只二极管、4只10k上拉。
走线可按空间调整；必须保持网络对应和色环方向。交叉线无实心圆点时不焊接，套管或绝缘层隔开。

# 背面焊接图｜左右已镜像

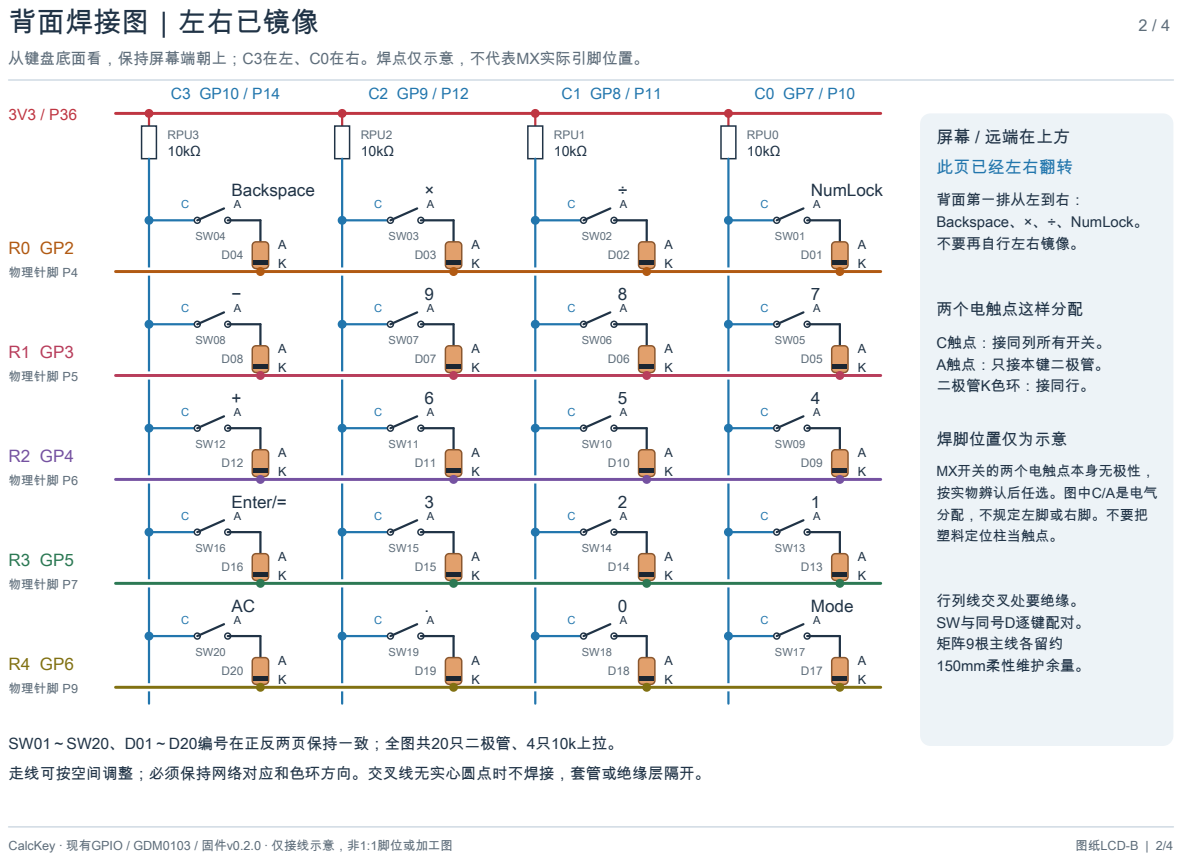
[picture p23: page 2]

从键盘底面看，保持屏幕端朝上；C3在左、C0在右。焊点仅示意，不代表MX实际引脚位置。

SW01～SW20、D01～D20编号在正反两页保持一致；全图共20只二极管、4只10k上拉。
走线可按空间调整；必须保持网络对应和色环方向。交叉线无实心圆点时不焊接，套管或绝缘层隔开。

## Pico 2 与 GDM0103｜针脚和四个上拉

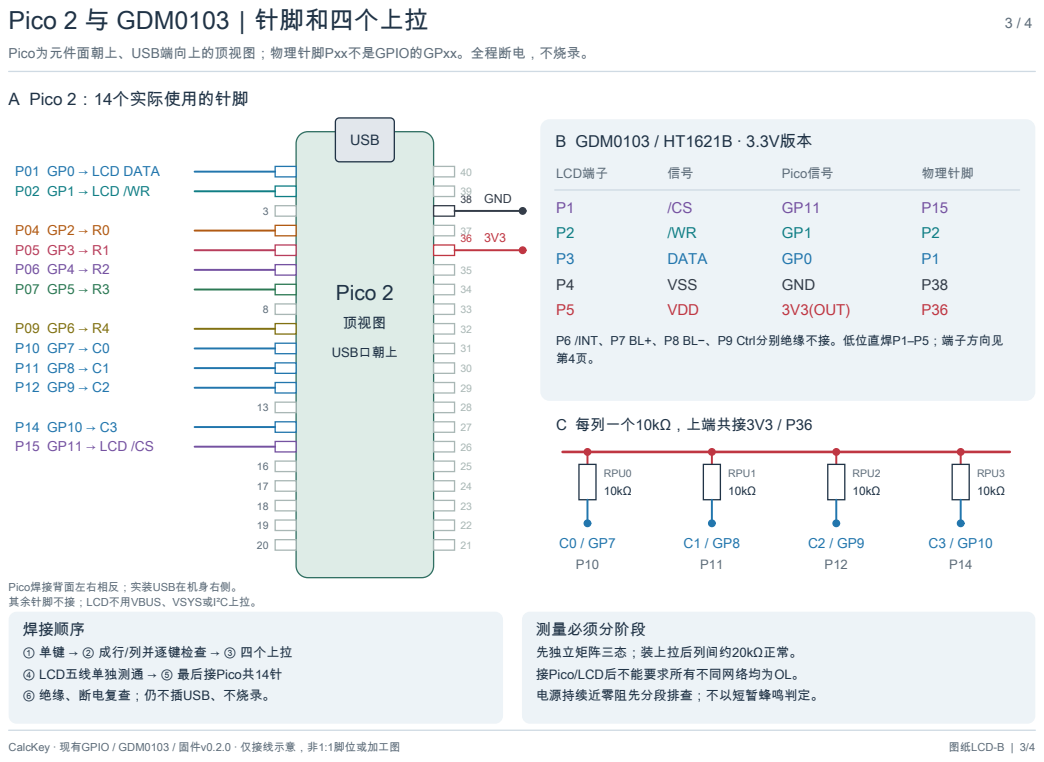
[picture p24: page 3]

Pico为元件面朝上、USB端向上的顶视图；物理针脚Pxx不是GPIO的GPxx。全程断电，不烧录。

P6 /INT、P7 BL+、P8 BL−、P9 Ctrl分别绝缘不接。低位直焊P1–P5；端子方向见

Pico焊接背面左右相反；实装USB在机身右侧。
其余针脚不接；LCD不用VBUS、VSYS或I²C上拉。
焊接顺序
① 单键 → ② 成行/列并逐键检查 → ③ 四个上拉
④ LCD五线单独测通 → ⑤ 最后接Pico共14针
⑥ 绝缘、断电复查；仍不插USB、不烧录。

## GDM0103｜正反面端子与五线直焊

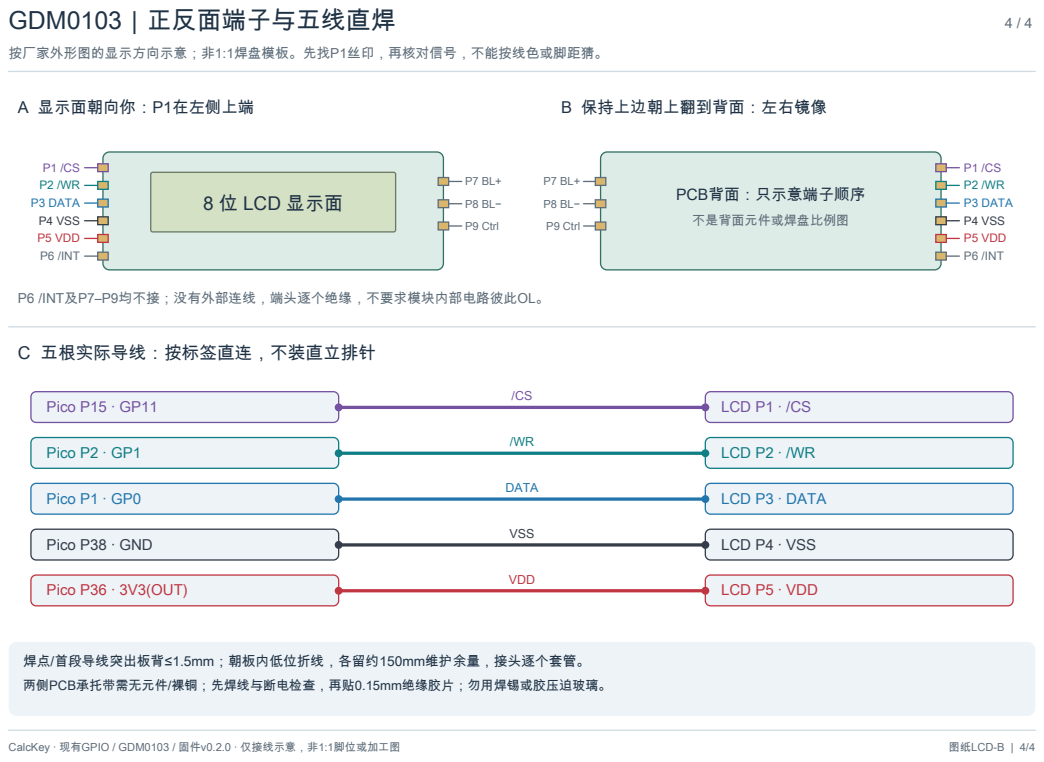
[picture p25: page 4]

焊点/首段导线突出板背≤1.5mm；朝板内低位折线，各留约150mm维护余量，接头逐个套管。
两侧PCB承托带需无元件/裸铜；先焊线与断电检查，再贴0.15mm绝缘胶片；勿用焊锡或胶压迫玻璃。
