Cailynoo7/CalcKey/(list of files, drawings)

Other design files:
product/purchasing/matrix/pcb-order-parameters.json
