Cailynoo7/CalcKey/(commit log)

2026-11-05 docs(hardware): add KS-9 sample procurement guide
    [ks9-sample-dimension-record.csv, switch-fit-record.csv]
2026-11-05 docs(hardware): record confirmed KS-9 model equivalence
    [bom.csv]
2026-11-06 feat(project): finalize CalcKey design and production handoff
    Add the current enclosure source, 28 production meshes, wiring and soldering guides, BOM and reproducible delivery tools. Retain the exact exported STEP and receipt in the verified complete design archive.
    Include LCD firmware v0.2.0 sources, binaries, dependency locks and successful build/test records. Record the user choice to skip printed fit trials and defer flashing. Keep caches and historical OLED/trial deliverables outside this commit.
    [29f4d60beb57a869d233939c629de23319458d225f0be6644fd86258533e3c9d.step, KS-9 Switch KS-9H10B045NN-X14-FB.stp, base.stl, bom.csv, component-check-record.csv, d49ada10d893cfcb07cb4abced0a0a0cadca4c4150f153d874268ca06171a24f.step, hinge_axle_left.stl, hinge_axle_right.stl]
2026-11-06 chore(git): preserve exact CAD and delivery asset bytes
2026-11-06 feat(cad): refine keycap legends and tactile locator
    Add a recessed locator to key 5, two-line Enter/= legends, and shared bold typography for all 20 keycaps.
    Record single-solid, roof-thickness and 4 mm external-travel checks with the matching handoff STEP. Include the immutable matrix assembly asset and CAD structure required to rebuild this assembly.
    Mark previous STL and complete production ZIP as earlier keycap geometry; leave unrelated firmware, PCB branch and trial-part work uncommitted.
    [bom.csv, e2474c585d2693bb16227489b4c195a5ffbfa208a89e1ee4a6da6b9e6b1f5ef2.step, model.step]
2026-11-06 feat(manufacturing): update keycap meshes and complete handoff
    Regenerate all 20 keycap STLs from the current STEP, including the 5-key recess and Enter/= legends. Verify closure, actual mesh features and eight unchanged printed parts.
    Ship the matching complete production ZIP, procurement tables, matrix PCB sources and fabrication release, wiring guides, and LCD v0.2.0 test/build records. Preserve original inspection revisions and pending physical checks.
    Keep render-only release outputs inside the complete ZIP; exclude raw previews, caches, legacy OLED firmware and trial-part work.
    [assembly.step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]
2026-11-06 feat(cad): add harness retention and service clearance
    [bom.csv, hand-assembly-shopping.csv, model.step]
2026-11-06 feat(manufacturing): sync harness case meshes and assembly handoff
    [base.stl, before-runtime-refresh.step, hand-assembly-shopping.csv, model.step, top.stl, unpowered-checklist.csv]
2026-11-06 fix(cad): restore explicit screw seat compatibility
    [before-seat-fix.step, model.step]
2026-11-06 feat(manufacturing): synchronize repaired complete design handoff
    [hand-assembly-shopping.csv, part-settings.csv, unpowered-checklist.csv]
2026-11-07 chore: publish to the community
    [KS-9 Switch KS-9H10B045NN-X14-FB.stp, keycap-fit-record.csv, model.step, switch-keycap-fit-record.csv]
2026-11-07 feat(cad): archive mint enclosure STEP handoff
    [model.step]
2026-11-10 feat(manufacturing): synchronize Type-C complete design handoff
    [KS-9 Switch KS-9H10B045NN-X14-FB.stp, a6dc199a3a4e298685d6ed8e8ca74fd55980cce419e5dcee973fb04c4cd22006.step, base.stl, bom.csv, controller_clamp_a.stl, controller_clamp_b.stl, hand-assembly-shopping.csv, model.step]
